ArrowElectronics/I.IMX8X_AI_ML/Hardware Docs/Block-Diagram/Block_Diagram.jpg

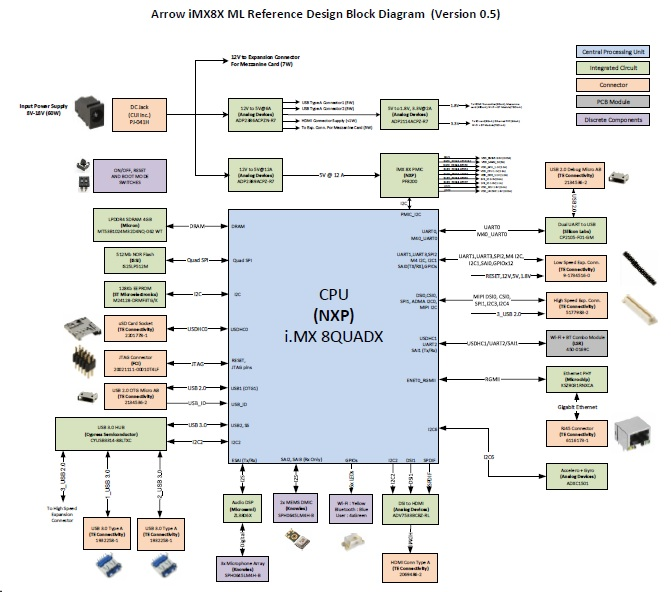
Hardware Docs/Block-Diagram/Block_Diagram.jpg
