ArrowElectronics/I.IMX8X_AI_ML/Kernel_5_4_47/readme.md

To setup the Yocto build environment, run yocto_build_setup_aiml.sh
After completion of the build setup, build SD card image (imx-image-full-imx8mqthor96.wic.bz2) will be generated.

For manual setup, please follow the Yocto_build_manual_step_aiml.txt steps.

Meta-einfochips available here, 
git clone https://github.com/ArrowElectronics/meta-einfochips.git -b ai_ml
