ArrowElectronics/I.IMX8X_AI_ML/Hardware Docs/Schematic/EI_ARROW_IMX8XML_RD_SCHEMATIC.pdf

SCH. REV.

# MAJOR REVISION HISTORY :

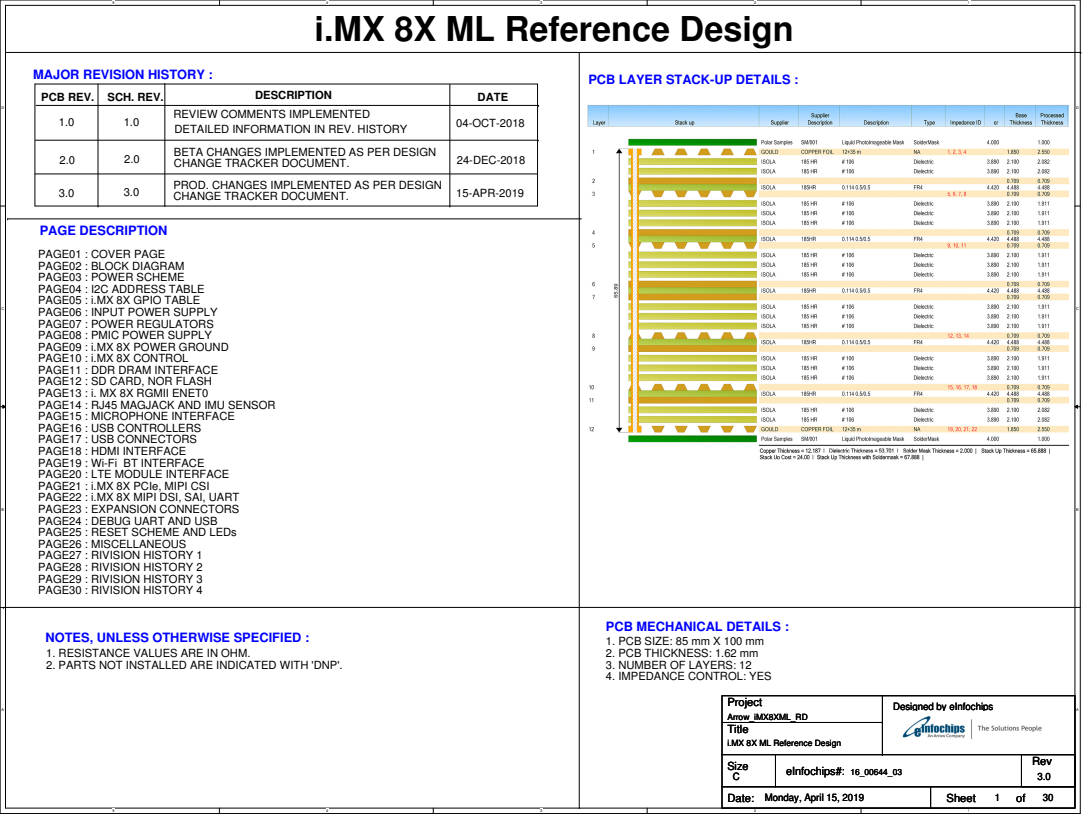
[picture p87: page 1]
PAGE DESCRIPTION; PCB REV.; DESCRIPTION; DATE; 24-DEC-2018 BETA CHANGES IMPLEMENTED AS PER DESIGN CHANGE TRACKER DOCUMENT.; CHANGE TRACKER DOCUMENT. 3.0; 15-APR-2019; Size; Rev; Date:; Sheet; eInfochips#:; Monday, April 15, 2019

i.MX 8X ML Reference Design

PCB LAYER STACK-UP DETAILS :

REVIEW COMMENTS IMPLEMENTED
04-OCT-2018 DETAILED INFORMATION IN REV. HISTORY

PROD. CHANGES IMPLEMENTED AS PER DESIGN

PAGE01 : COVER PAGE
PAGE02 : BLOCK DIAGRAM
PAGE03 : POWER SCHEME
PAGE04 : I2C ADDRESS TABLE
PAGE05 : i.MX 8X GPIO TABLE
PAGE06 : INPUT POWER SUPPLY
PAGE07 : POWER REGULATORS
PAGE08 : PMIC POWER SUPPLY
PAGE09 : i.MX 8X POWER GROUND
PAGE10 : i.MX 8X CONTROL
PAGE11 : DDR DRAM INTERFACE
PAGE12 : SD CARD, NOR FLASH
PAGE13 : i. MX 8X RGMII ENET0
PAGE14 : RJ45 MAGJACK AND IMU SENSOR
PAGE15 : MICROPHONE INTERFACE
PAGE16 : USB CONTROLLERS
PAGE17 : USB CONNECTORS
PAGE18 : HDMI INTERFACE
PAGE19 : Wi-Fi BT INTERFACE
PAGE20 : LTE MODULE INTERFACE
PAGE21 : i.MX 8X PCIe, MIPI CSI
PAGE22 : i.MX 8X MIPI DSI, SAI, UART
PAGE23 : EXPANSION CONNECTORS
PAGE24 : DEBUG UART AND USB
PAGE25 : RESET SCHEME AND LEDs
PAGE26 : MISCELLANEOUS
PAGE27 : RIVISION HISTORY 1
PAGE28 : RIVISION HISTORY 2
PAGE29 : RIVISION HISTORY 3
PAGE30 : RIVISION HISTORY 4

PCB MECHANICAL DETAILS :
1. PCB SIZE: 85 mm X 100 mm
2. PCB THICKNESS: 1.62 mm
3. NUMBER OF LAYERS: 12
4. IMPEDANCE CONTROL: YES

NOTES, UNLESS OTHERWISE SPECIFIED :
1. RESISTANCE VALUES ARE IN OHM.
2. PARTS NOT INSTALLED ARE INDICATED WITH 'DNP'.

Project
Arrow_iMX8XML_RD
Title

Designed by eInfochips

# BLOCK DIAGRAM

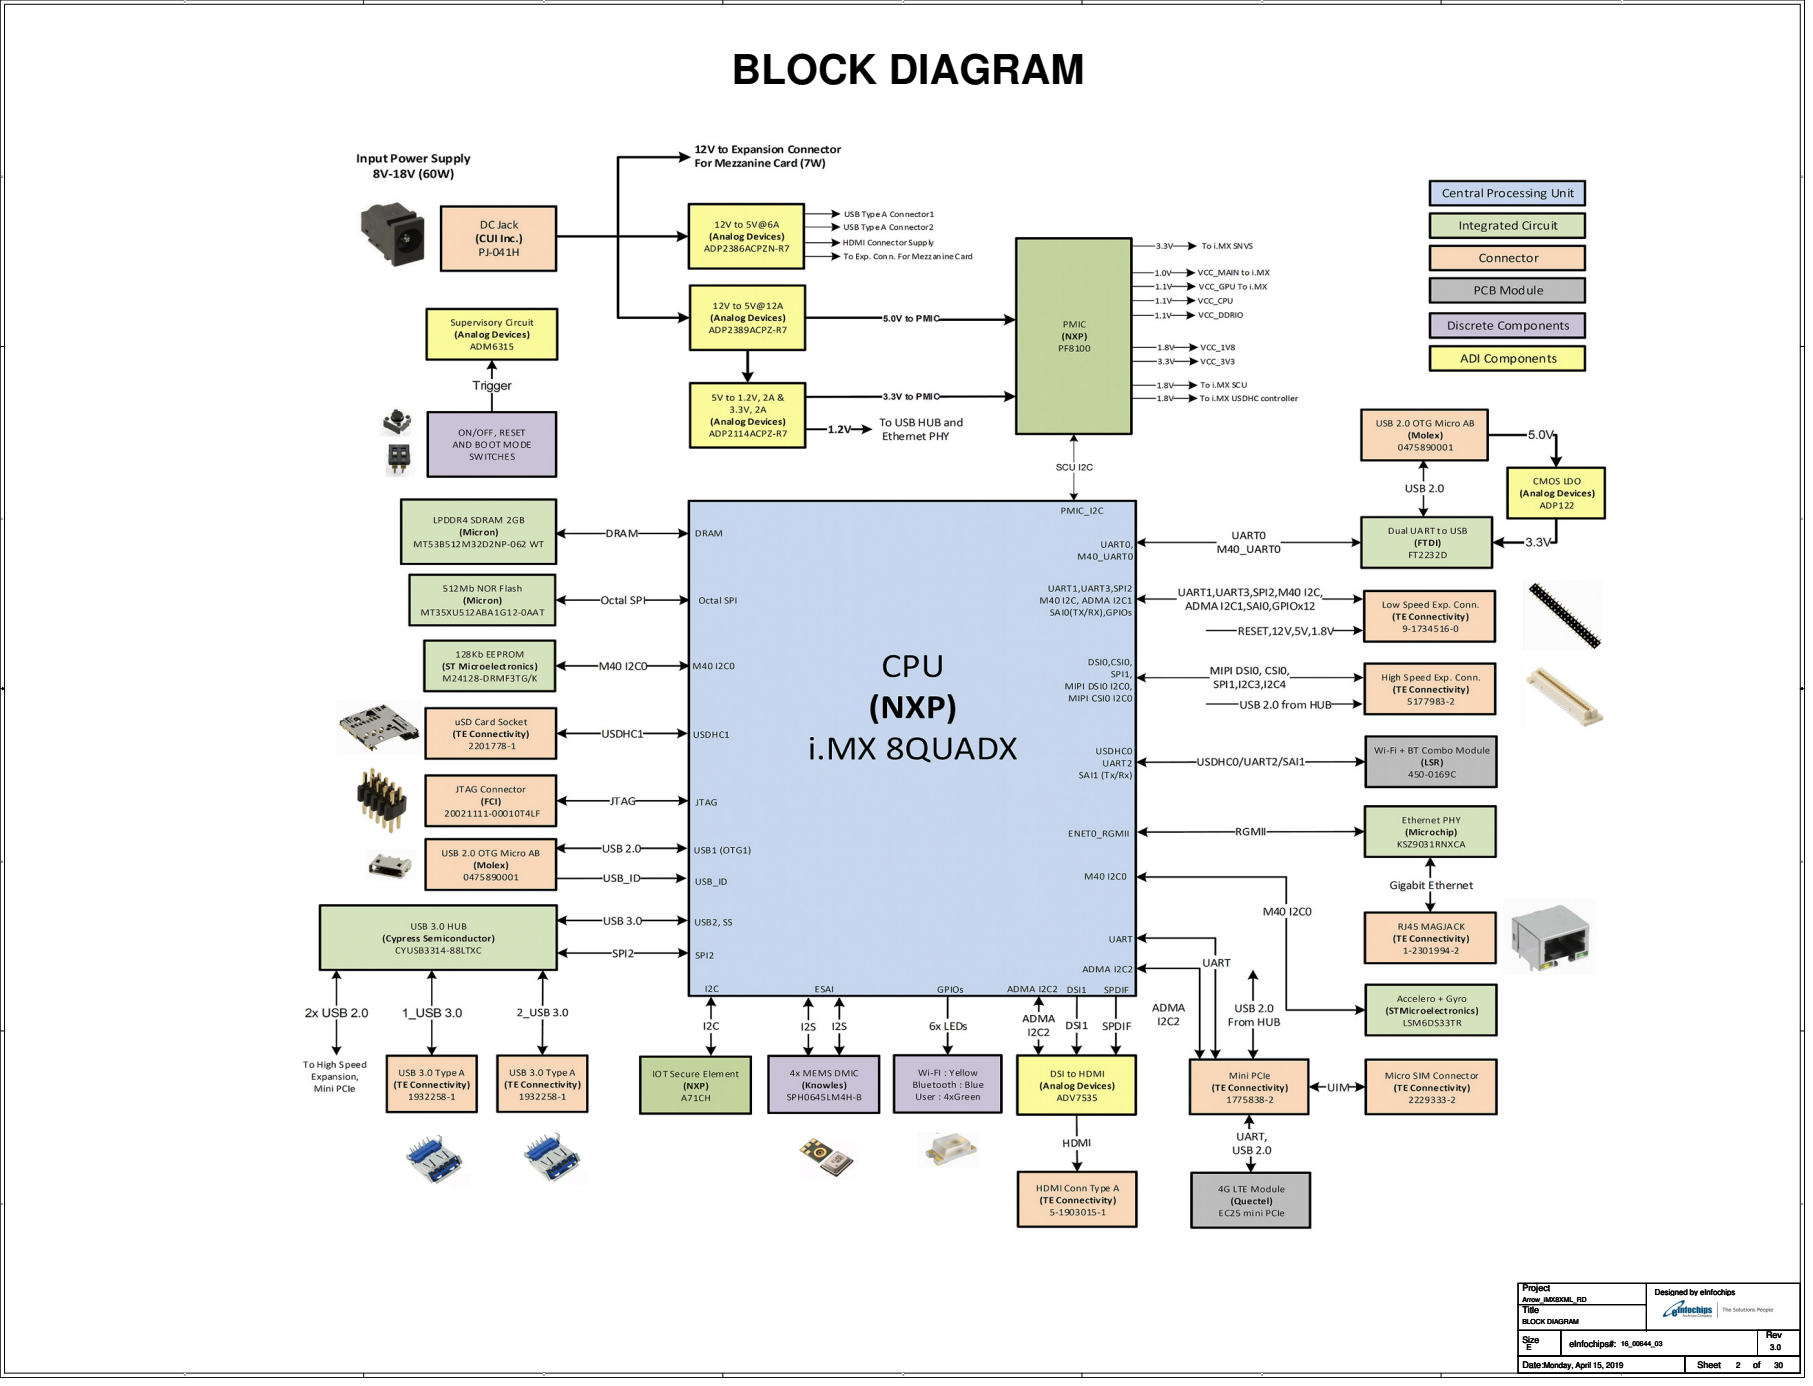
[picture p88: page 2]
Title; Project; Monday, April 15, 2019; Arrow_iMX8XML_RD; BLOCK DIAGRAM

Designed by eInfochips

# POWER SCHEME

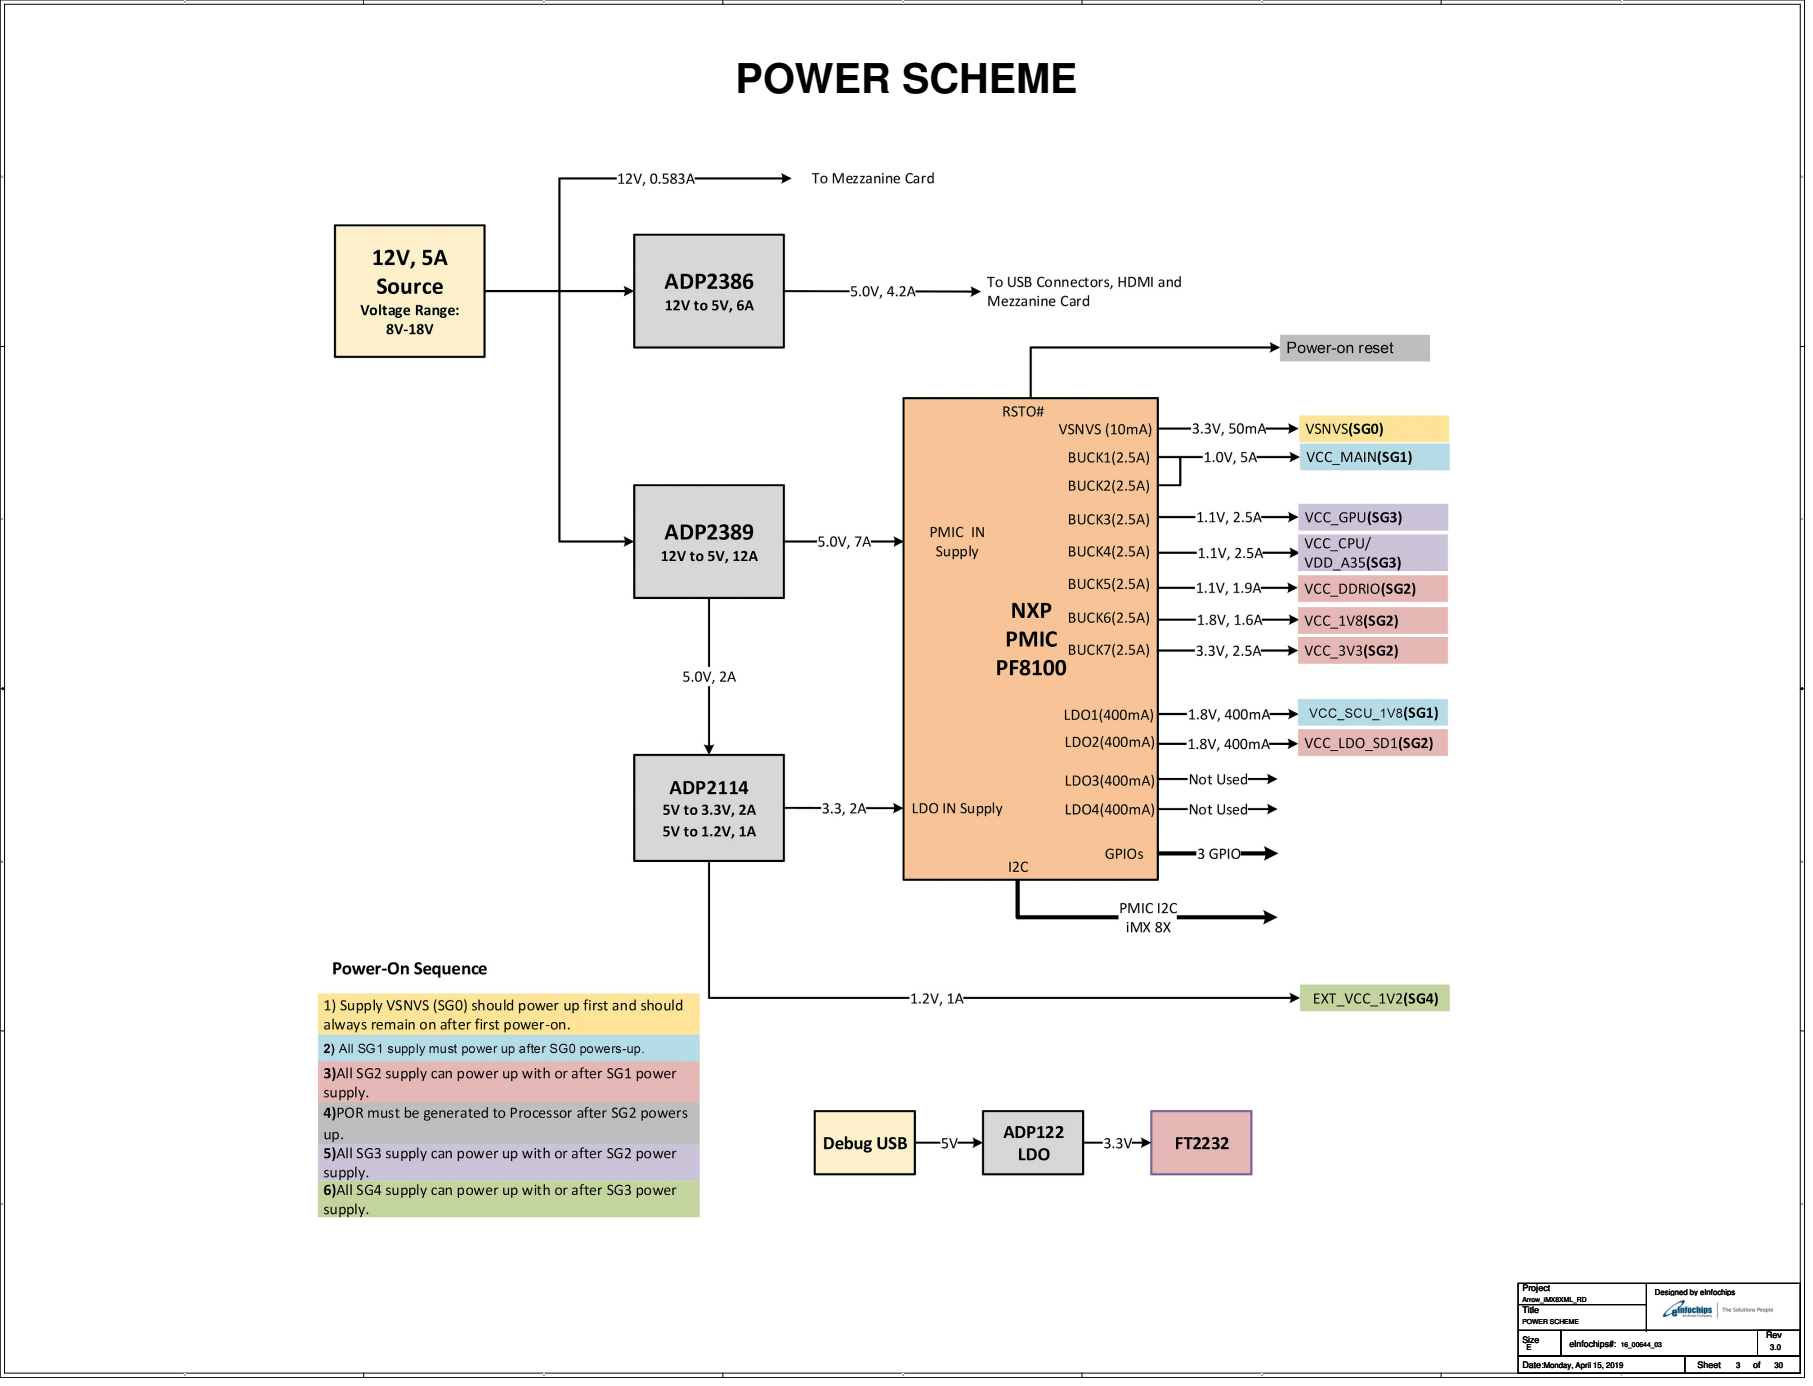
[picture p89: page 3]
Title; Project; Monday, April 15, 2019; Arrow_iMX8XML_RD; POWER SCHEME

Designed by eInfochips

# I2C ADDRESS TABLE

DEVICE | I2C

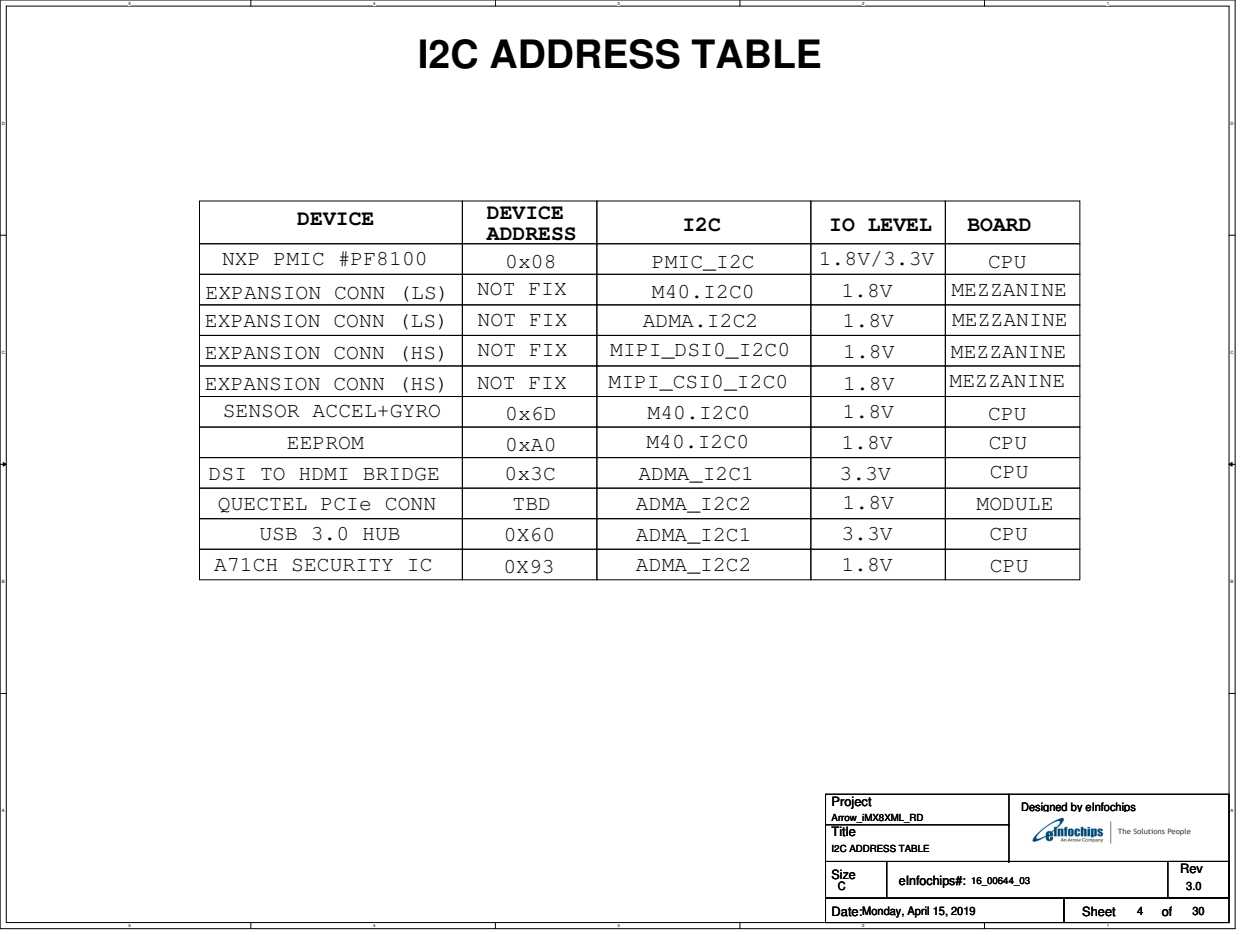
[picture p90: page 4]
NOT FIX; NXP PMIC #PF8100; CPU; MODULE; EEPROM; ADMA.I2C2; PMIC_I2C; DEVICE ADDRESS; TBD; BOARD; MIPI_CSI0_I2C0; MEZZANINE; ADMA_I2C1; ADMA_I2C2; MIPI_DSI0_I2C0; IO LEVEL; Title; Project; Monday, April 15, 2019; Arrow_iMX8XML_RD; I2C ADDRESS TABLE

EXPANSION CONN (LS)
EXPANSION CONN (HS)
SENSOR ACCEL+GYRO

DSI TO HDMI BRIDGE
QUECTEL PCIe CONN
USB 3.0 HUB
A71CH SECURITY IC

Designed by eInfochips

# i.MX 8X GPIO TABLE

# GPIO BANK3

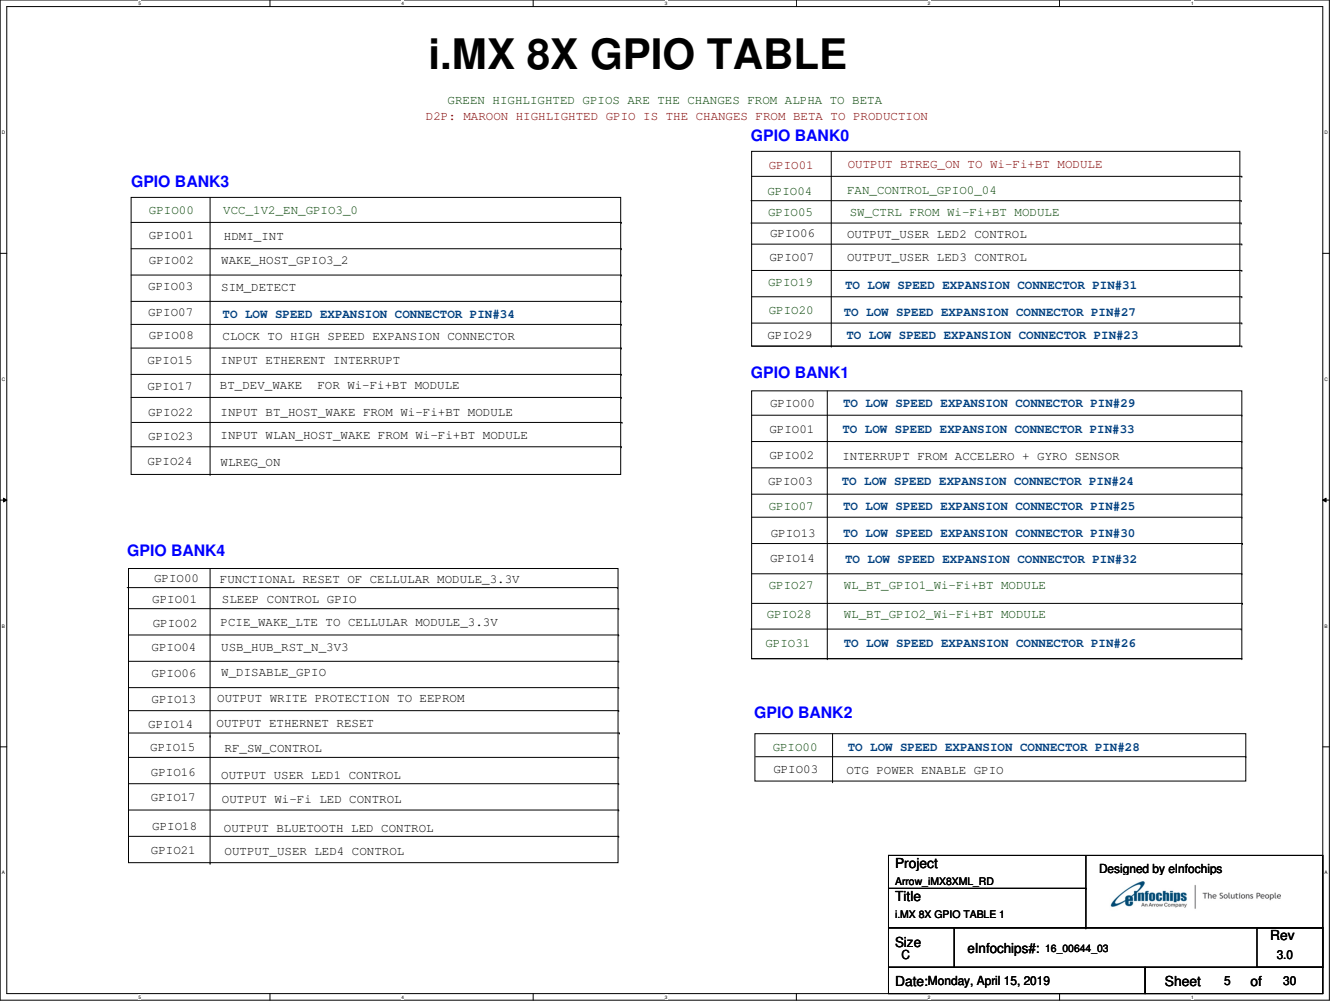
[picture p91: page 5]
GPIO22; GPIO15; GPIO23; BT_DEV_WAKE; FOR Wi-Fi+BT MODULE; GPIO02; GPIO17; SIM_DETECT; GPIO08; CLOCK TO HIGH SPEED EXPANSION CONNECTOR; GPIO07; GPIO01; GPIO00; GPIO03; HDMI_INT; WLREG_ON; VCC_1V2_EN_GPIO3_0; WAKE_HOST_GPIO3_2; GPIO24; GPIO04; FAN_CONTROL_GPIO0_04; GPIO19; GPIO29; GPIO20; GPIO BANK2; OUTPUT_USER LED2 CONTROL; OUTPUT_USER LED3 CONTROL; GPIO06; GPIO BANK0; GPIO05; GPIO28; GPIO BANK1; INTERRUPT FROM ACCELERO + GYRO SENSOR; GPIO14; GPIO13; GPIO27; GPIO31; GPIO18; W_DISABLE_GPIO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

GREEN HIGHLIGHTED GPIOS ARE THE CHANGES FROM ALPHA TO BETA
D2P: MAROON HIGHLIGHTED GPIO IS THE CHANGES FROM BETA TO PRODUCTION

SW_CTRL FROM Wi-Fi+BT MODULE

TO LOW SPEED EXPANSION CONNECTOR PIN#31

TO LOW SPEED EXPANSION CONNECTOR PIN#34

TO LOW SPEED EXPANSION CONNECTOR PIN#27

TO LOW SPEED EXPANSION CONNECTOR PIN#23

INPUT ETHERENT INTERRUPT

TO LOW SPEED EXPANSION CONNECTOR PIN#29

INPUT BT_HOST_WAKE FROM Wi-Fi+BT MODULE

TO LOW SPEED EXPANSION CONNECTOR PIN#33

INPUT WLAN_HOST_WAKE FROM Wi-Fi+BT MODULE

TO LOW SPEED EXPANSION CONNECTOR PIN#24

TO LOW SPEED EXPANSION CONNECTOR PIN#25

TO LOW SPEED EXPANSION CONNECTOR PIN#30

TO LOW SPEED EXPANSION CONNECTOR PIN#32

FUNCTIONAL RESET OF CELLULAR MODULE_3.3V
SLEEP CONTROL GPIO

WL_BT_GPIO1_Wi-Fi+BT MODULE

WL_BT_GPIO2_Wi-Fi+BT MODULE

TO LOW SPEED EXPANSION CONNECTOR PIN#26

OUTPUT WRITE PROTECTION TO EEPROM

OUTPUT ETHERNET RESET

TO LOW SPEED EXPANSION CONNECTOR PIN#28

OUTPUT USER LED1 CONTROL

OTG POWER ENABLE GPIO

OUTPUT Wi-Fi LED CONTROL

OUTPUT BLUETOOTH LED CONTROL

Designed by eInfochips

# INPUT POWER SUPPLY

# INPUT POWER & PROTECTION CIRCUIT

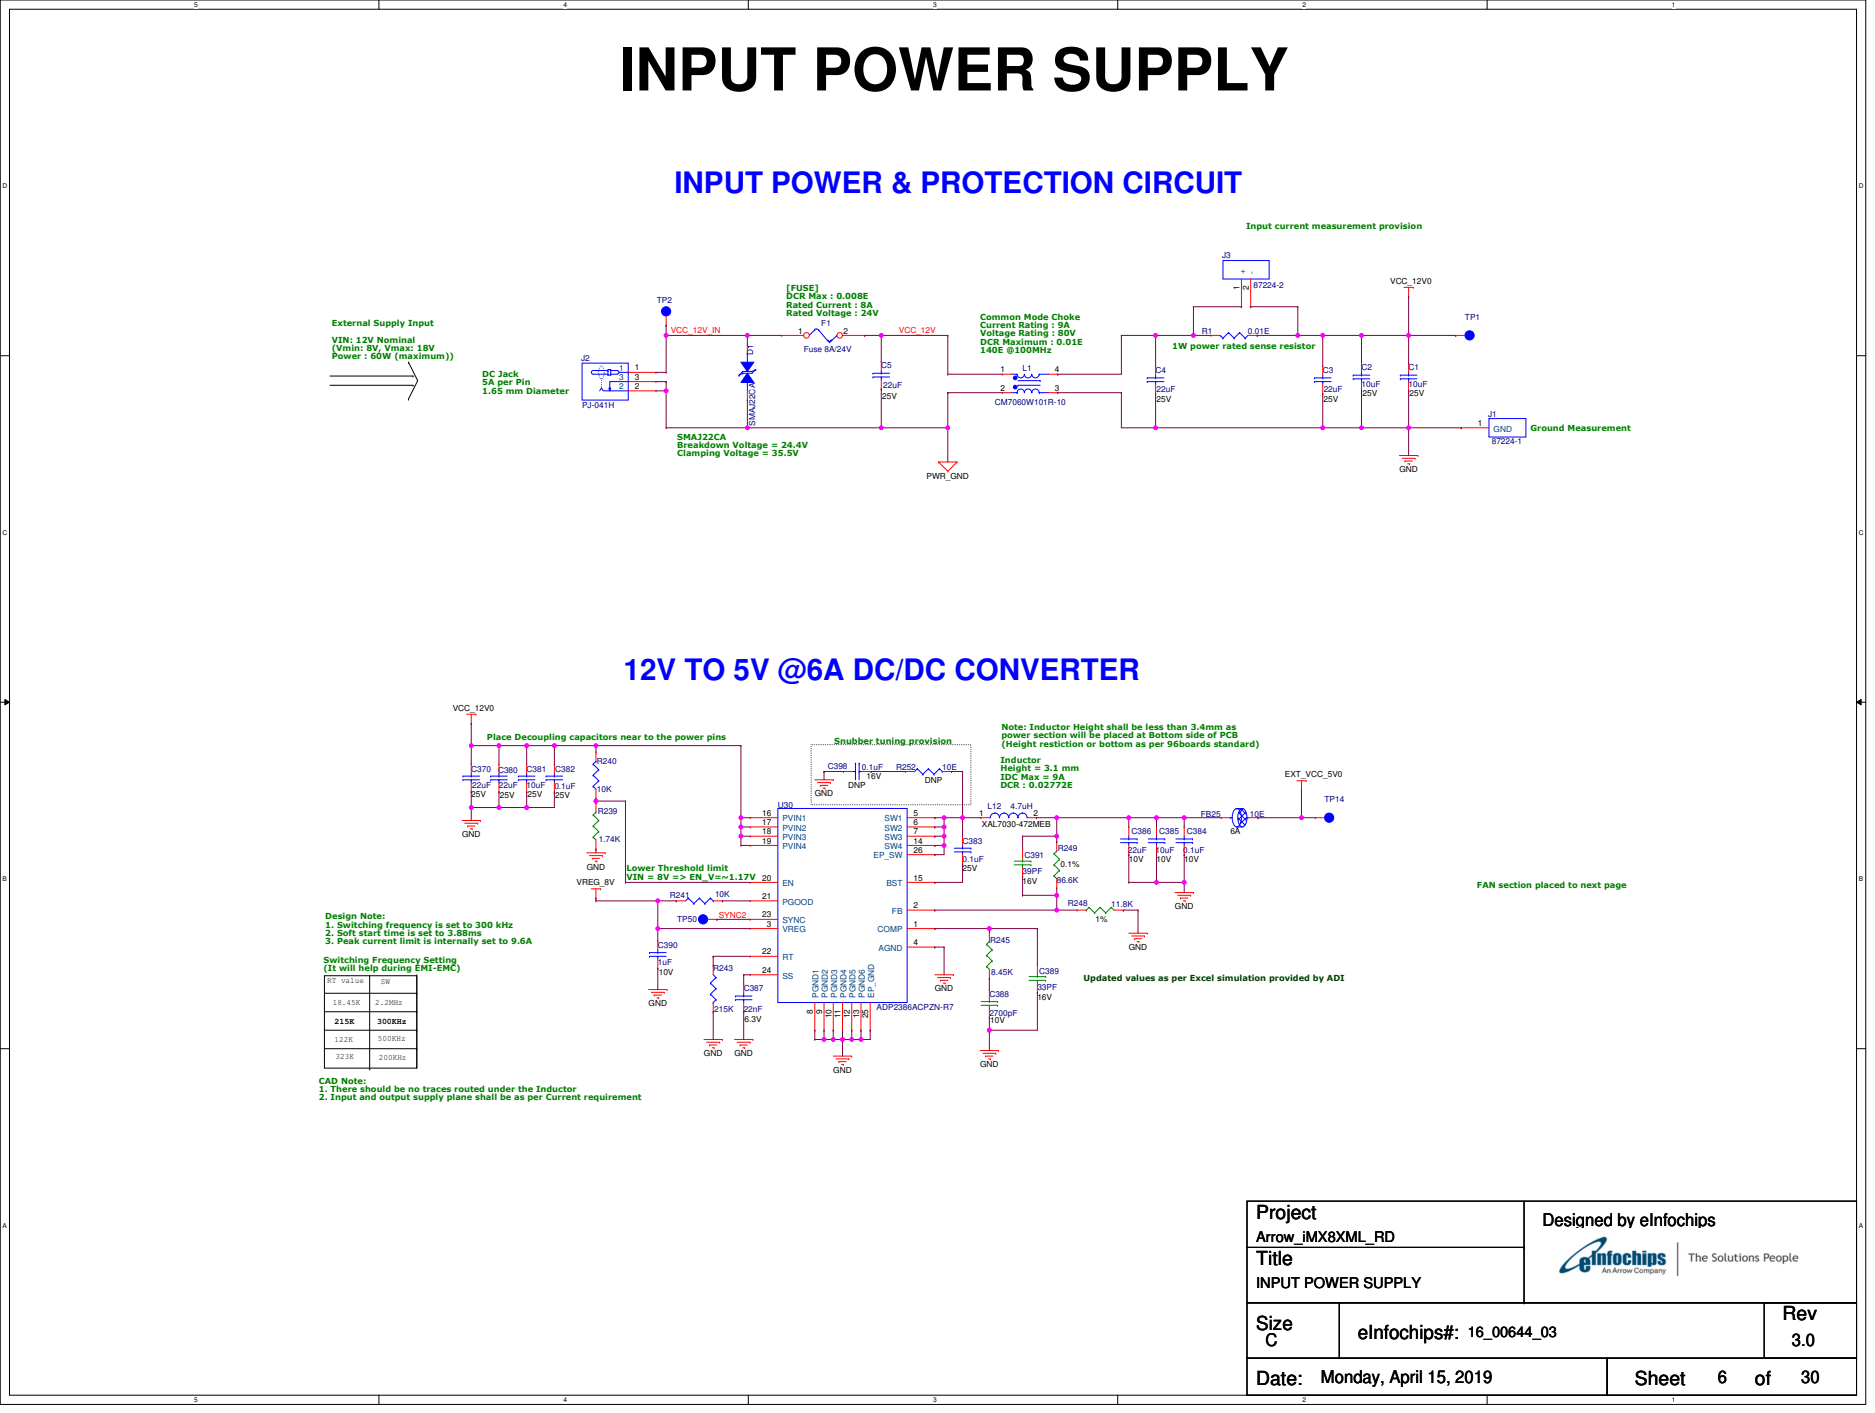
[picture p92: page 6]

Input current measurement provision

1W power rated sense resistor

12V TO 5V @6A DC/DC CONVERTER

Note: Inductor Height shall be less than 3.4mm as
power section will be placed at Bottom side of PCB
(Height restiction or bottom as per 96boards standard)

Place Decoupling capacitors near to the power pins

FAN section placed to next page

Design Note:
1. Switching frequency is set to 300 kHz
2. Soft start time is set to 3.88ms
3. Peak current limit is internally set to 9.6A

Switching Frequency Setting
(It will help during EMI-EMC)

Updated values as per Excel simulation provided by ADI

CAD Note:
1. There should be no traces routed under the Inductor
2. Input and output supply plane shall be as per Current requirement

# POWER REGULATORS

# 12V TO 5V @12A DC/DC CONVERTER

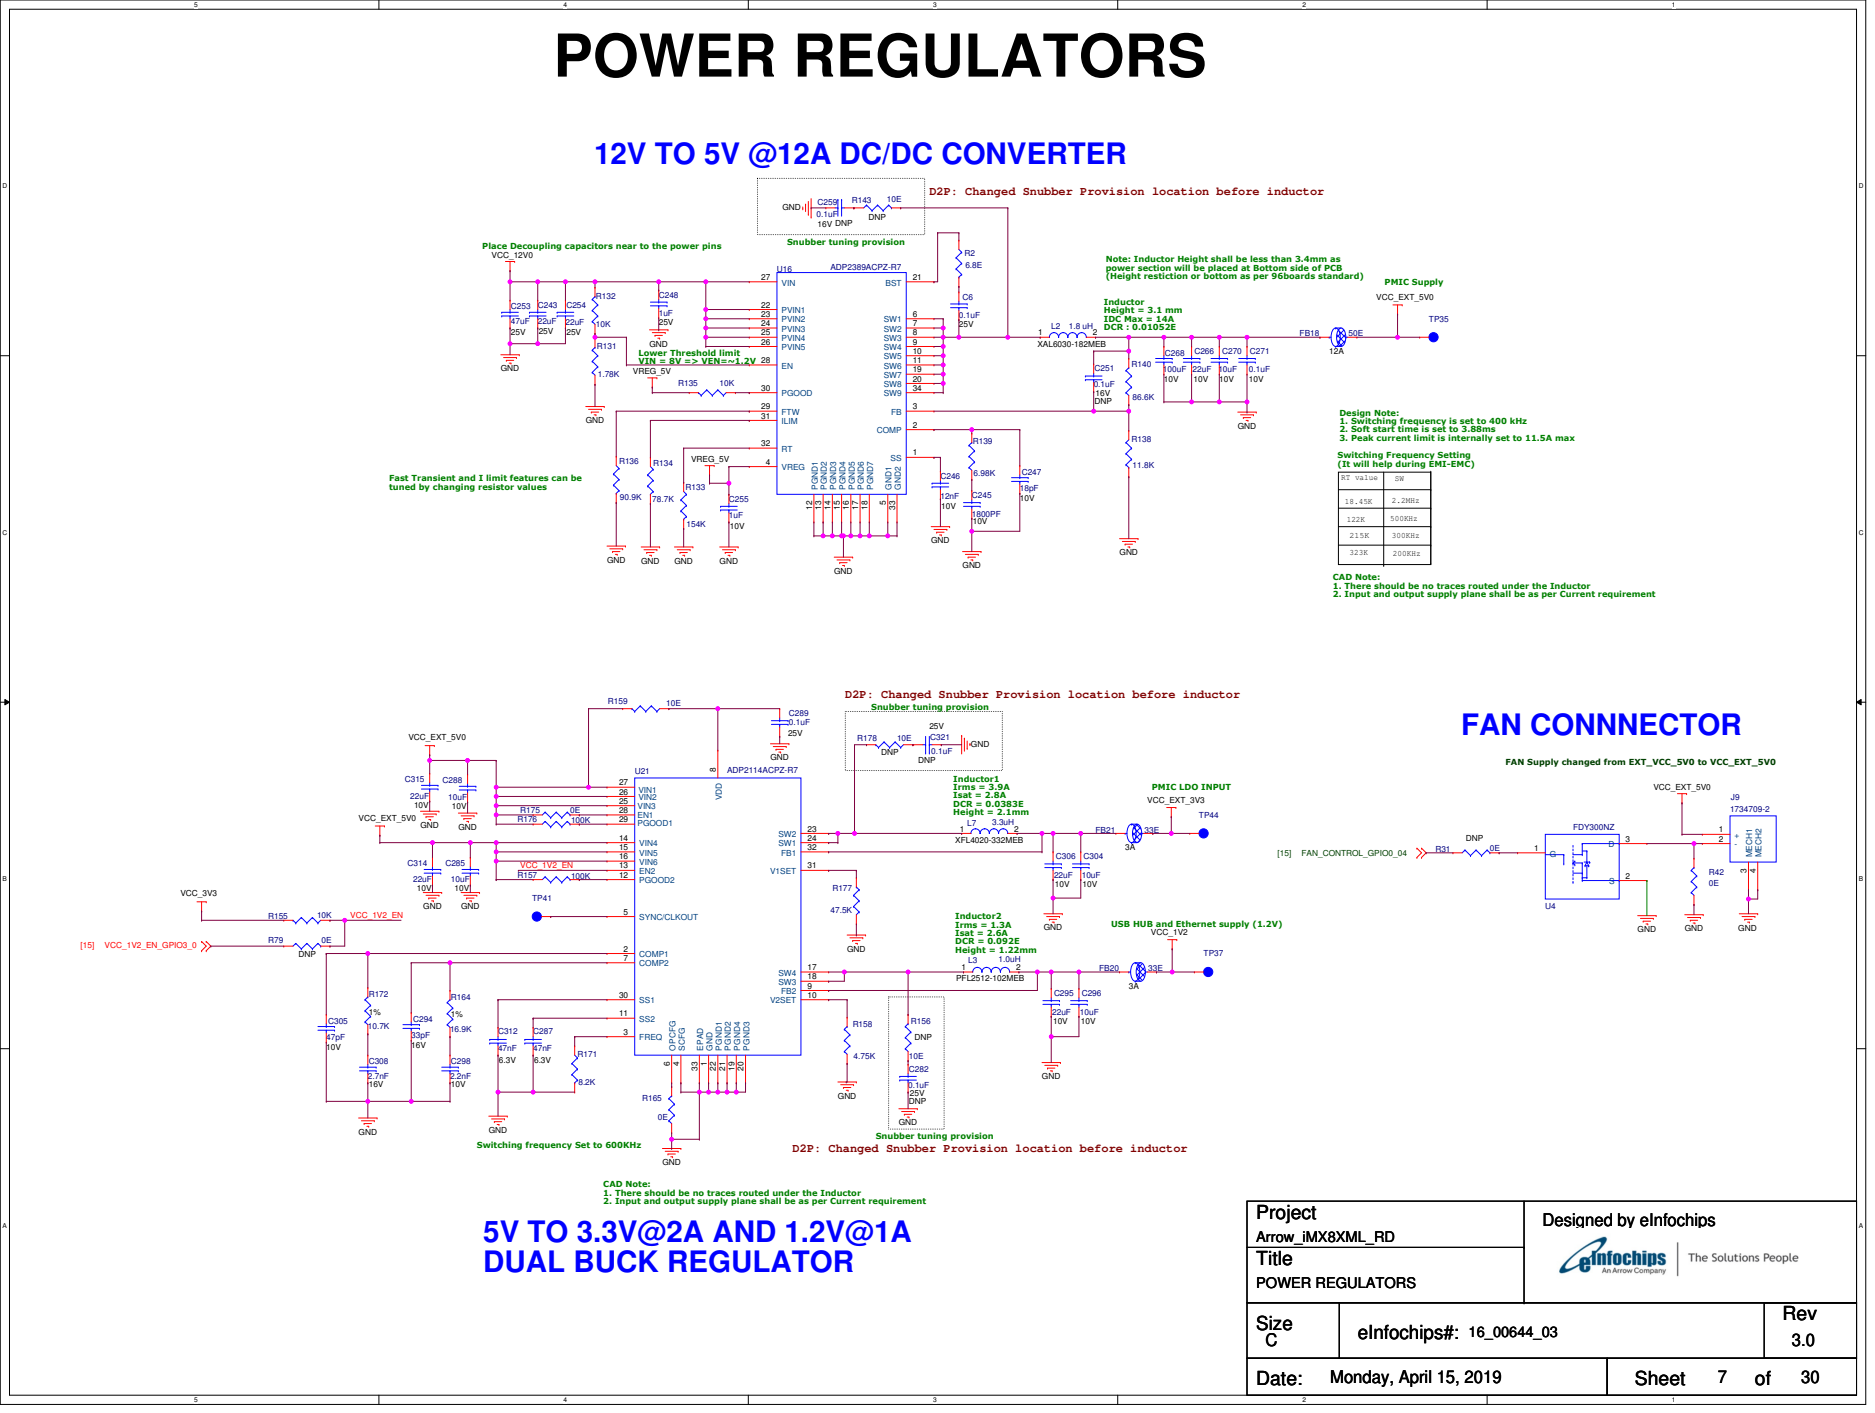
[picture p93: page 7]

D2P: Changed Snubber Provision location before inductor

Place Decoupling capacitors near to the power pins
VCC_12V0

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

Design Note:
1. Switching frequency is set to 400 kHz
2. Soft start time is set to 3.88ms
3. Peak current limit is internally set to 11.5A max

Switching Frequency Setting
(It will help during EMI-EMC)

Fast Transient and I limit features can be
tuned by changing resistor values

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

FAN Supply changed from EXT_VCC_5V0 to VCC_EXT_5V0

USB HUB and Ethernet supply (1.2V)

Switching frequency Set to 600KHz

# PMIC POWER SUPPLY AND LDOS

# Whole PMIC section is newely added

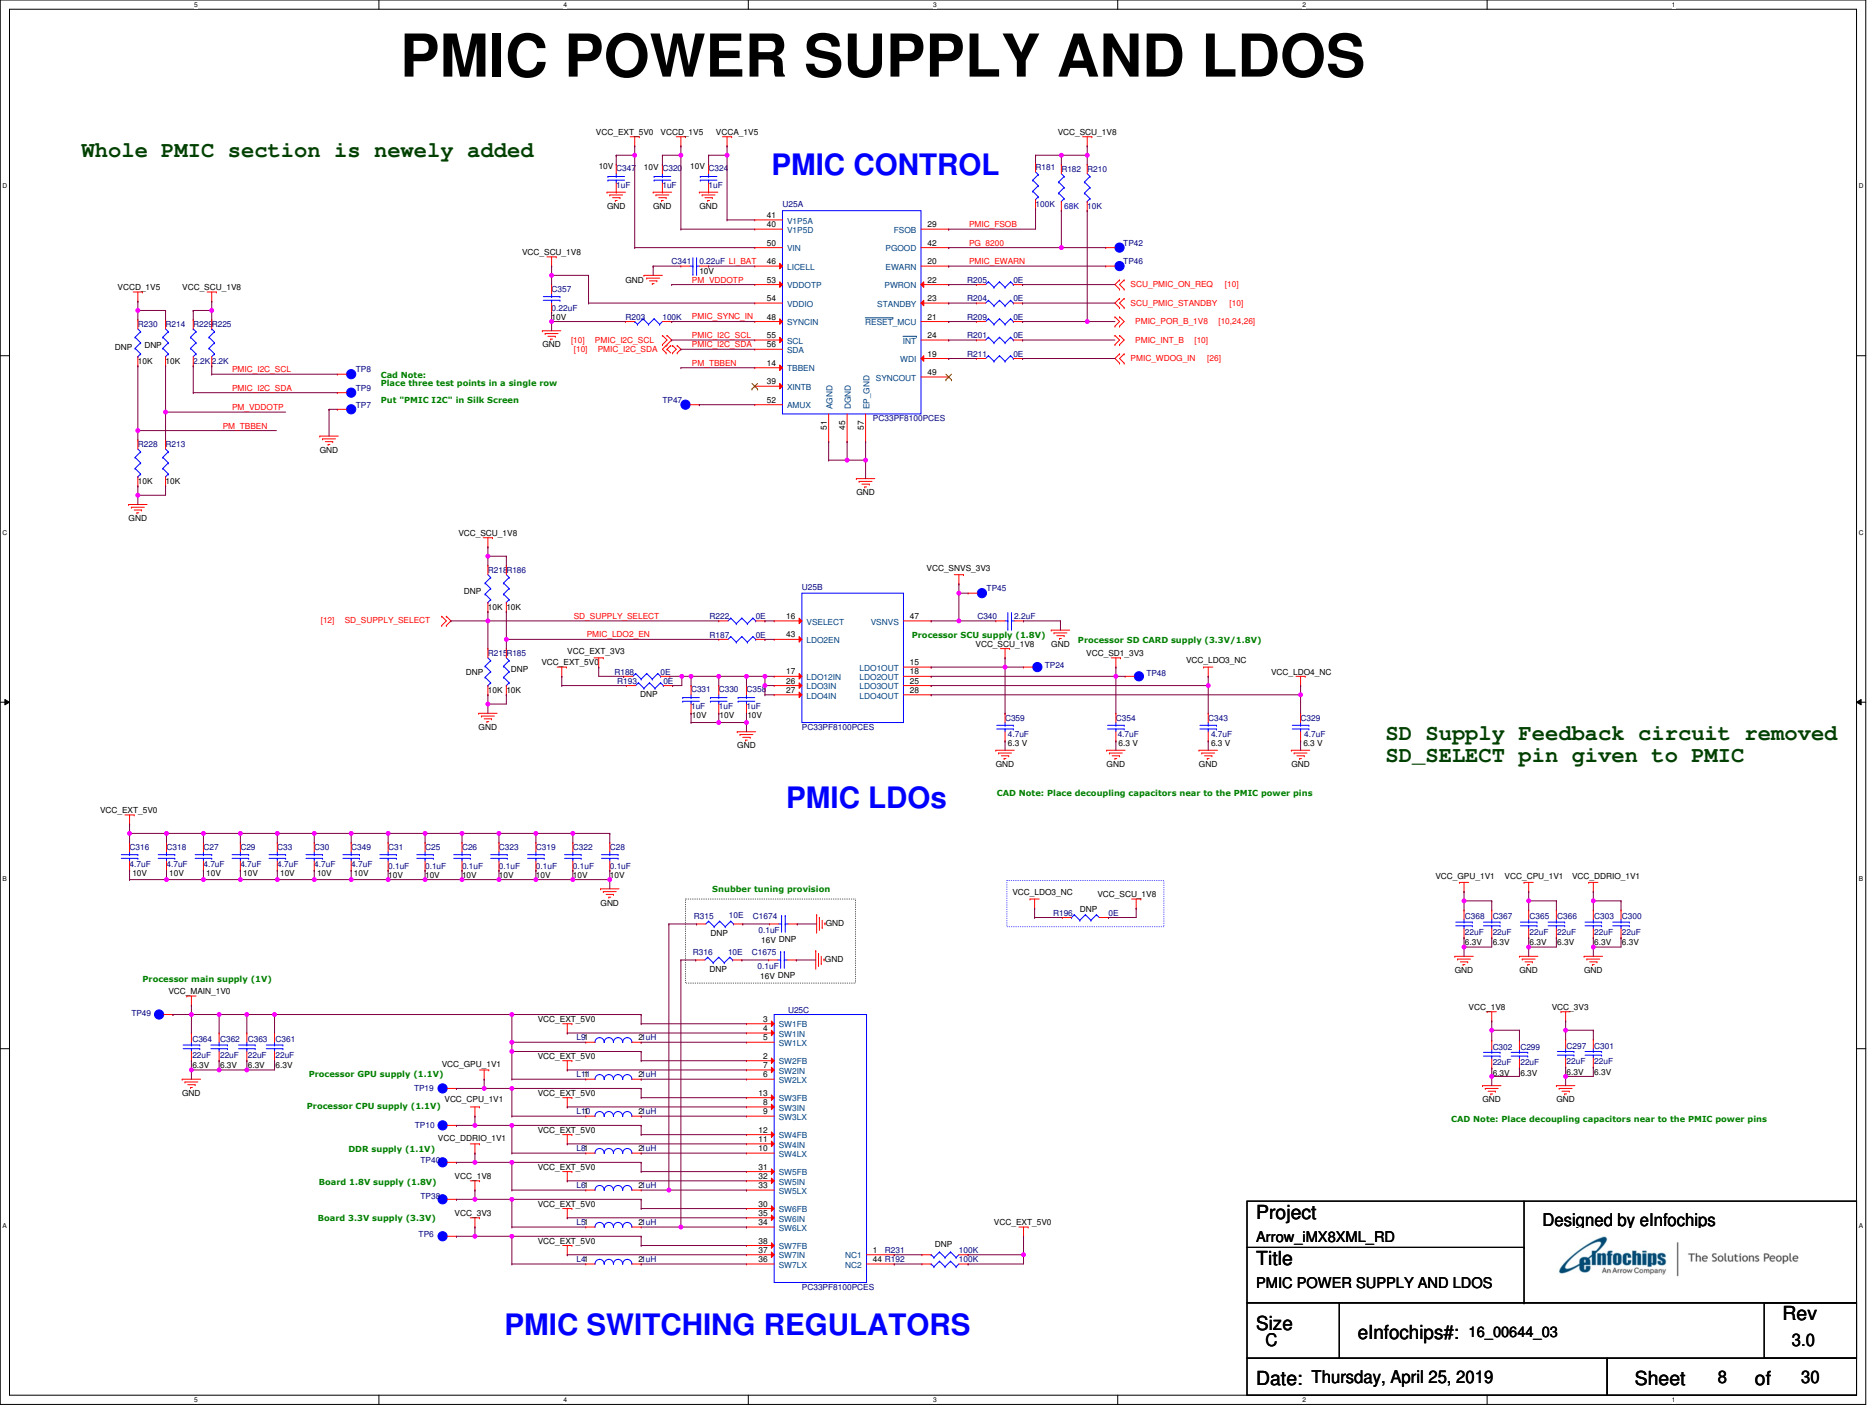
[picture p94: page 8]

Cad Note:
Place three test points in a single row
Put "PMIC I2C" in Silk Screen

SD Supply Feedback circuit removed
SD_SELECT pin given to PMIC

CAD Note: Place decoupling capacitors near to the PMIC power pins

# i.MX 8X POWER GROUND

# i.MX 8X GROUND

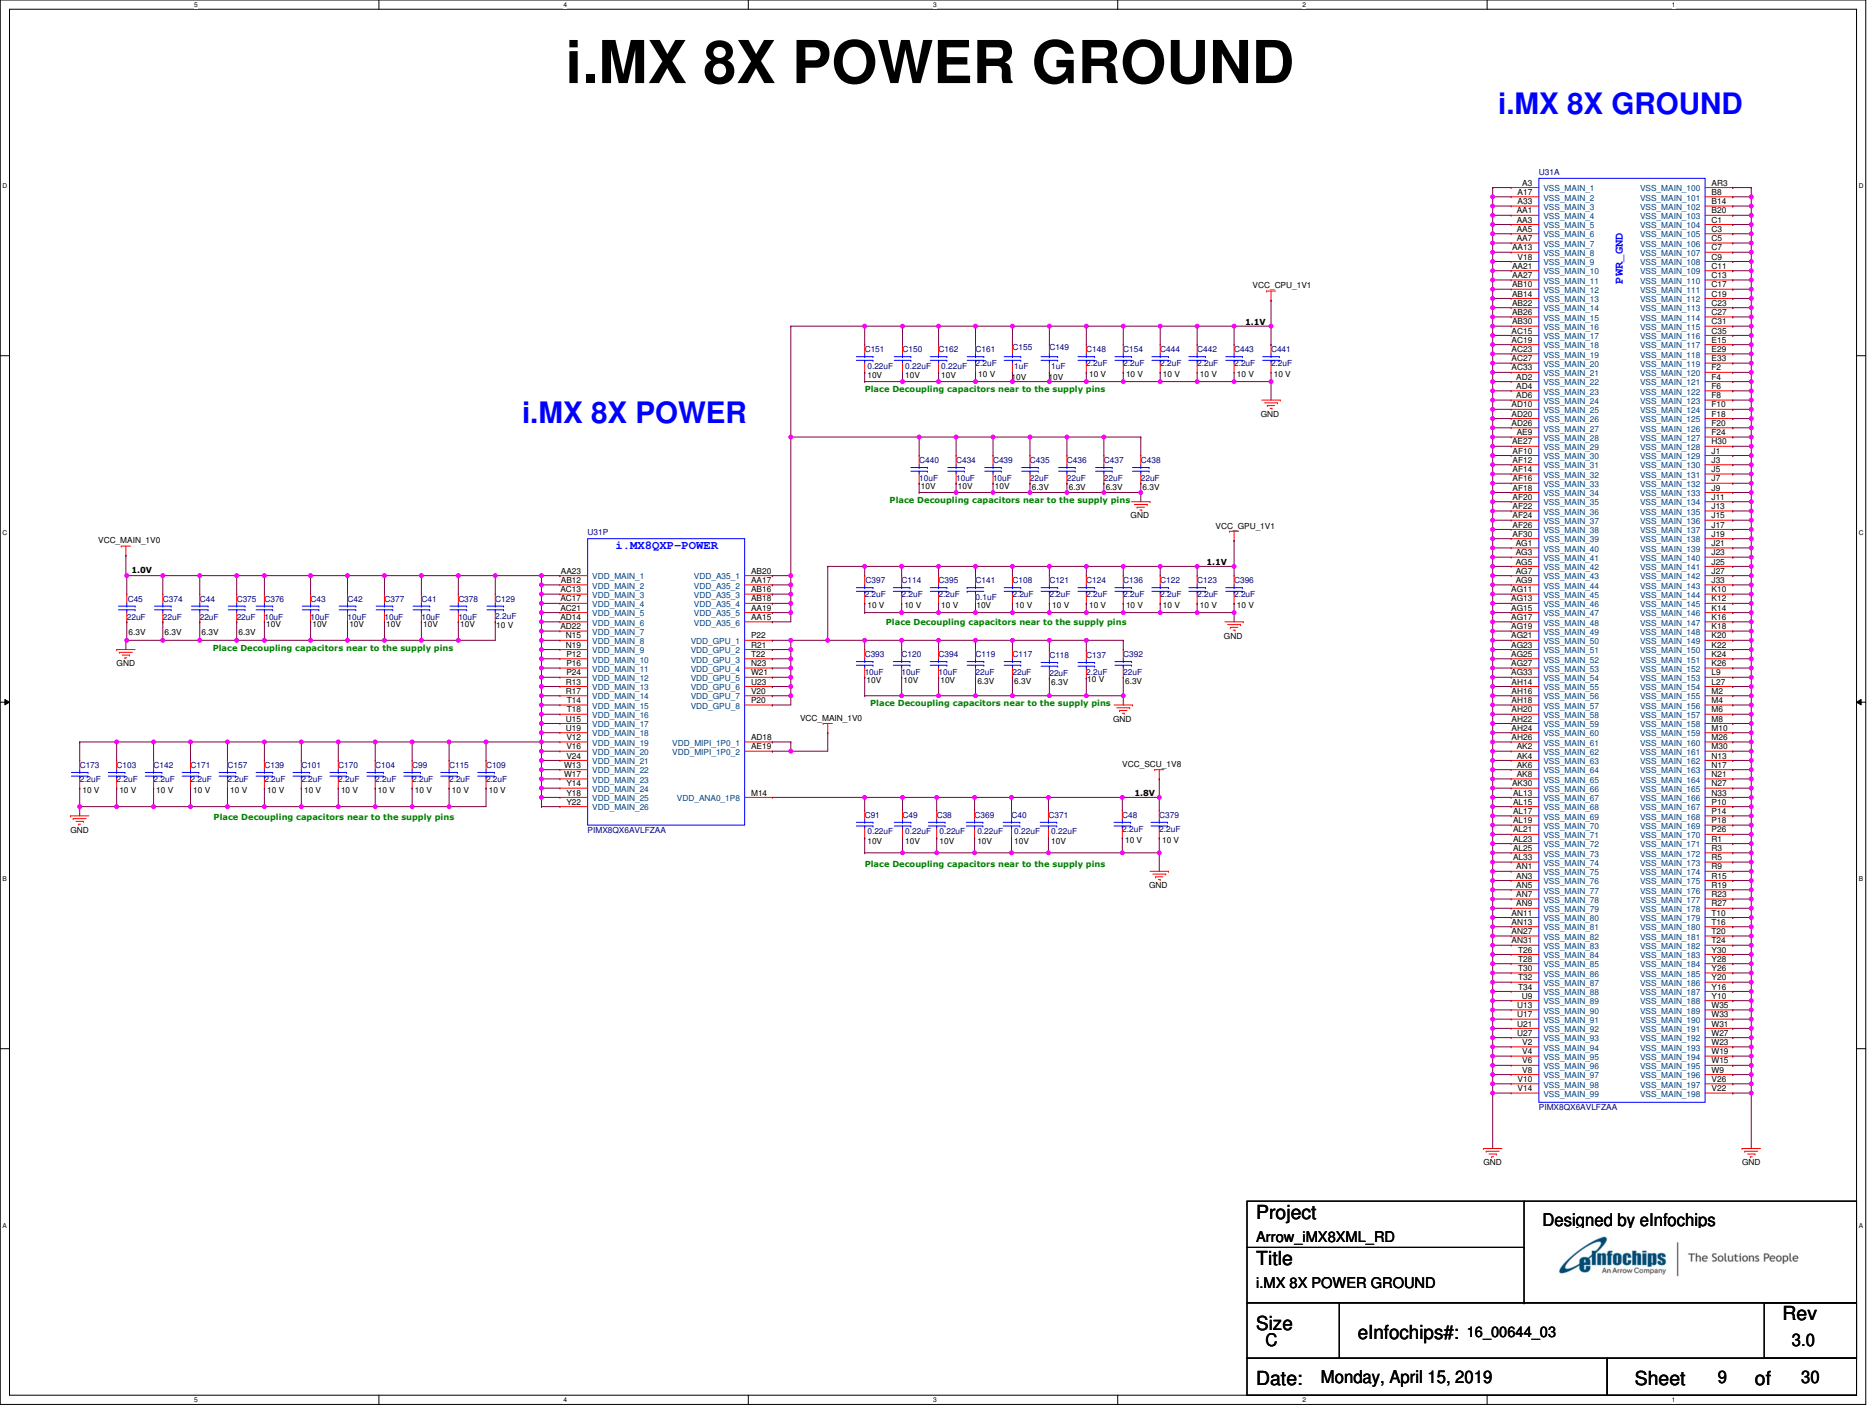
[picture p95: page 9]

Place Decoupling capacitors near to the supply pins

# i.MX 8X CONTROL

### i.MX8QXP-SYSTEM

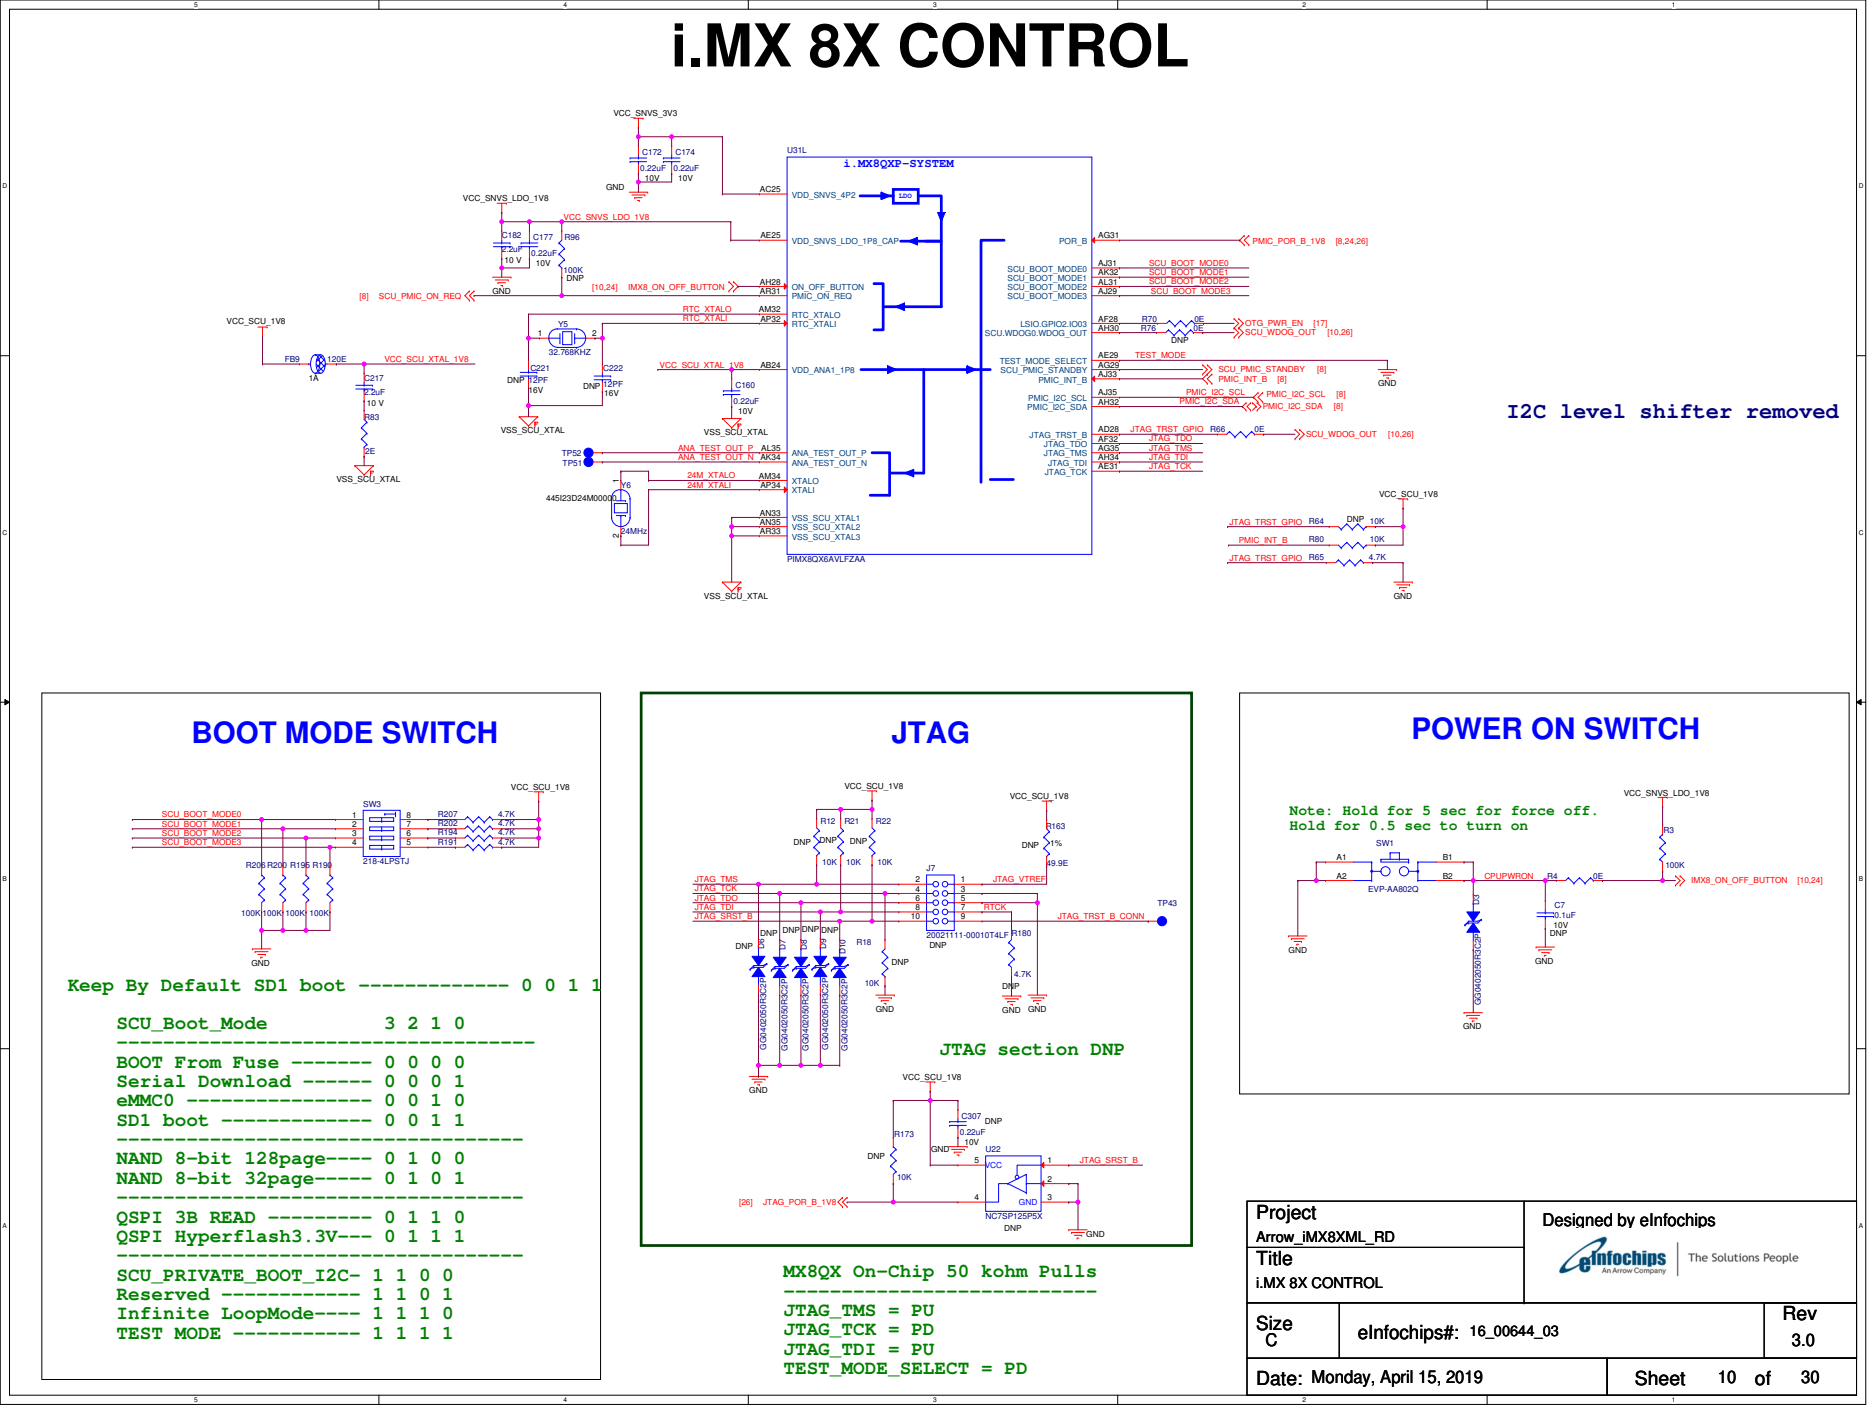
[picture p96: page 10]

Note: Hold for 5 sec for force off.
Hold for 0.5 sec to turn on

Keep By Default SD1 boot ------------- 0 0 1 1

NAND 8-bit 32page----- 0 1 0 1 ----------------------------------- QSPI 3B READ --------- 0 1 1 0

# DDR DRAM INTERFACE

## Place Decoupling capacitors near to pins

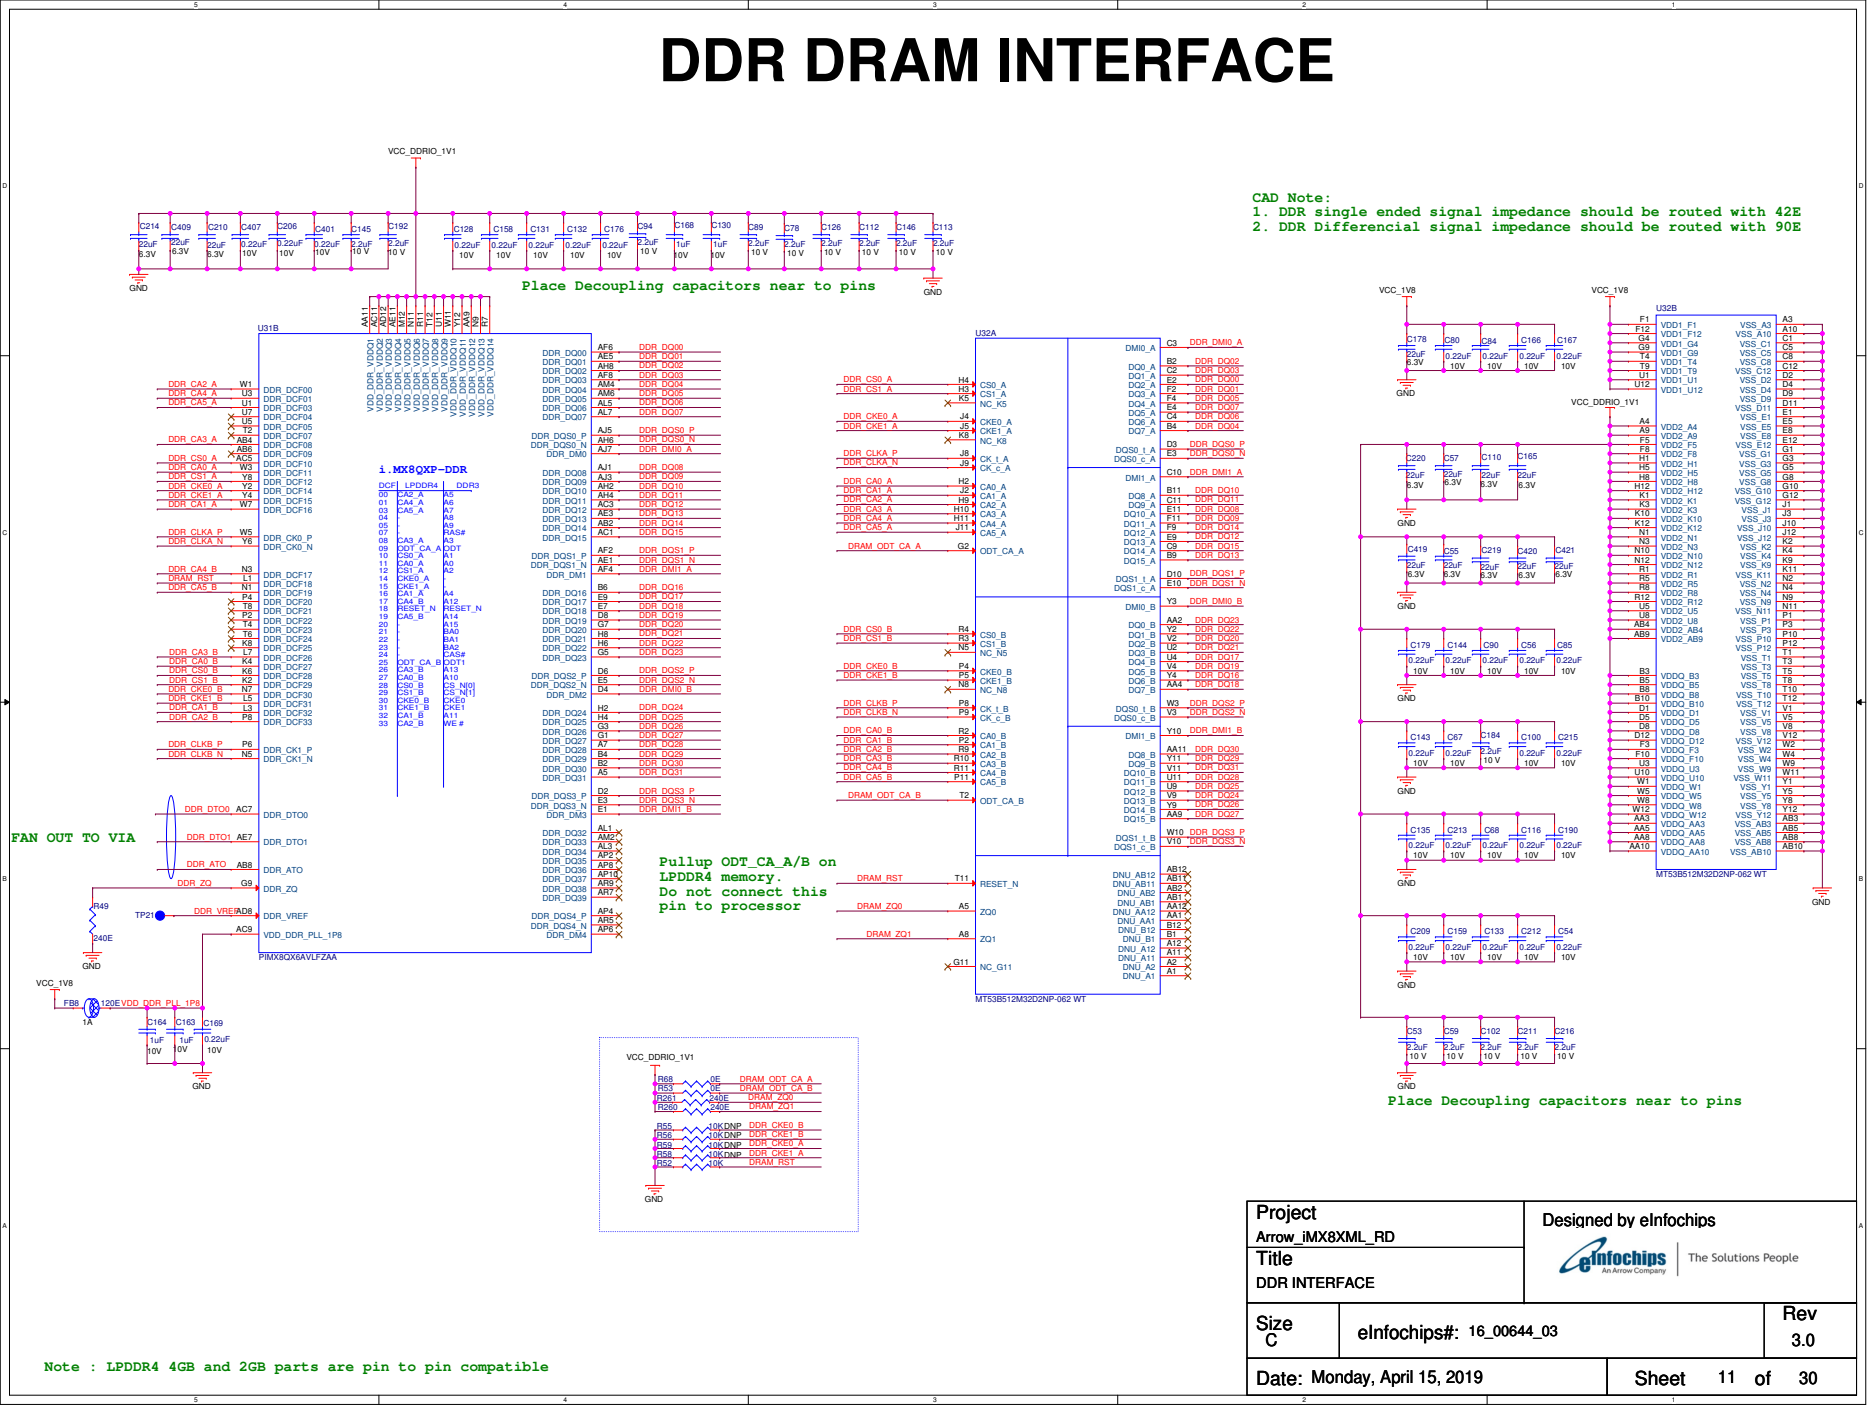
[picture p97: page 11]

CAD Note:
1. DDR single ended signal impedance should be routed with 42E
2. DDR Differencial signal impedance should be routed with 90E

FAN OUT TO VIA

Pullup ODT_CA_A/B on
LPDDR4 memory.
Do not connect this
pin to processor

GND
Place Decoupling capacitors near to pins

Note : LPDDR4 4GB and 2GB parts are pin to pin compatible

# SD CARD, NOR FLASH AND EEPROM

### 1.8Volt QSPI0A and QSPI0B

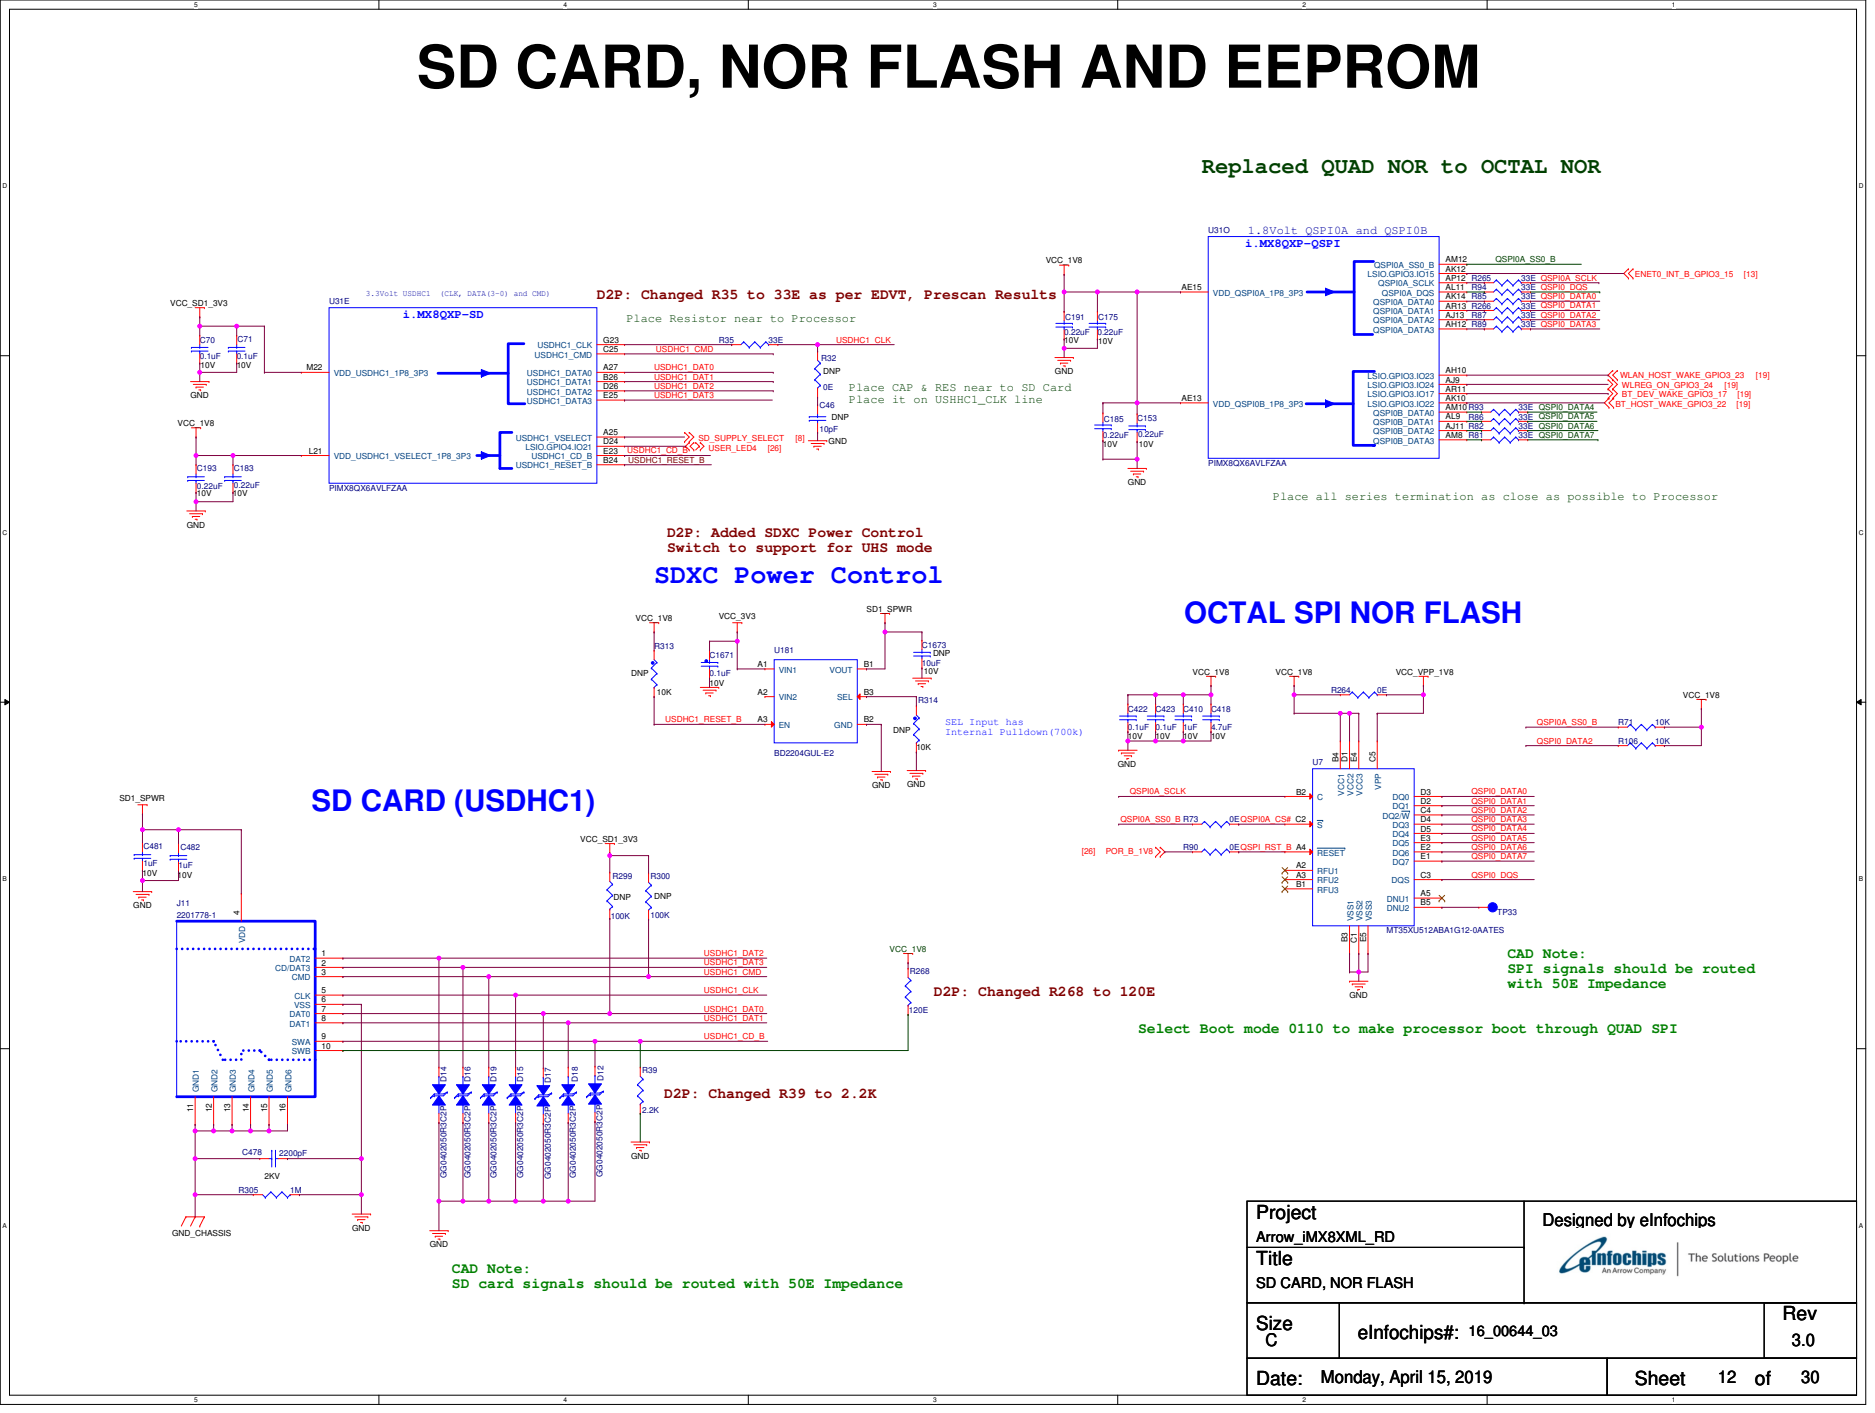
[picture p98: page 12]

Replaced QUAD NOR to OCTAL NOR

D2P: Changed R35 to 33E as per EDVT, Prescan Results

Place Resistor near to Processor

DNP
Place CAP & RES near to SD Card
Place it on USHHC1_CLK line

Place all series termination as close as possible to Processor

D2P: Added SDXC Power Control
Switch to support for UHS mode
SDXC Power Control

OCTAL SPI NOR FLASH

CAD Note:
SPI signals should be routed
with 50E Impedance

Select Boot mode 0110 to make processor boot through QUAD SPI

GND
SD card signals should be routed with 50E Impedance

# i. MX 8X RGMII ENET0

### D2P: Make R40, R9 = 50E

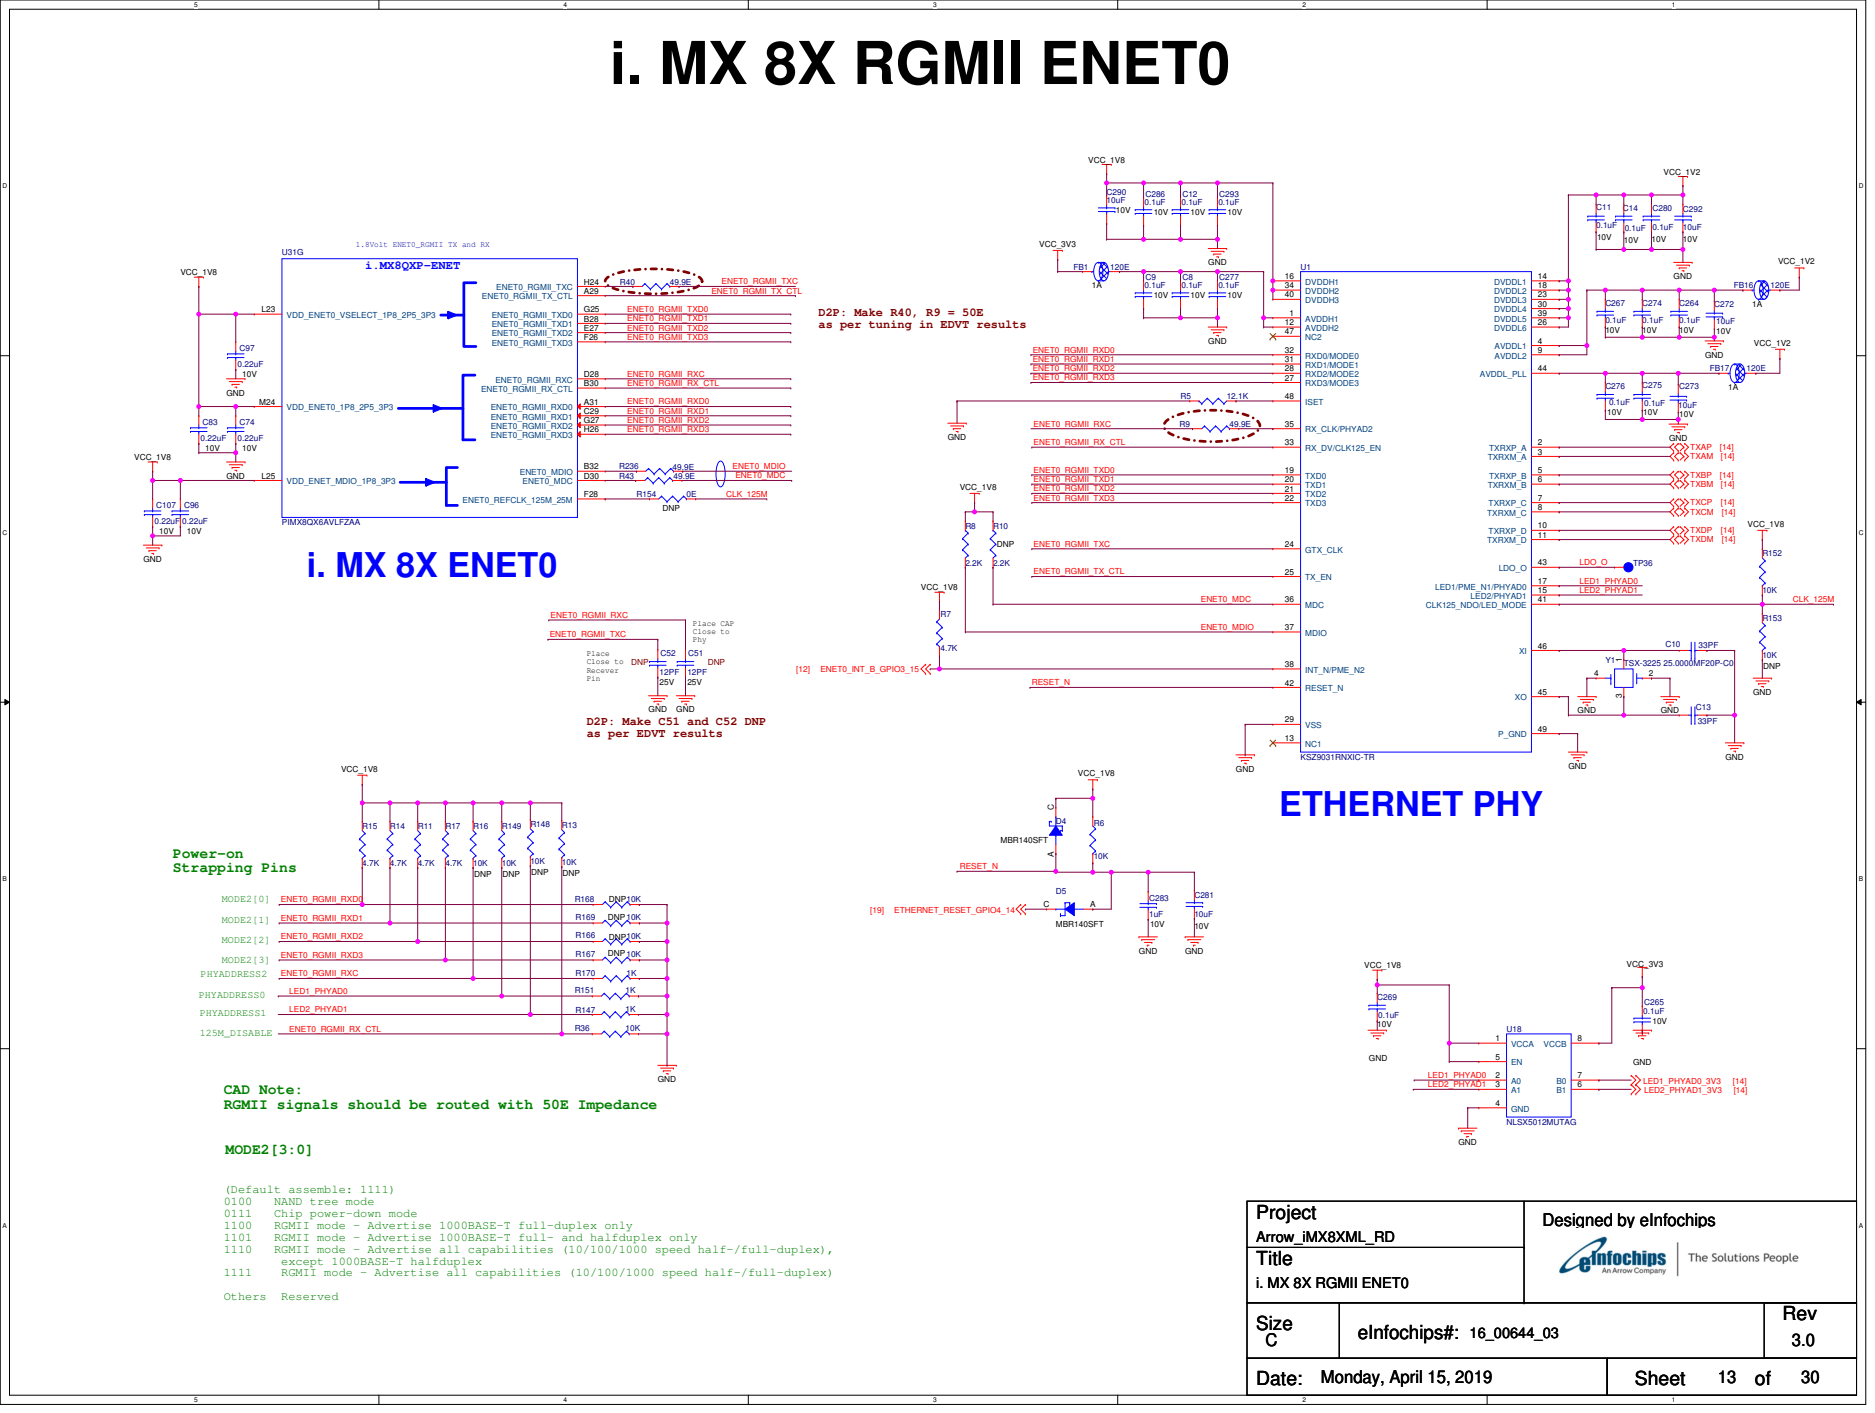
[picture p99: page 13]

as per tuning in EDVT results

D2P: Make C51 and C52 DNP
as per EDVT results

CAD Note:
RGMII signals should be routed with 50E Impedance

(Default assemble: 1111)
0100 NAND tree mode
0111 Chip power-down mode
1100 RGMII mode - Advertise 1000BASE-T full-duplex only
1101 RGMII mode - Advertise 1000BASE-T full- and halfduplex only
1110 RGMII mode - Advertise all capabilities (10/100/1000 speed half-/full-duplex),

1111 RGMII mode - Advertise all capabilities (10/100/1000 speed half-/full-duplex)

# RJ45 MAGJACK, IMU SENSOR AND SECURITY IC

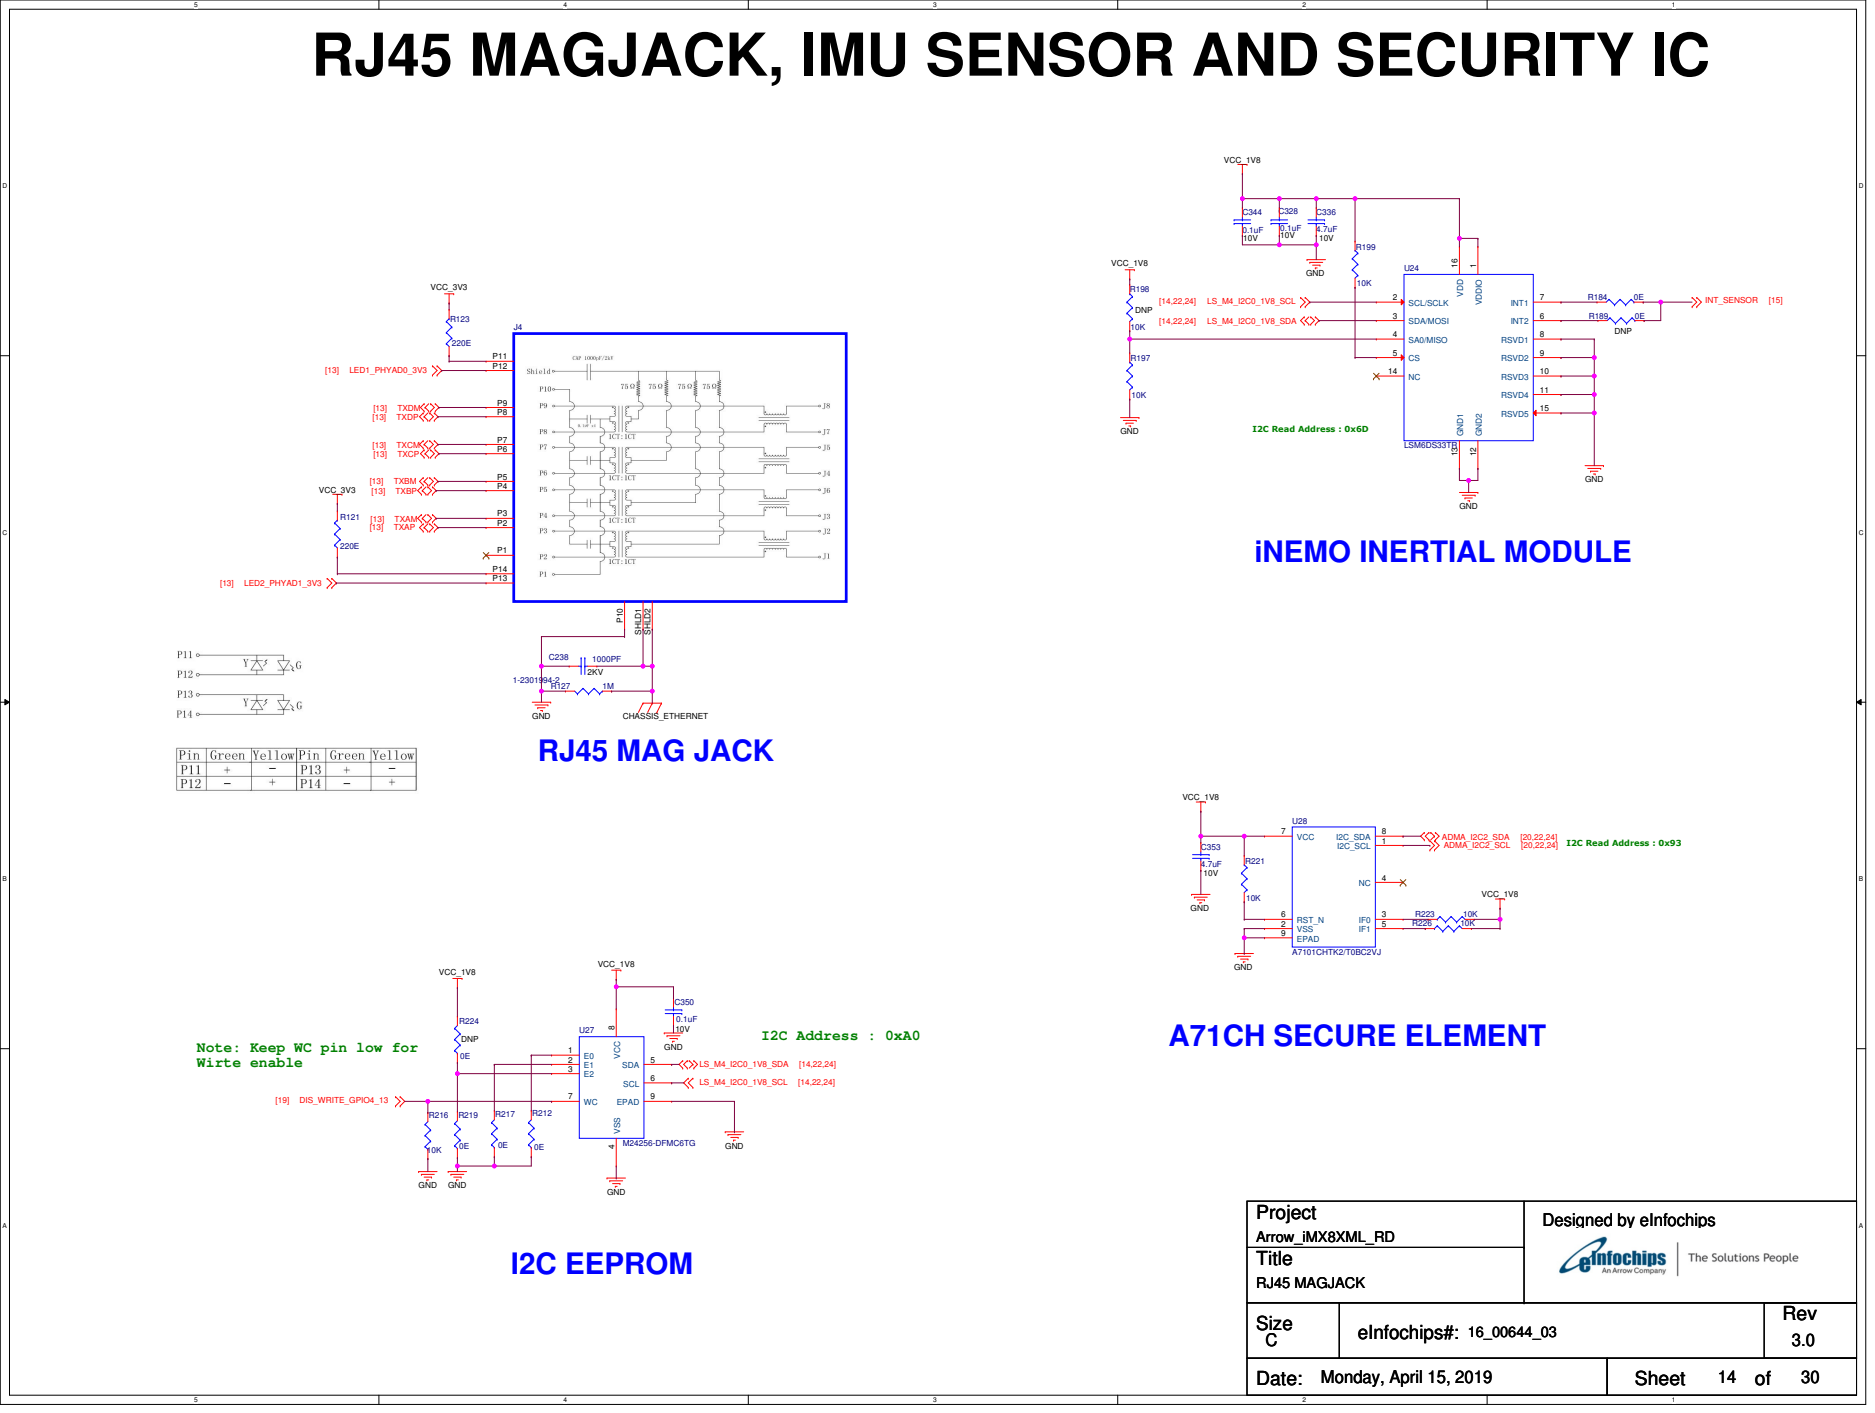
[picture p100: page 14]

Note: Keep WC pin low for
Wirte enable

# MICROPHONE INTERFACE

# MEMS I2S MICROPHONES

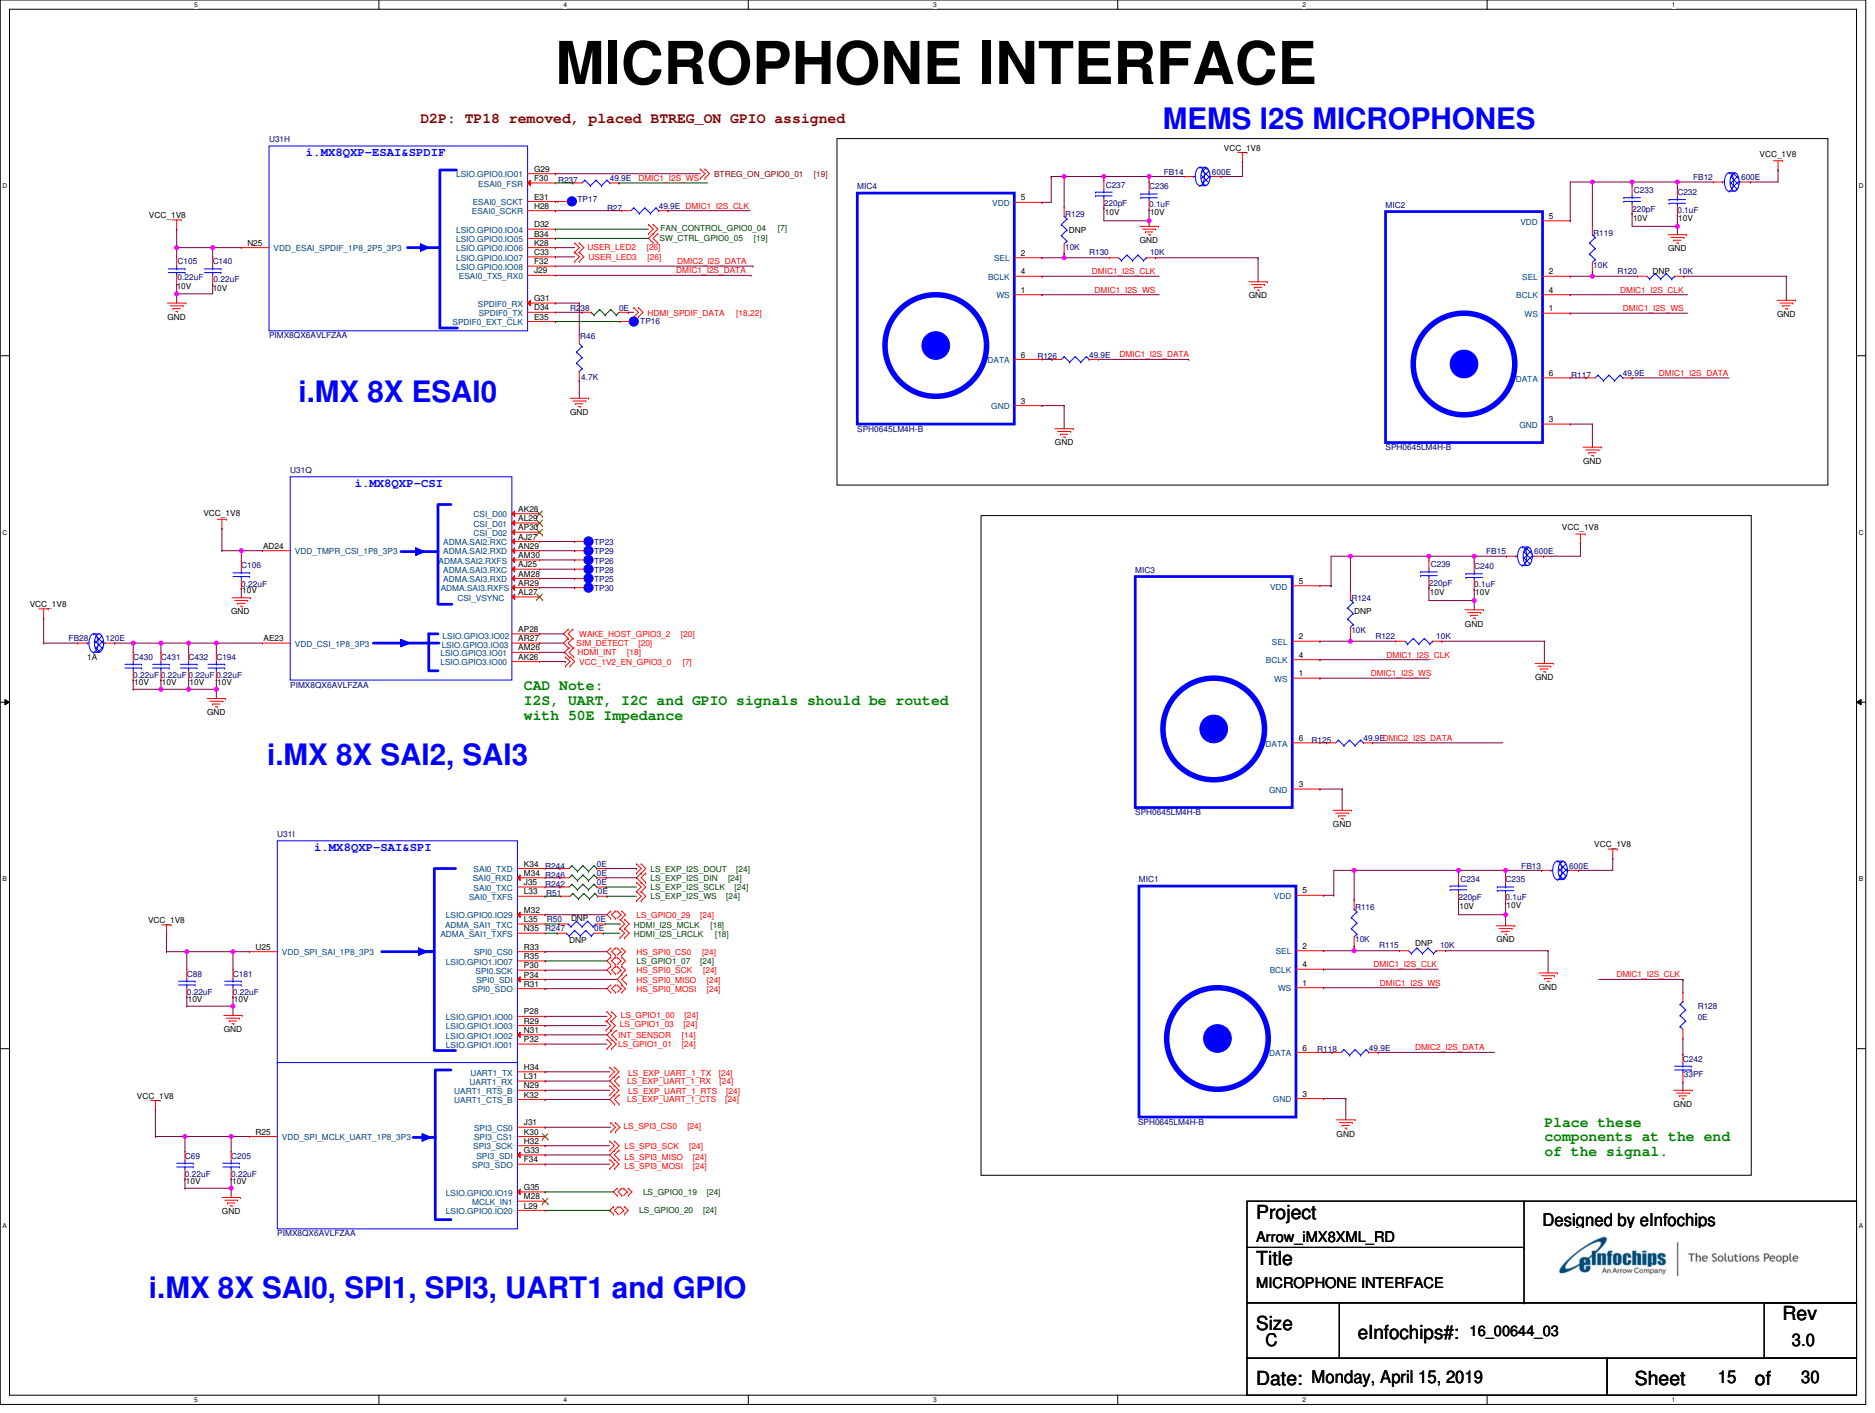
[picture p101: page 15]

D2P: TP18 removed, placed BTREG_ON GPIO assigned

CAD Note:
I2S, UART, I2C and GPIO signals should be routed
with 50E Impedance

Place these
components at the end
of the signal.

# USB CONTROLLERS

### i.MX8QXP-USB

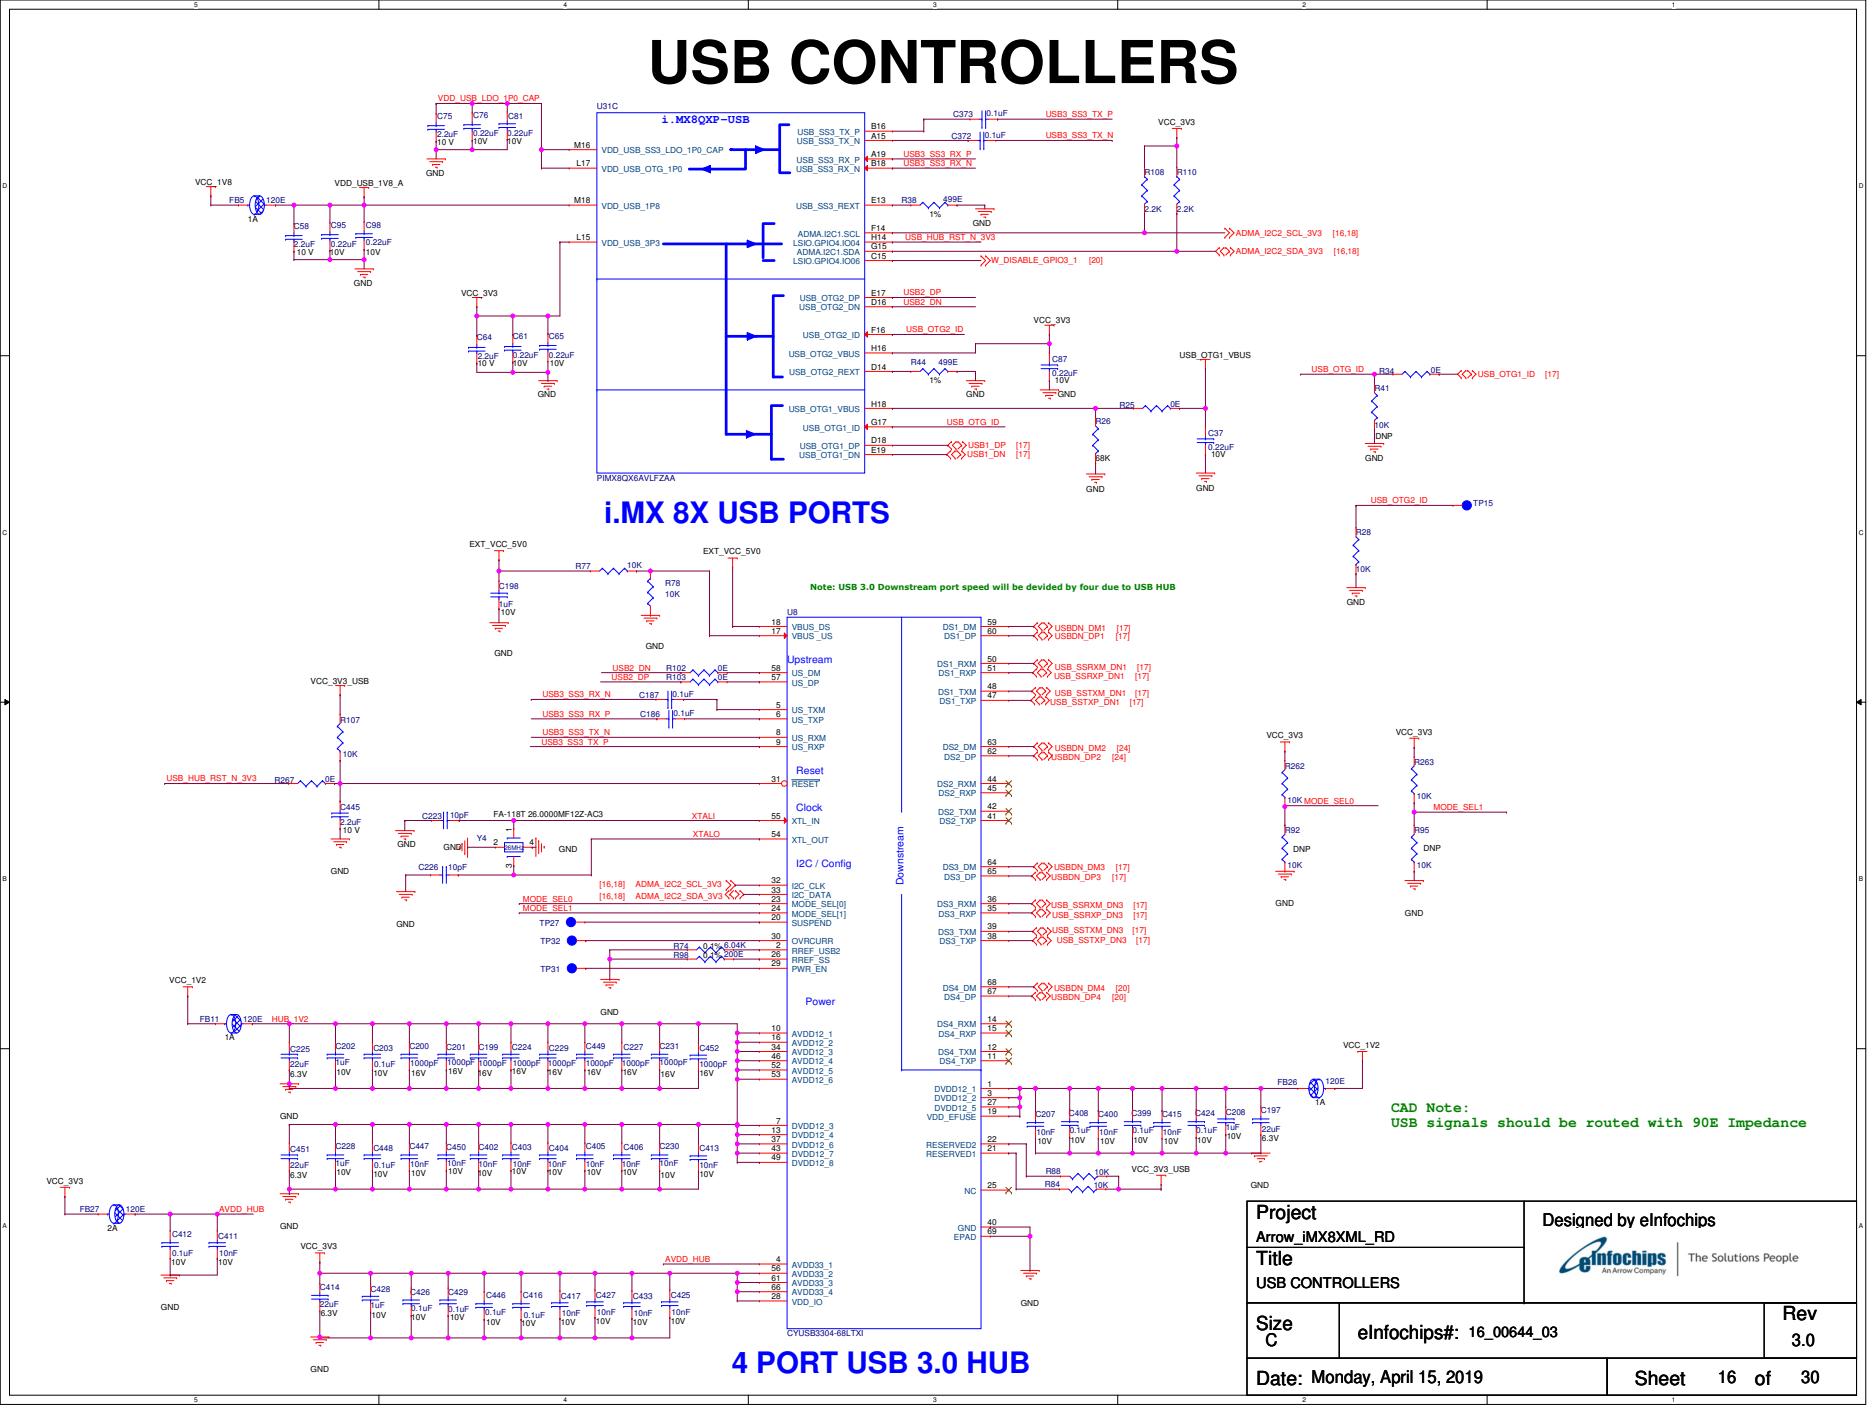
[picture p102: page 16]

Note: USB 3.0 Downstream port speed will be devided by four due to USB HUB

CAD Note:
USB signals should be routed with 90E Impedance

# USB CONNECTORS

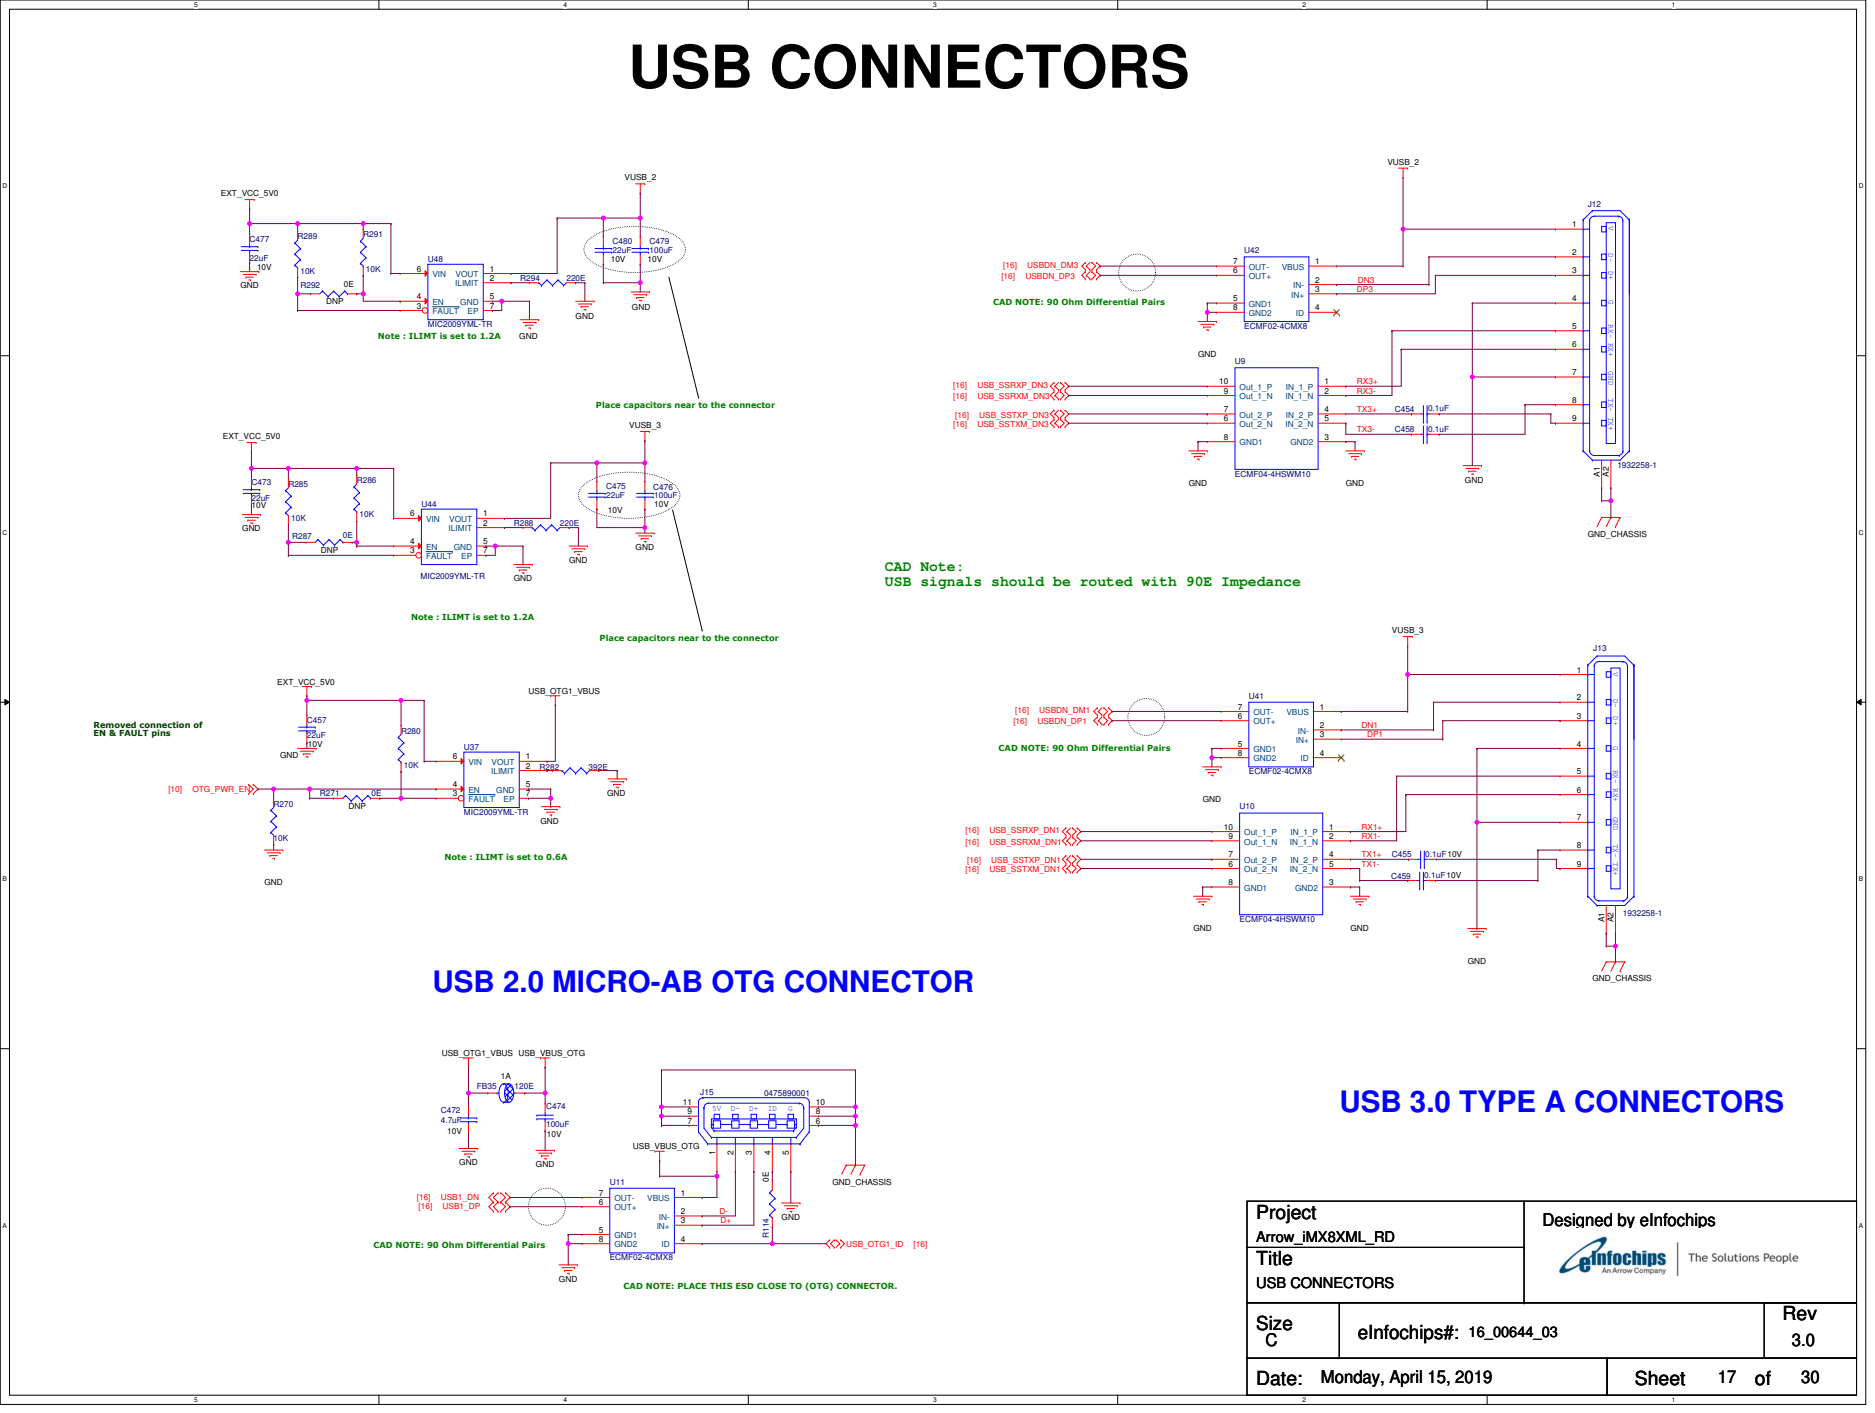
[picture p103: page 17]

V TX+ TX- GND RX+ RX- GD+D-

CAD NOTE: 90 Ohm Differential Pairs

Note : ILIMT is set to 1.2A

Place capacitors near to the connector

CAD Note:
USB signals should be routed with 90E Impedance

Note : ILIMT is set to 0.6A

USB 2.0 MICRO-AB OTG CONNECTOR

CAD NOTE: PLACE THIS ESD CLOSE TO (OTG) CONNECTOR.

# DSI TO HDMI CONVERSION

# DSI TO HDMI TRANSMITTER

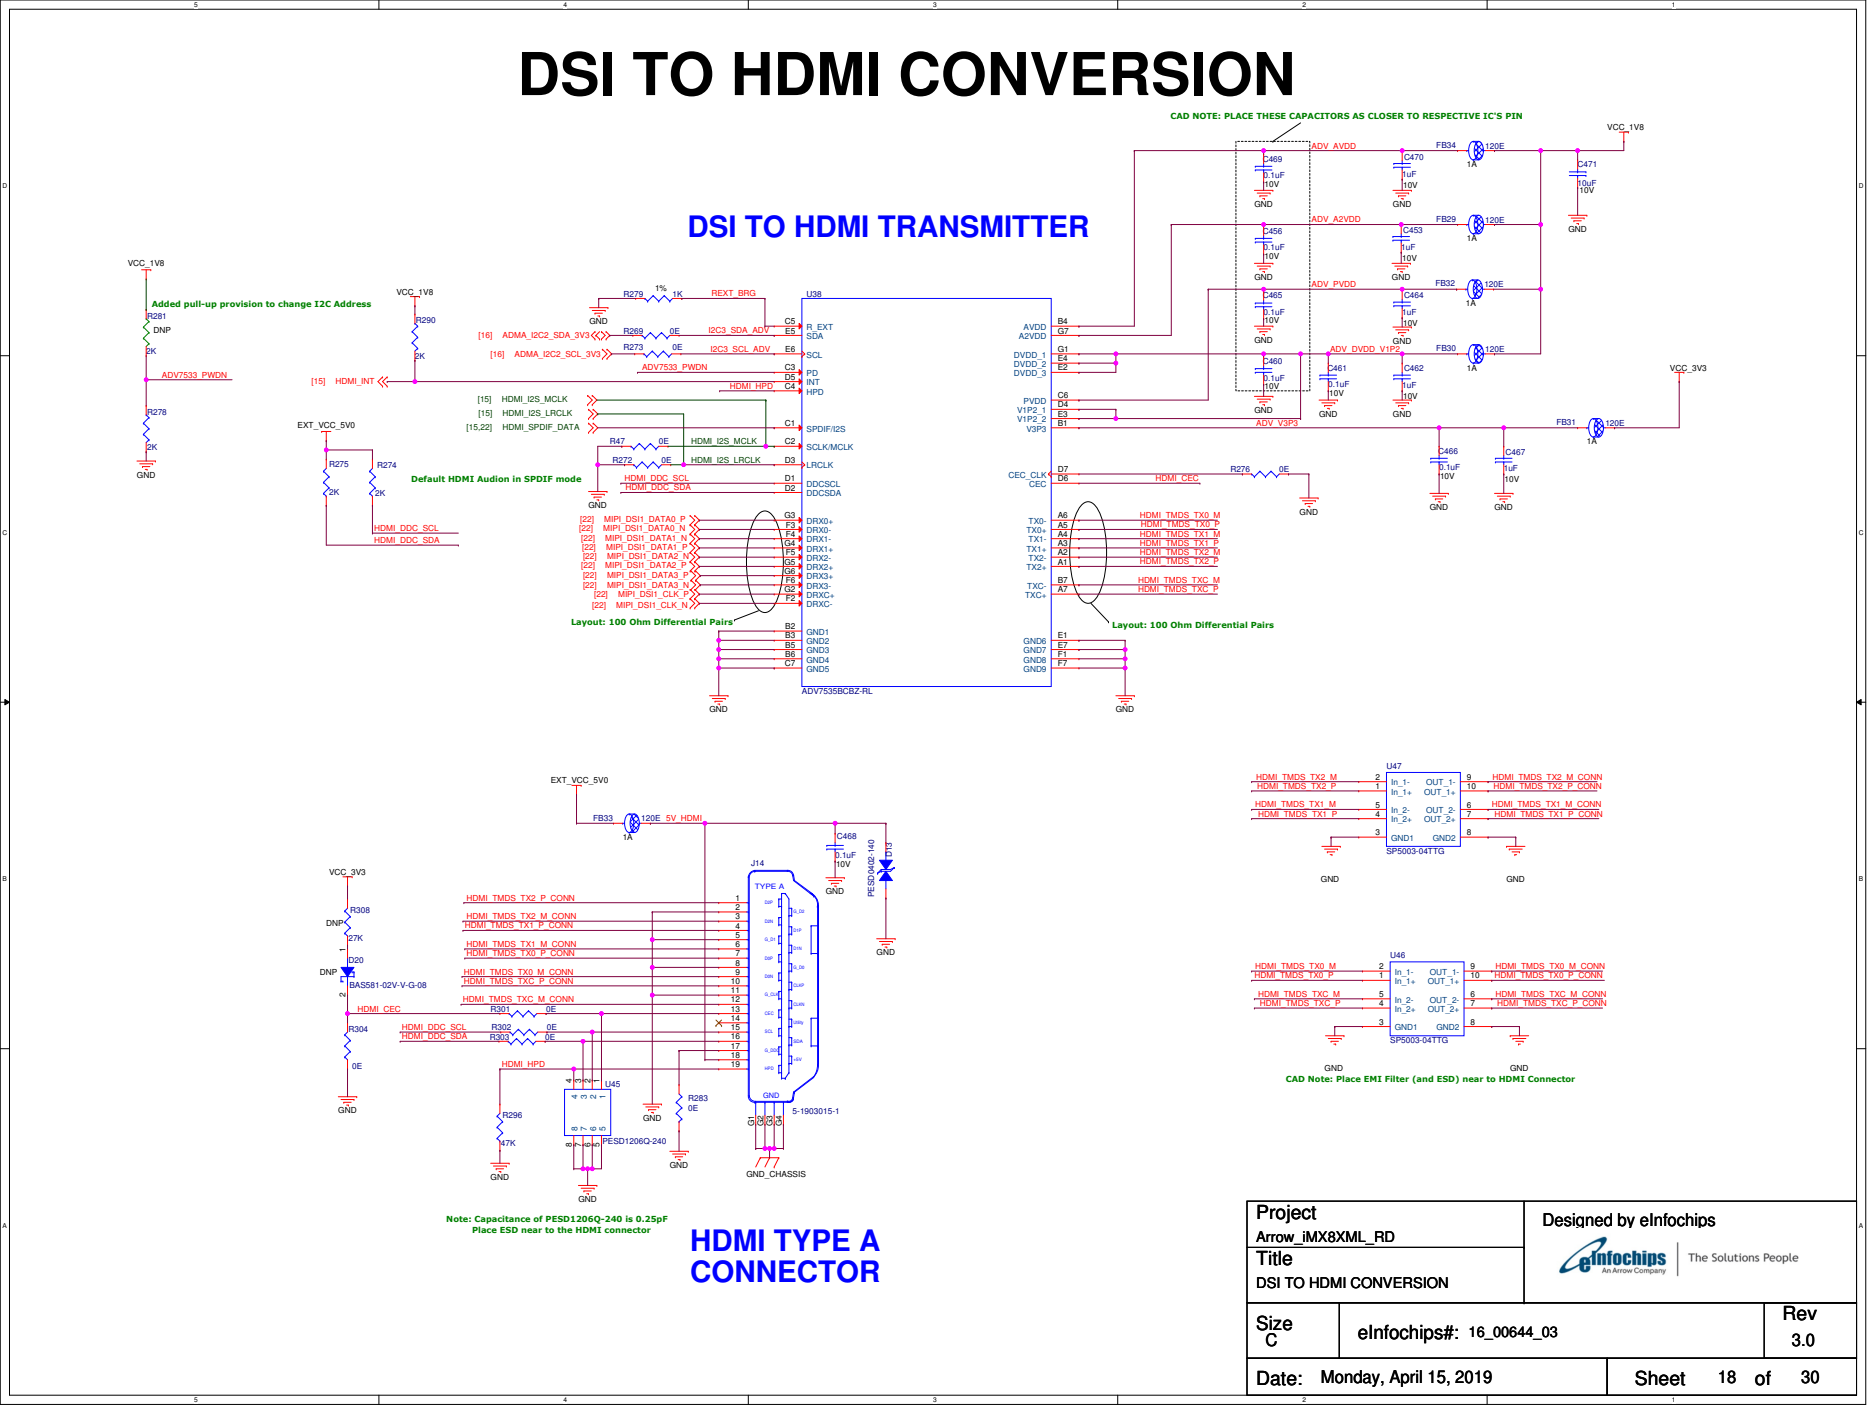
[picture p104: page 18]

CAD NOTE: PLACE THESE CAPACITORS AS CLOSER TO RESPECTIVE IC'S PIN

Added pull-up provision to change I2C Address
DNP

Default HDMI Audion in SPDIF mode

Layout: 100 Ohm Differential Pairs

CAD Note: Place EMI Filter (and ESD) near to HDMI Connector

Note: Capacitance of PESD1206Q-240 is 0.25pF

Place ESD near to the HDMI connector

# Wi-Fi BLUETOOTH INTERFACE

### Place Resistor near to Processor

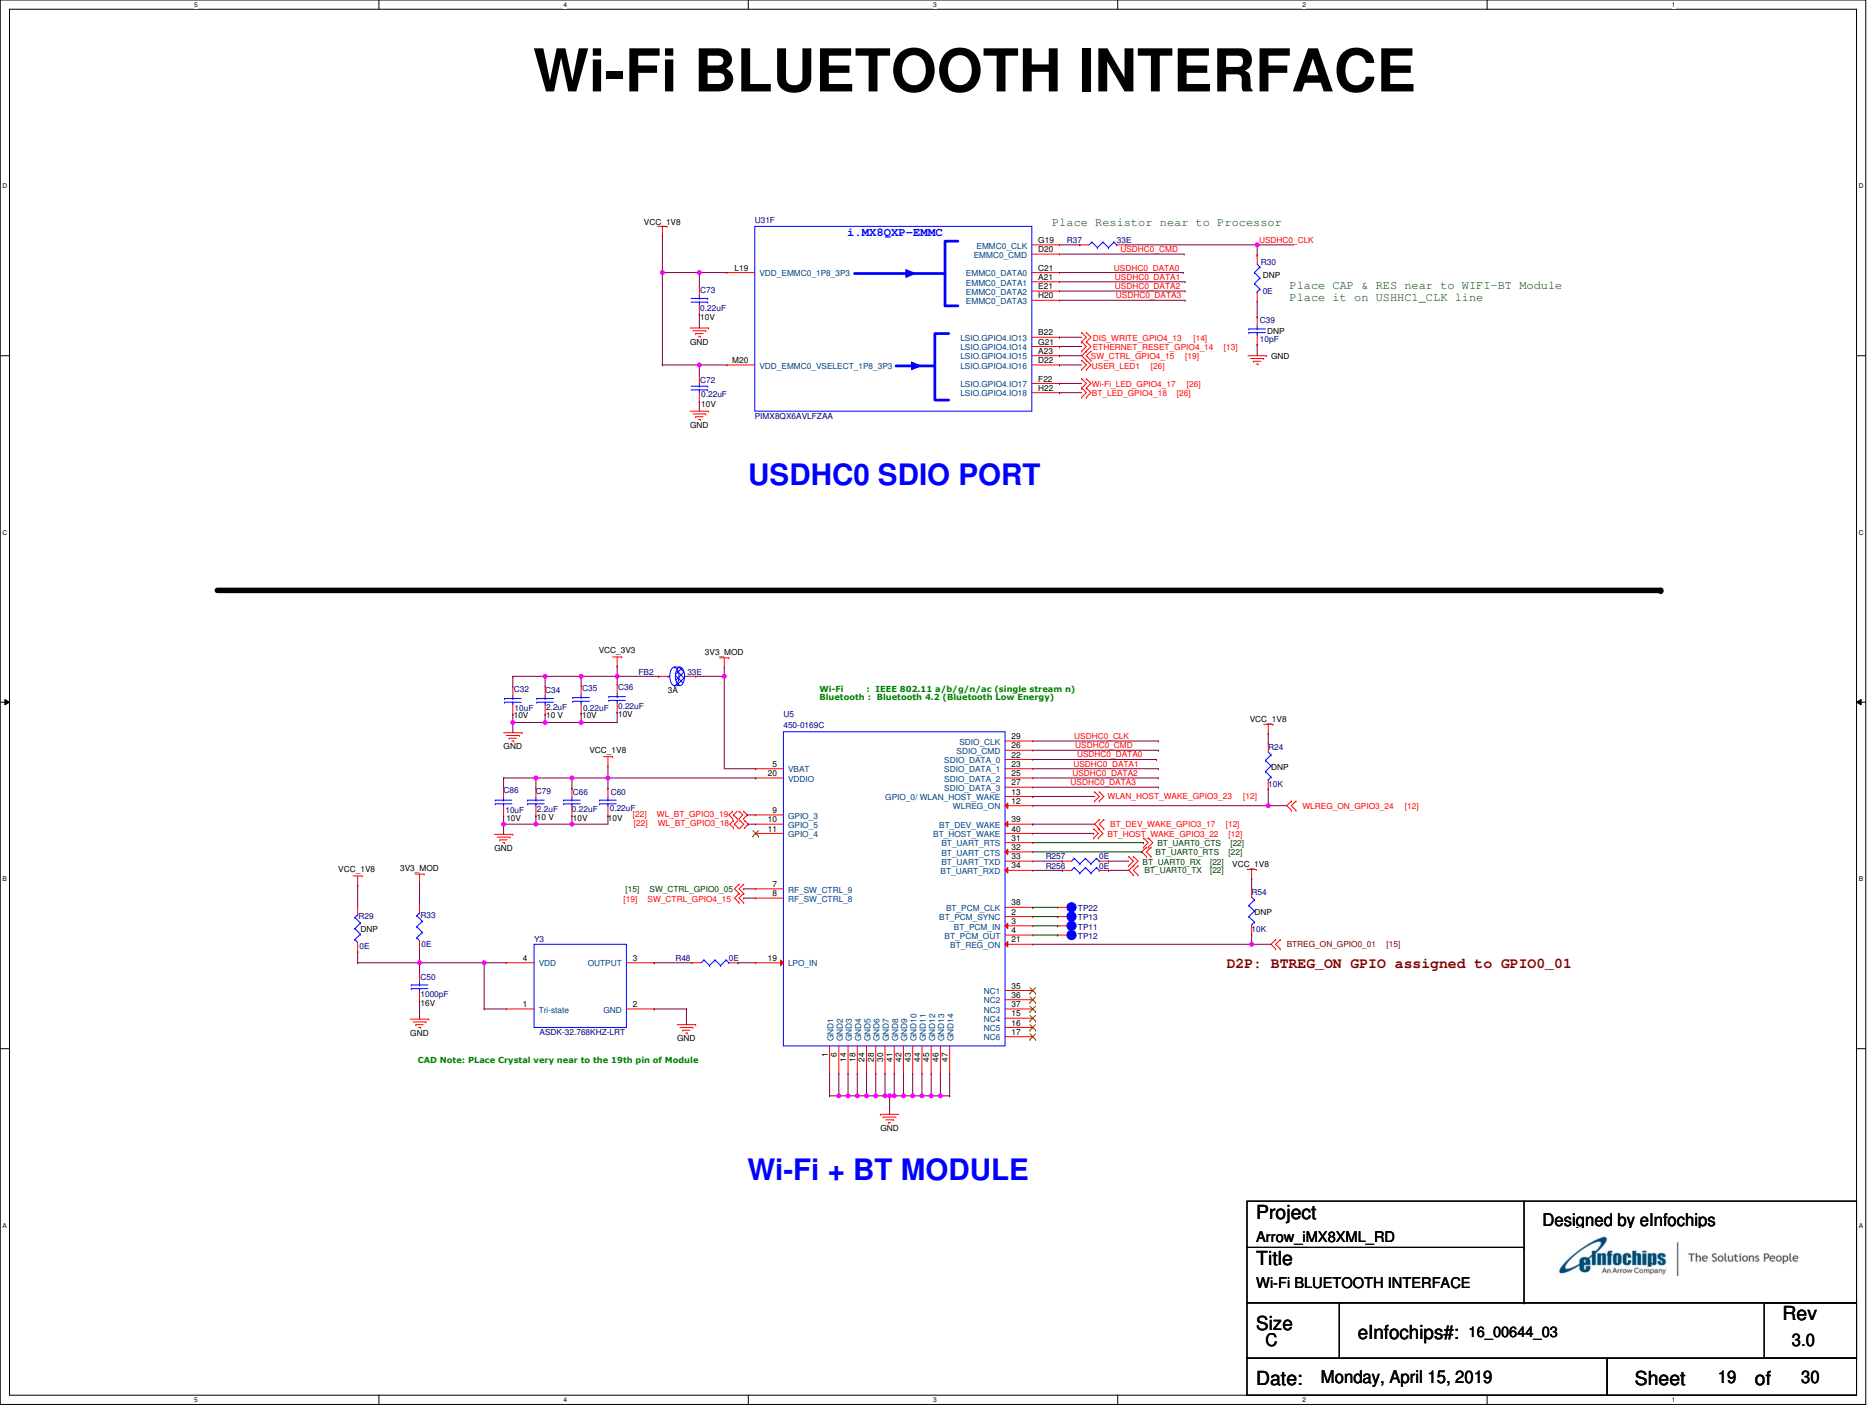
[picture p105: page 19]

DNP
Place CAP & RES near to WIFI-BT Module
Place it on USHHC1_CLK line

Bluetooth : Bluetooth 4.2 (Bluetooth Low Energy)

CAD Note: PLace Crystal very near to the 19th pin of Module

Wi-Fi + BT MODULE

# LTE MODULE INTERFACE

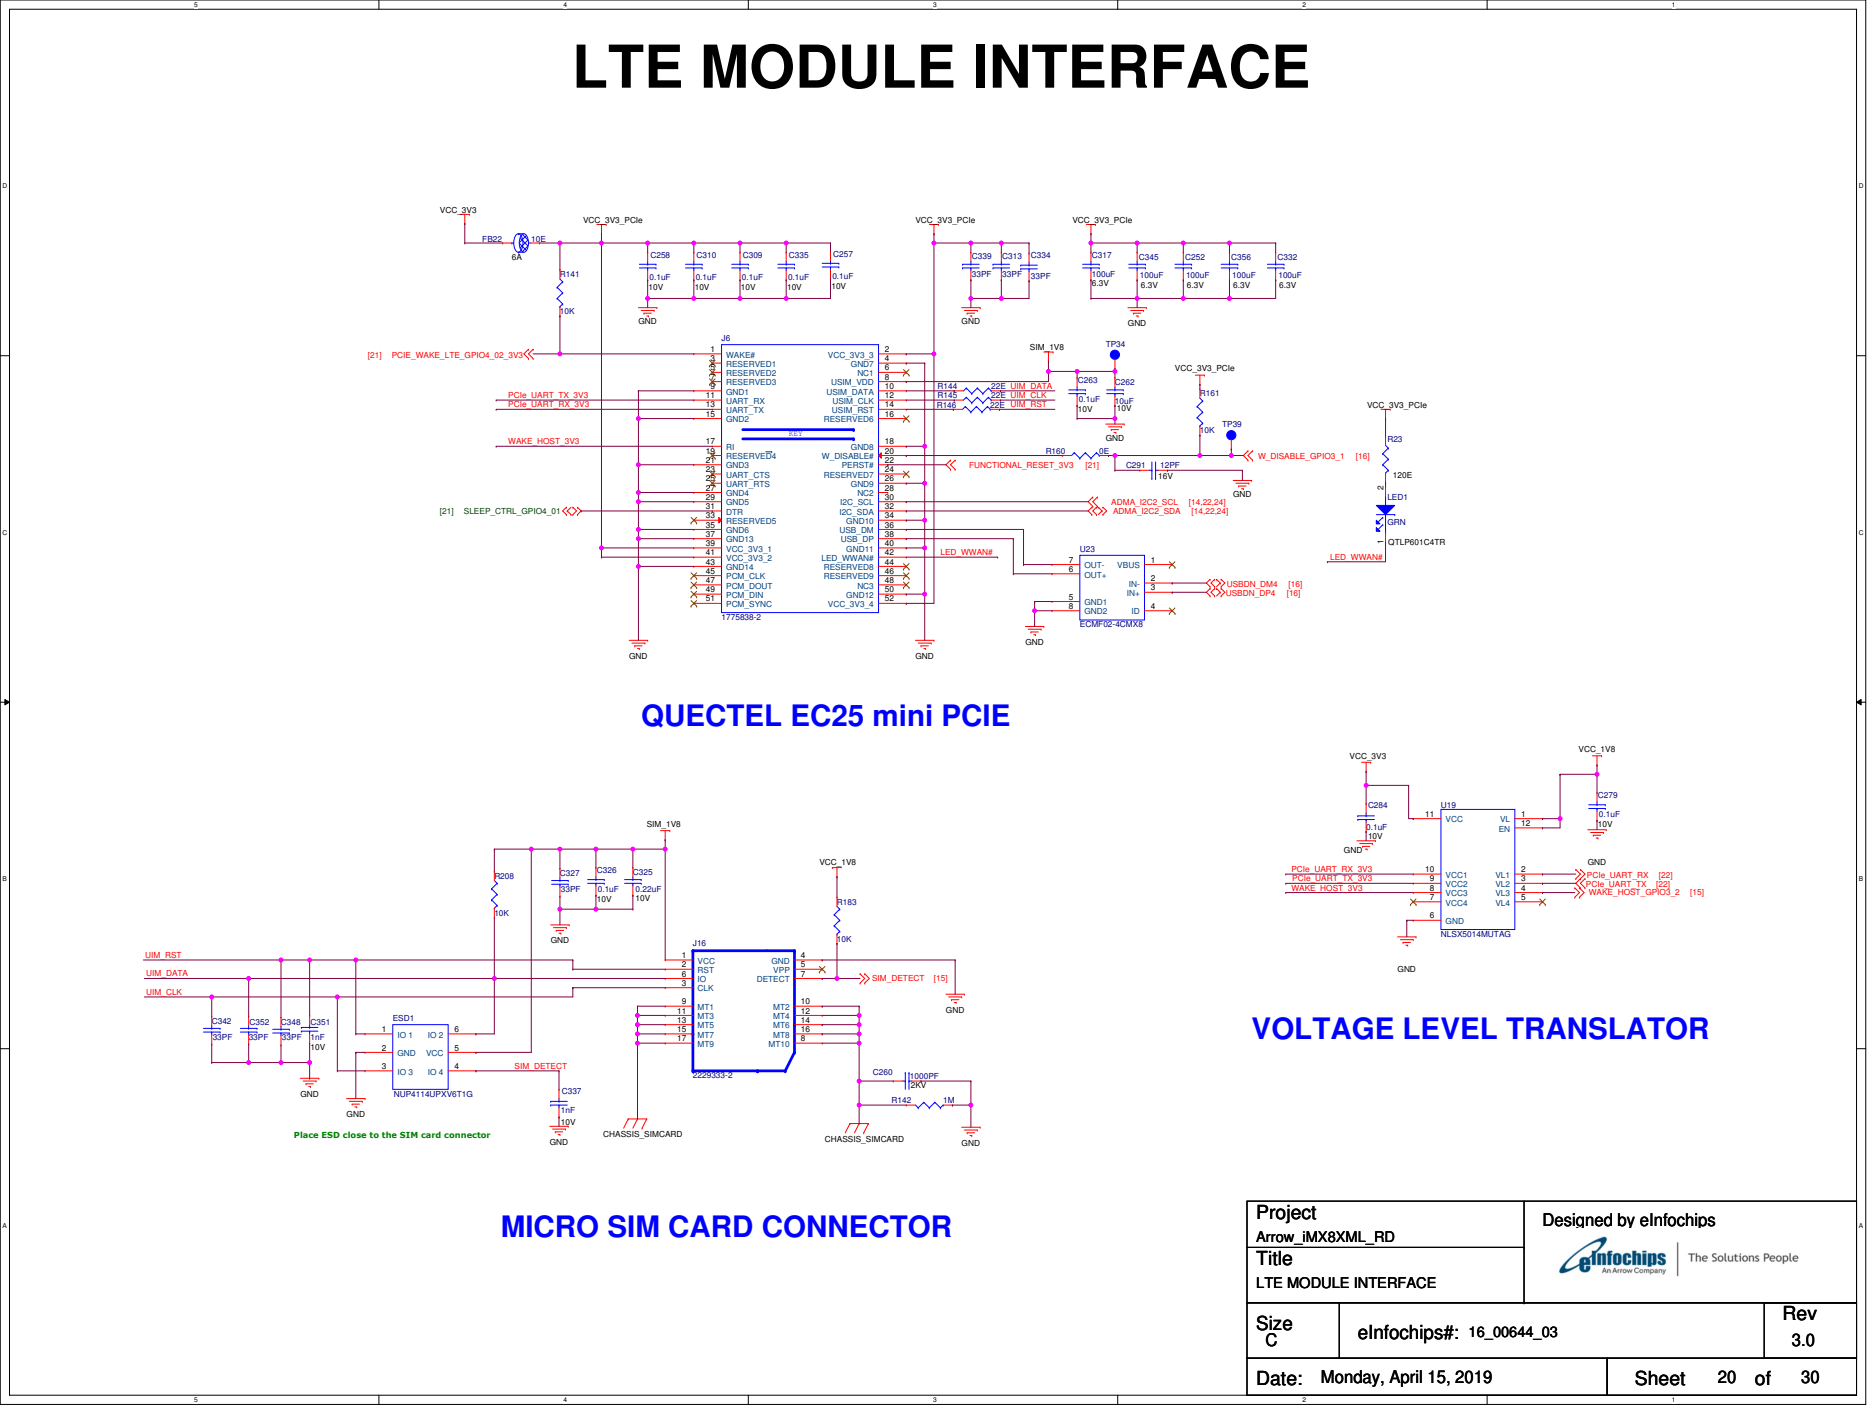
[picture p106: page 20]

Place ESD close to the SIM card connector

MICRO SIM CARD CONNECTOR

# i.MX 8X PCIe, MIPI CSI

### i.MX8QXP-PCIE

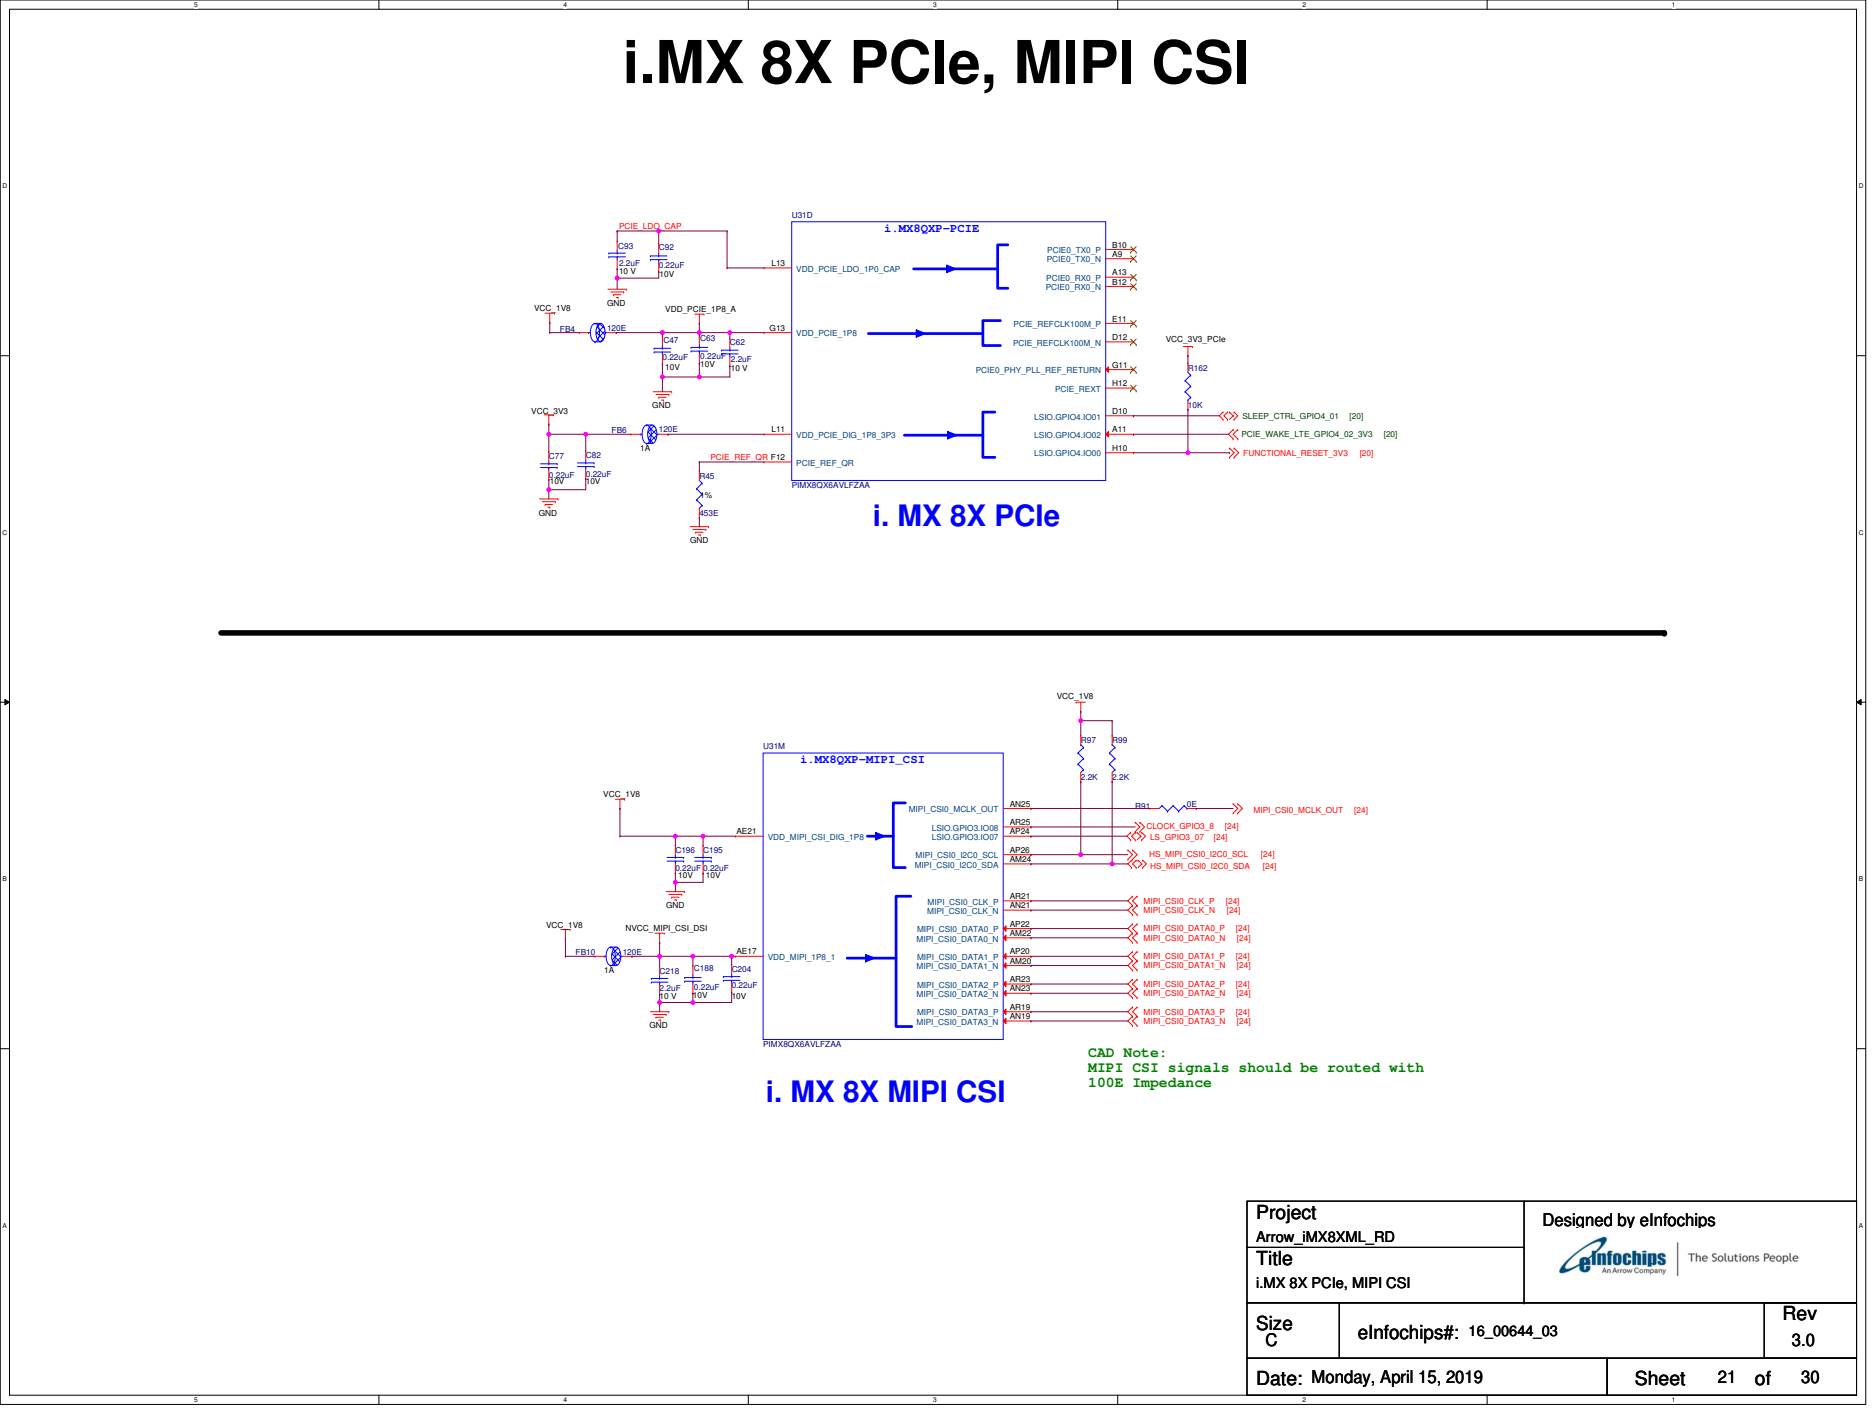
[picture p107: page 21]

CAD Note:
MIPI CSI signals should be routed with

100E Impedance i. MX 8X MIPI CSI

# i. MX 8X MIPI DSI, SAI, UART

### i.MX8QXP-DSI

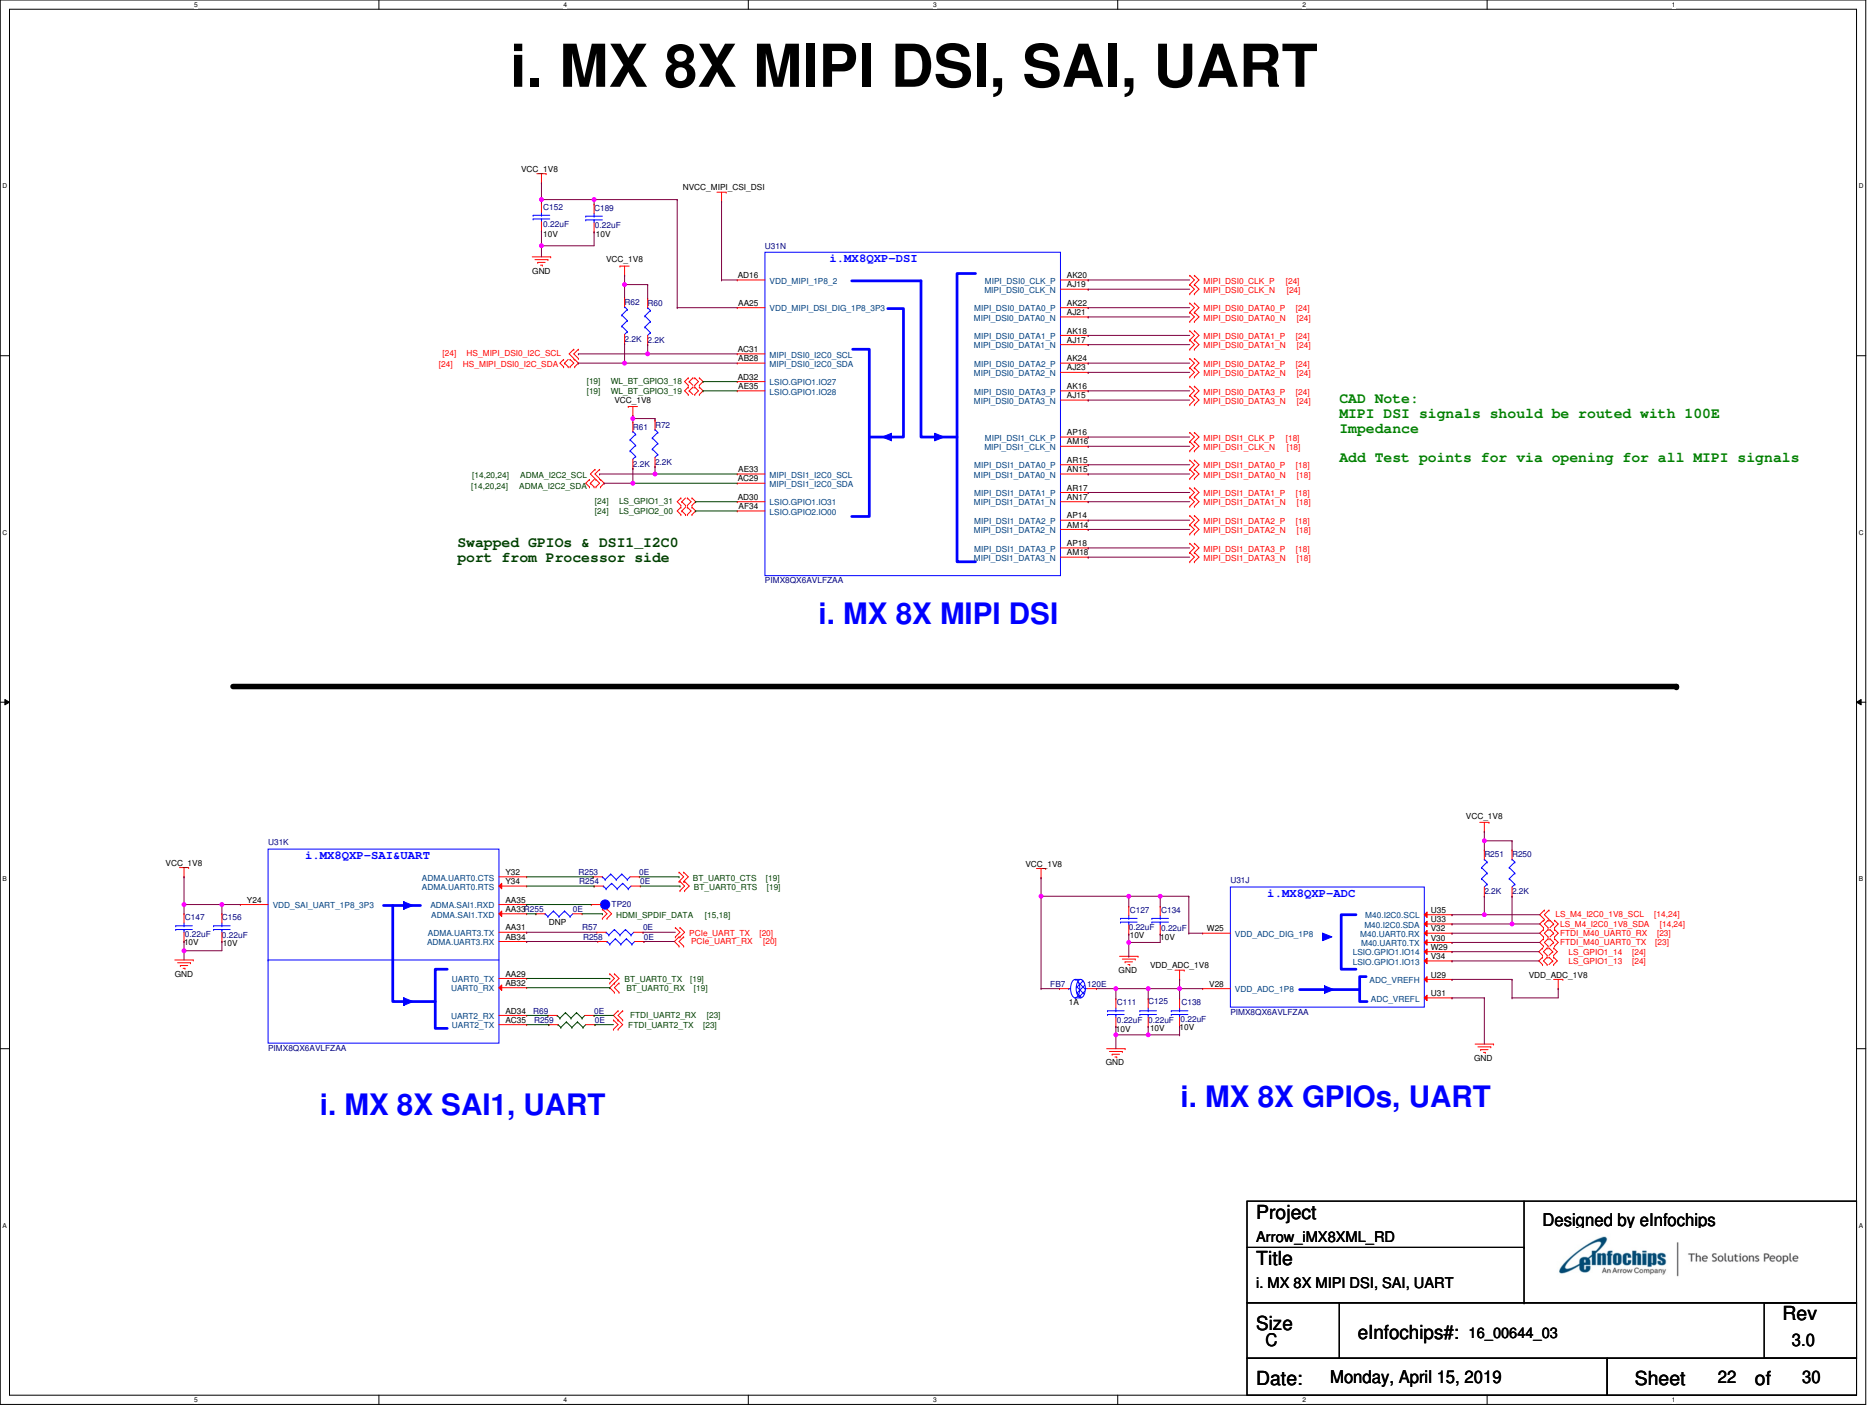
[picture p108: page 22]

CAD Note:
MIPI DSI signals should be routed with 100E
Impedance

Add Test points for via opening for all MIPI signals

Swapped GPIOs & DSI1_I2C0
port from Processor side

# DEBUG UART AND USB

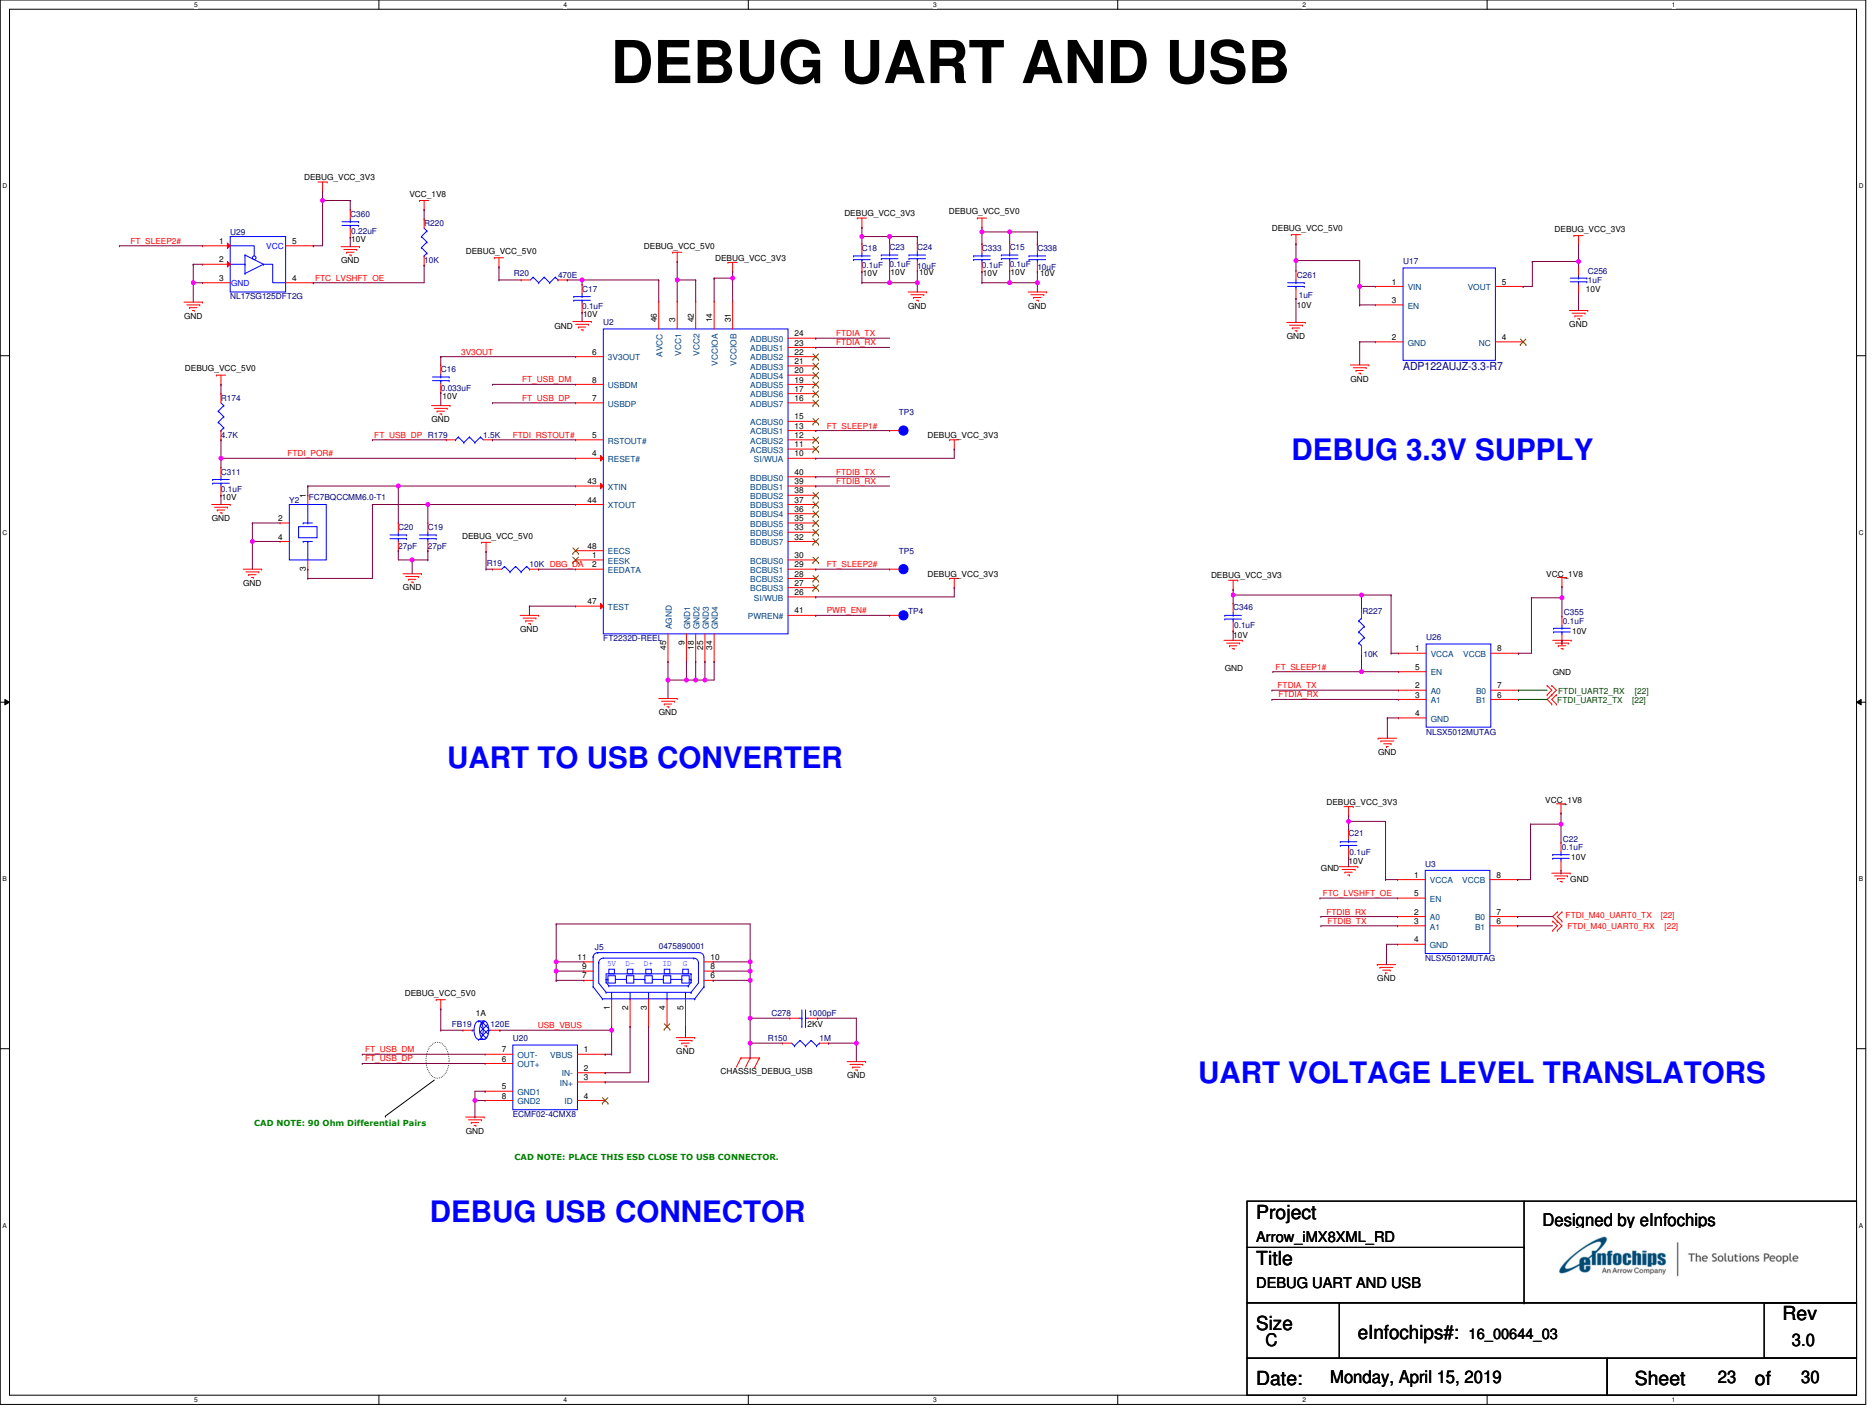
[picture p109: page 23]

UART TO USB CONVERTER

UART VOLTAGE LEVEL TRANSLATORS

CAD NOTE: 90 Ohm Differential Pairs

CAD NOTE: PLACE THIS ESD CLOSE TO USB CONNECTOR.
DEBUG USB CONNECTOR

# EXPANSION CONNECTORS

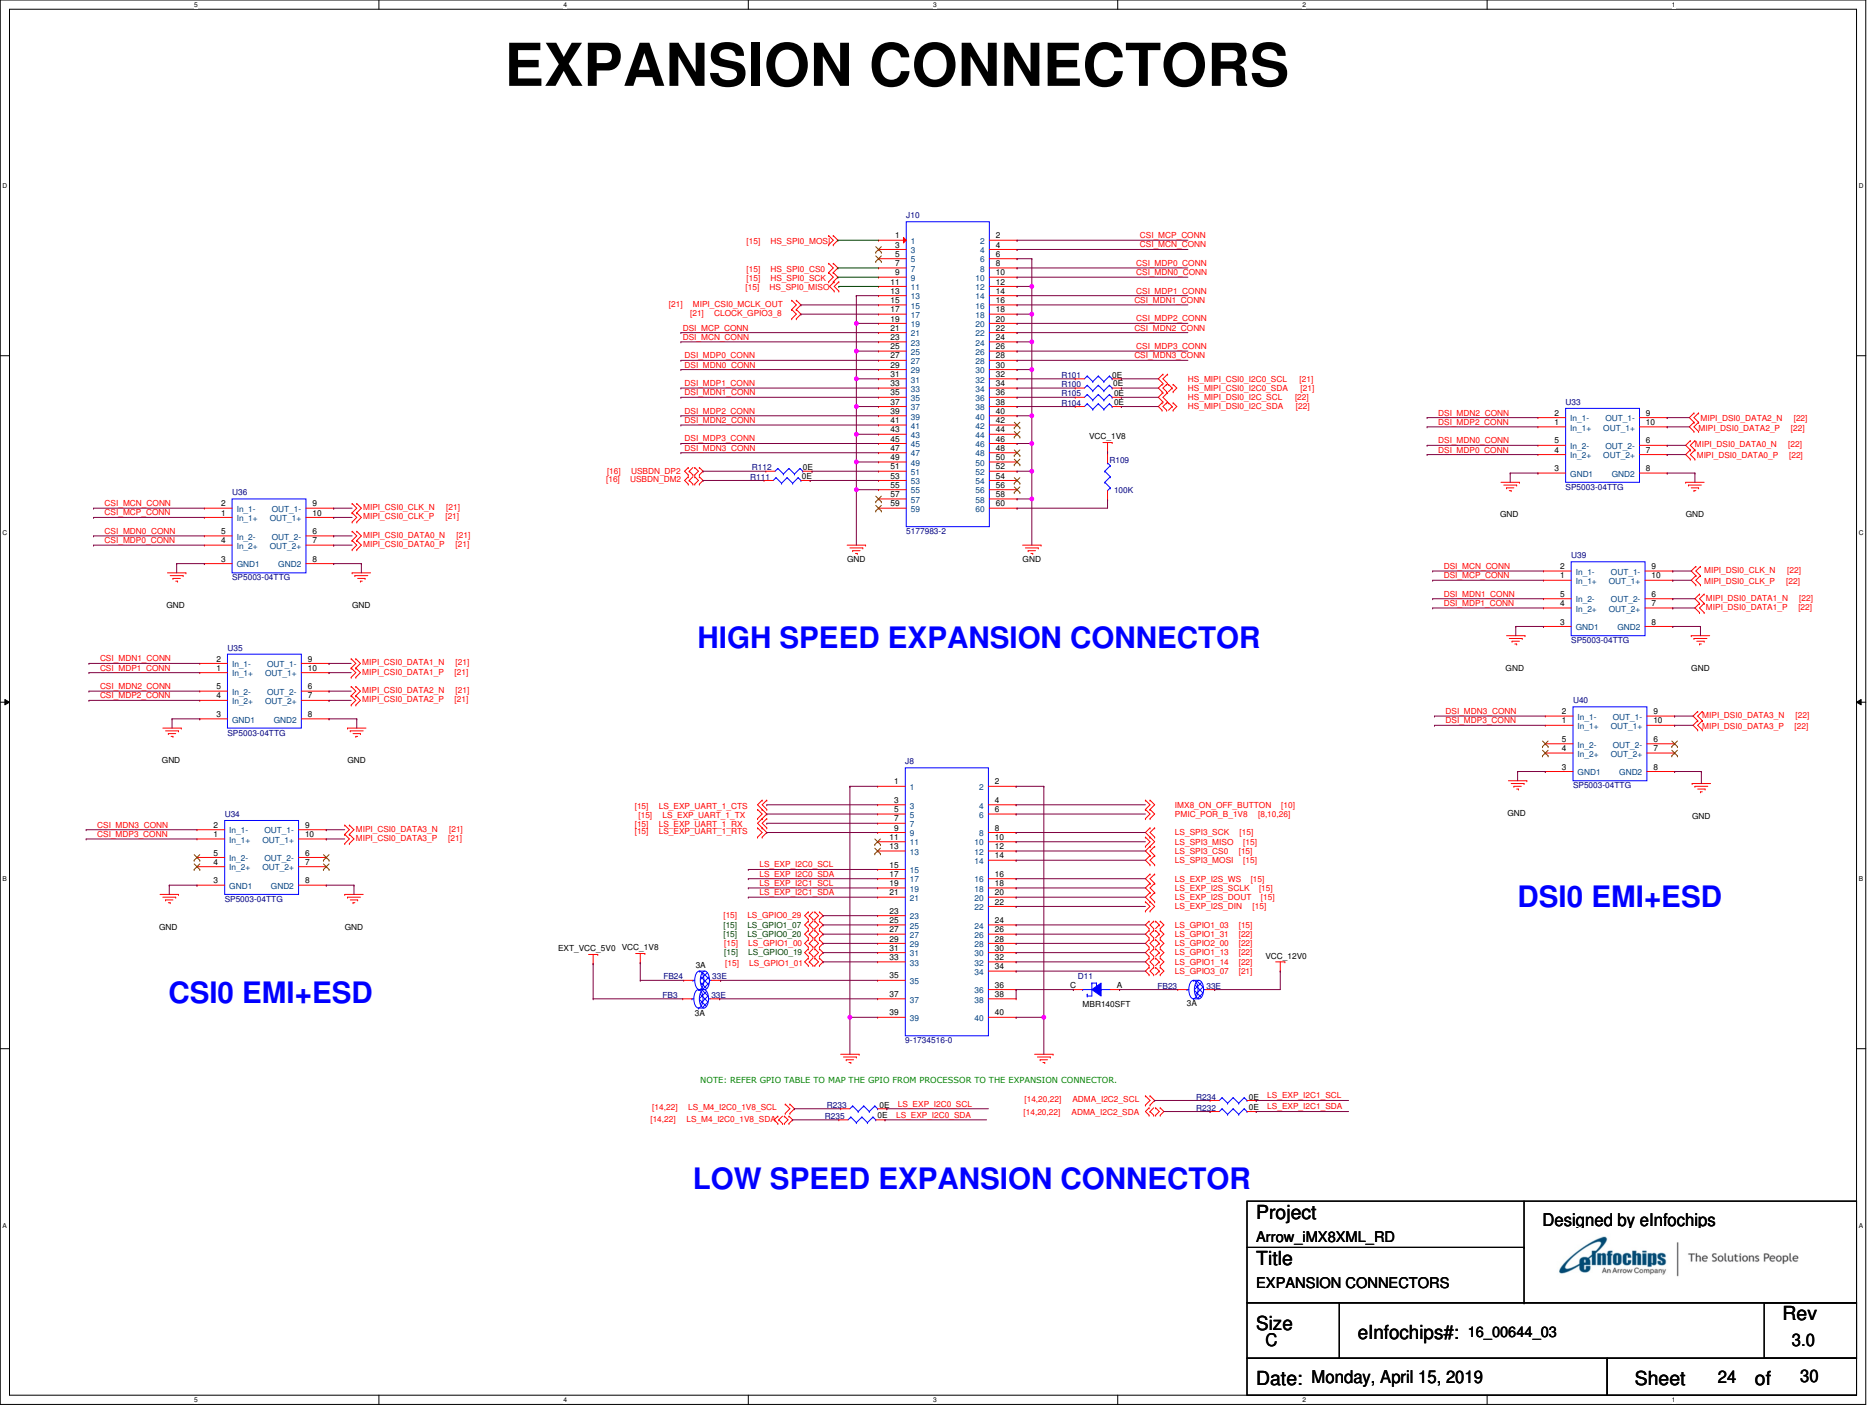
[picture p110: page 24]

HIGH SPEED EXPANSION CONNECTOR

NOTE: REFER GPIO TABLE TO MAP THE GPIO FROM PROCESSOR TO THE EXPANSION CONNECTOR.

LOW SPEED EXPANSION CONNECTOR

# MISCELLANEOUS

# MOUNTING HOLES

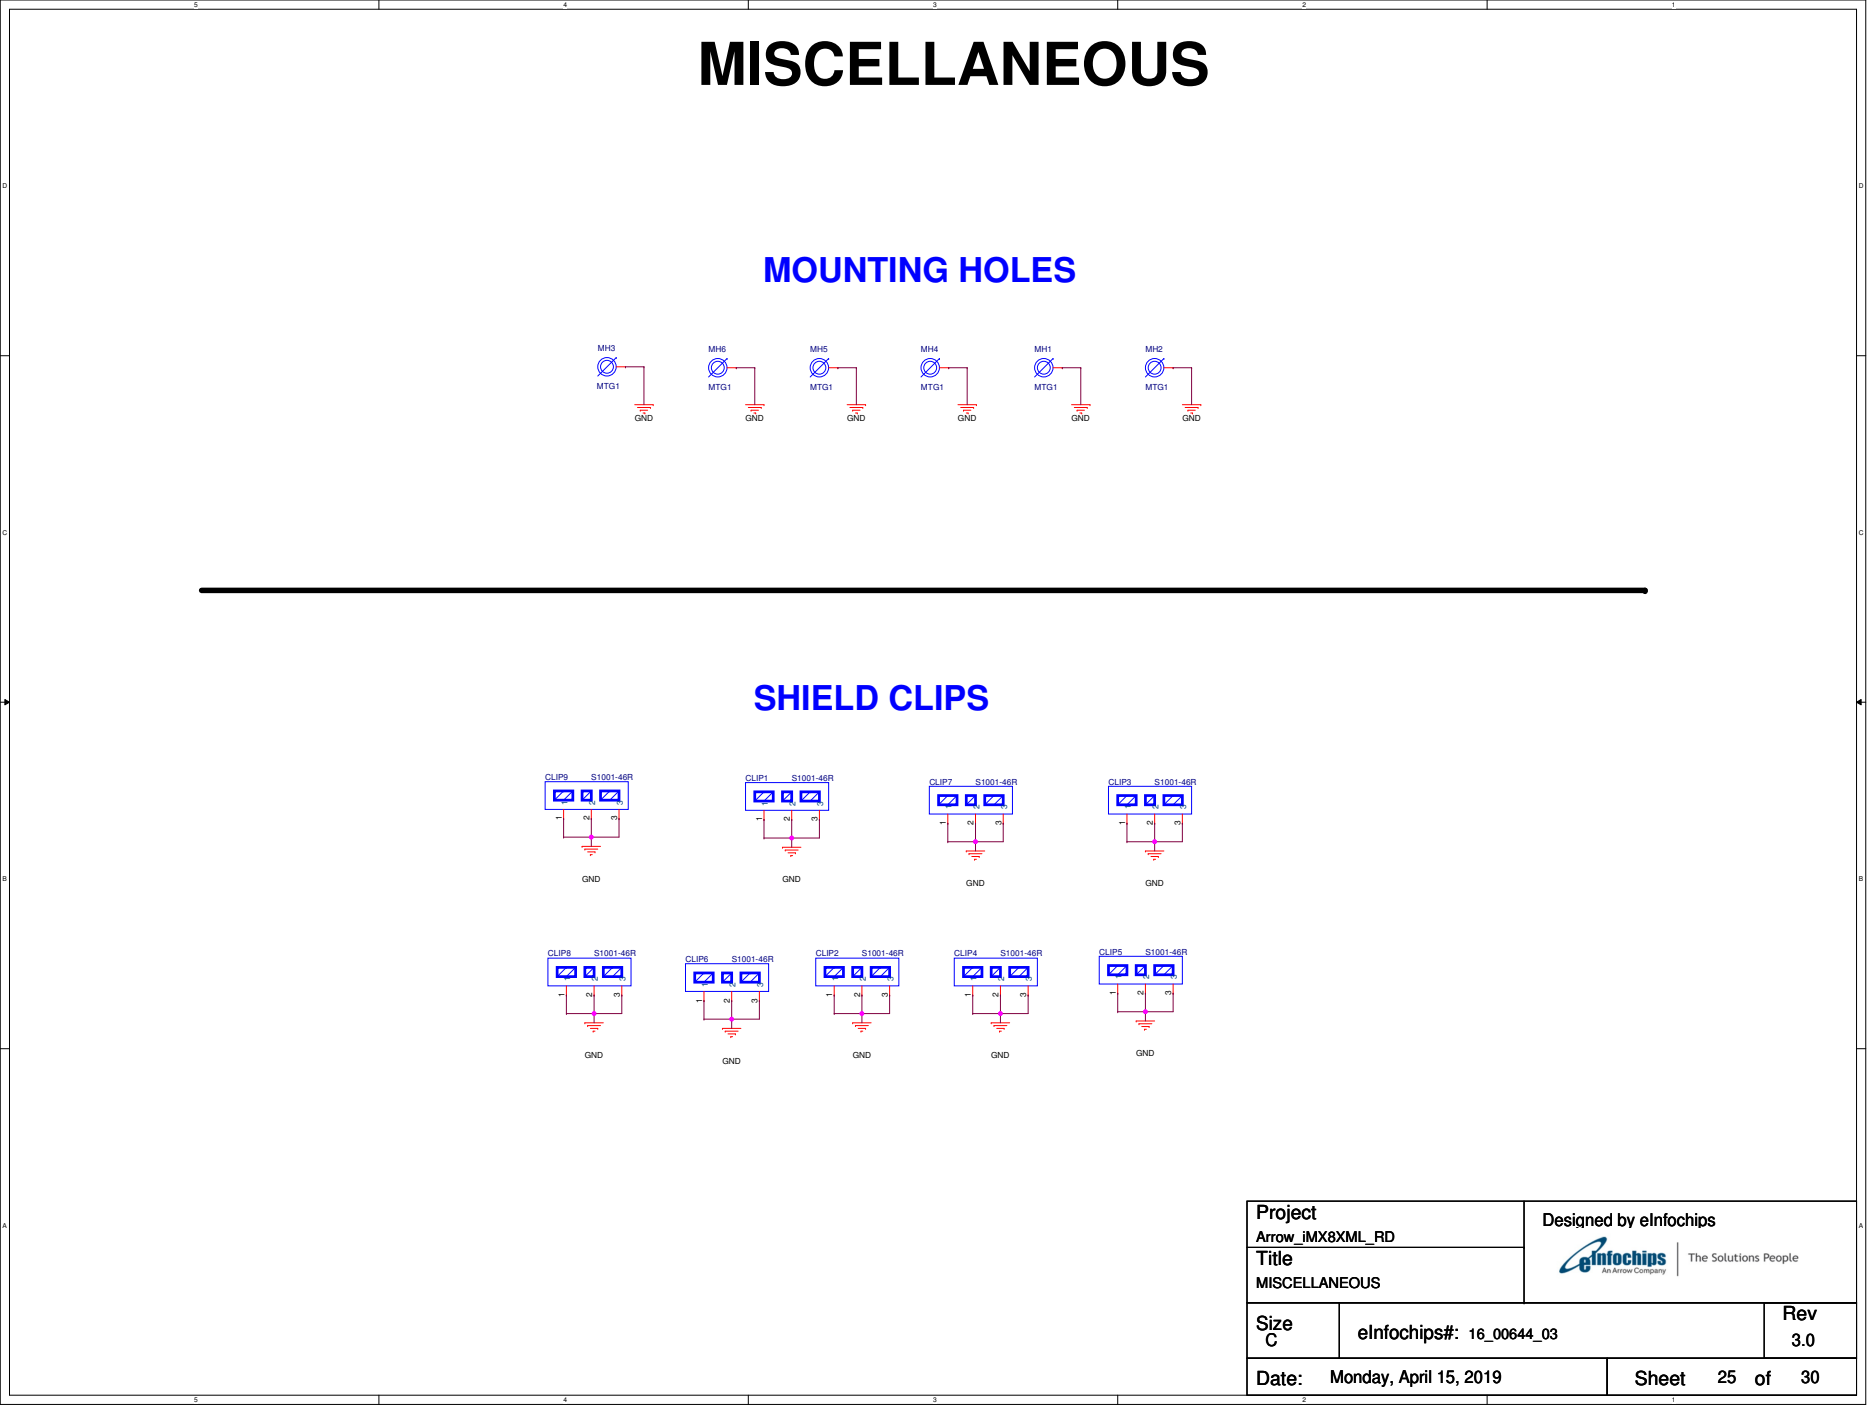
[picture p111: page 25]
SHIELD CLIPS; GND; GND GND; Title; Project; Monday, April 15, 2019; Arrow_iMX8XML_RD; MISCELLANEOUS; CLIP1; CLIP8; CLIP7; CLIP2; CLIP3; CLIP4; CLIP5; MTG1; CLIP6; CLIP9

Designed by eInfochips

# RESET SCHEME AND LEDs

# 4X GREEN LEDs

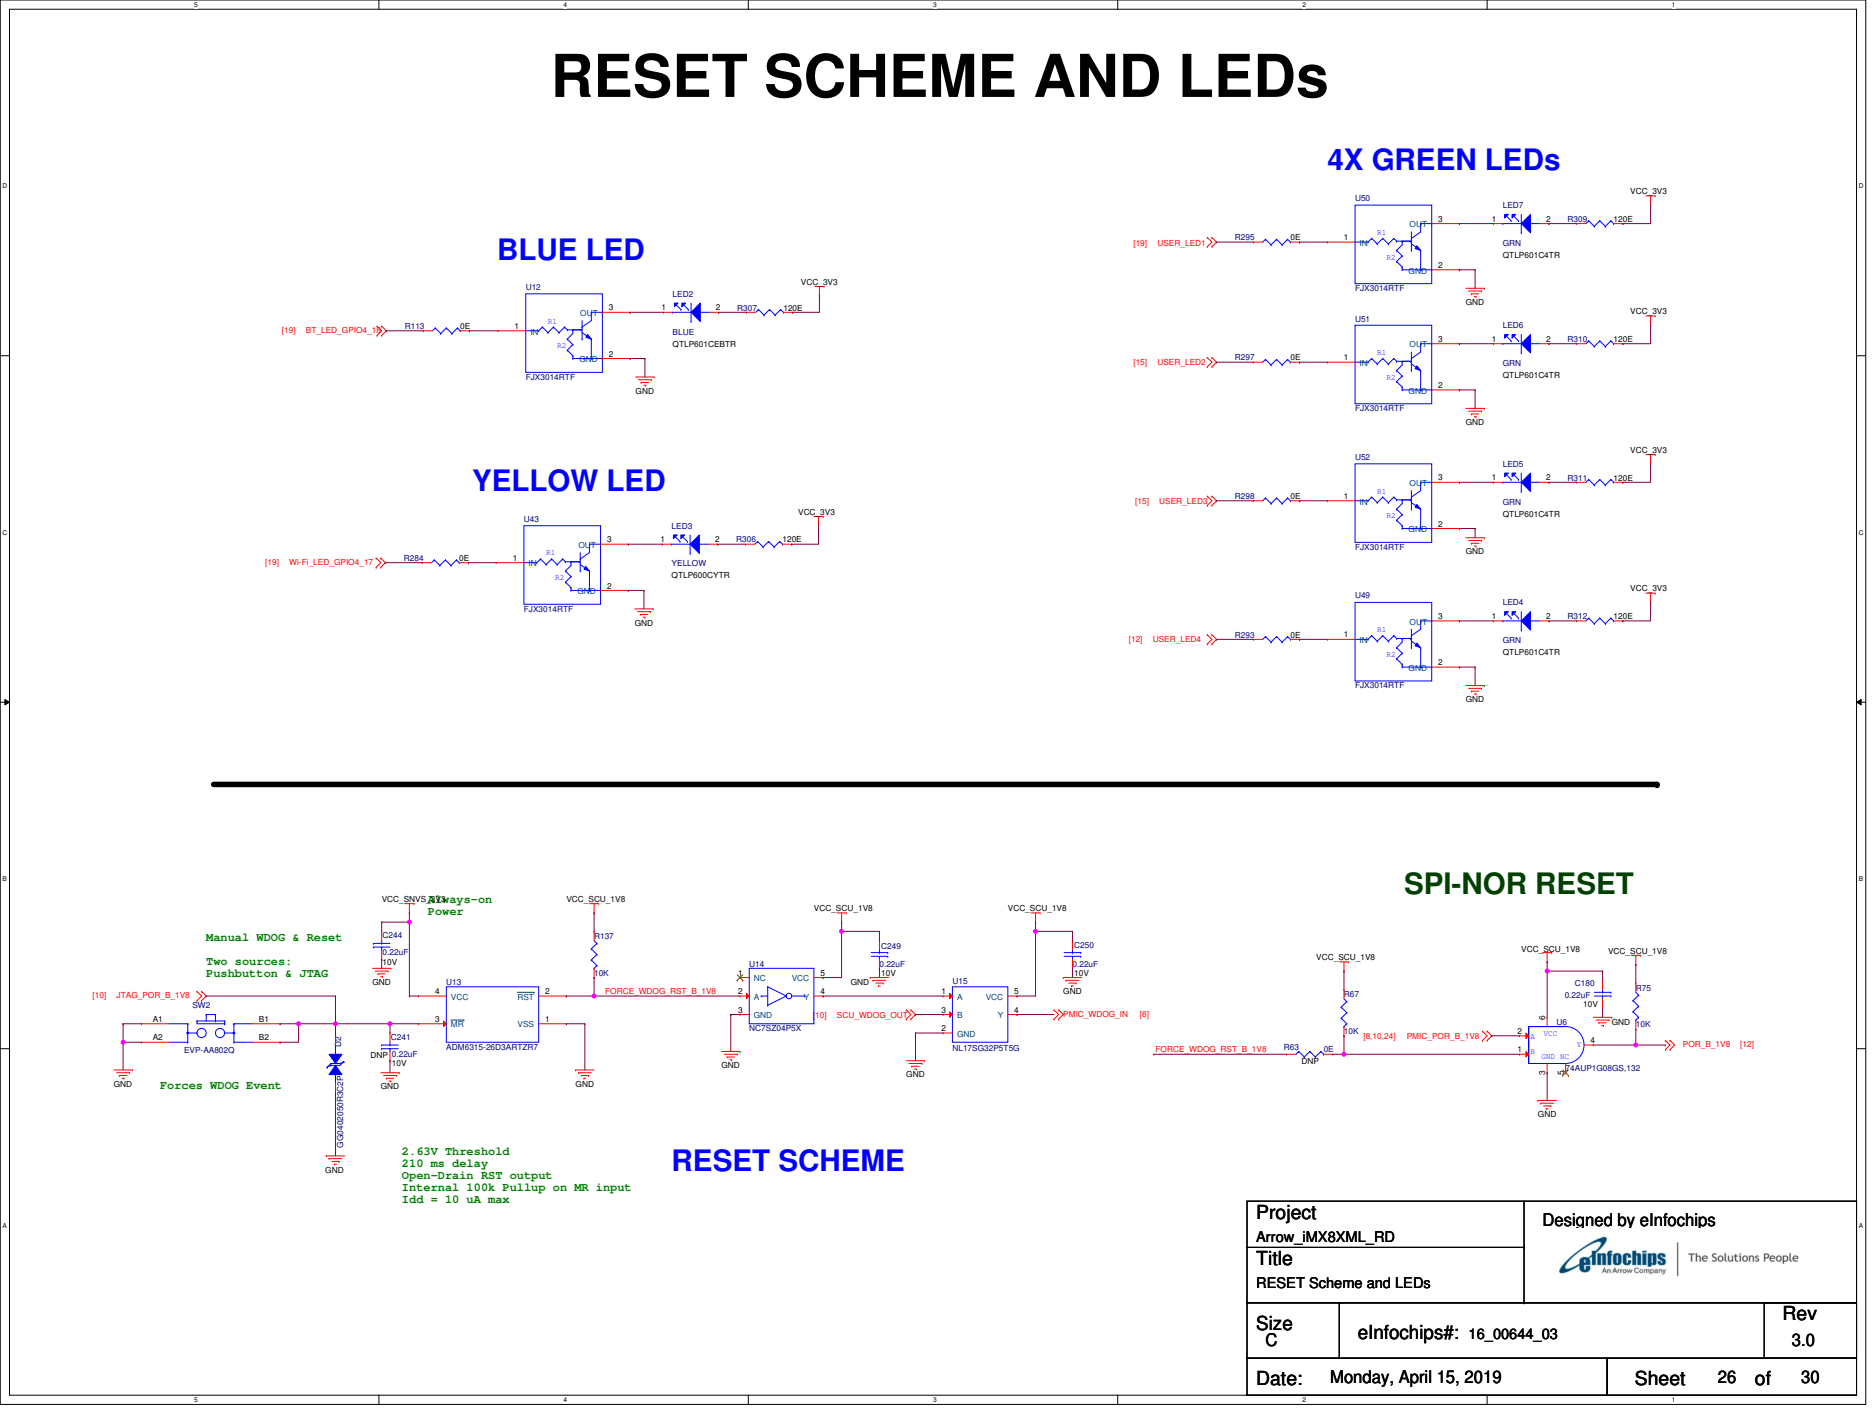
[picture p112: page 26]

2.63V Threshold
210 ms delay
Open-Drain RST output
Internal 100k Pullup on MR input
Idd = 10 uA max

D | D
C | C
B | B
A | A
PCB REV | SCH REV | CHANGE DESCRIPTION | DATE | AUTHOR
| 0.1 | Initial draft version created for internal review | 19/07/2018 | eInfochips

# RIVISION HISTORY 1

0.2 | DRC error generated and corrected | 01/08/2018 | eInfochips
| Net name duplication removed TVS diode added at Swtich-3 for protection Series termination provision added on clock signals Pull up provision removed for SD card signals 2.2K pull up replaced for all I2C going to expansion connector Voltage input changed to 1.8V for Ethernet section of processor Pull up provision removed for SD card signals Block diagram replaced with version 0.7 PMIC replaced with tow LTM4643 devices ADM1266 power sequencer and monitor added Power supply rail name changed at entire design as per new power scheme USB 3.0 HUB replaced with Cypress part CYUSB3304-68LTXI SPI is replaced with I2C for USB HUB and I2C table updated accordingly GPIO4_0 used for communication between processor and ADM1266 Arrow Approved Power Scheme added DSI to HDMI chip is replaced with LVDS to HDMI chip so that blind burried vias will not be required in layout Processor symbol updated with LVDS instead of DSI port Review comment number 80 to 128 of Design review tracker implemented Reverse protection diode for 12V mezzanine supply added 27MHz crystal added for LVDS to HDMI converter Level translator added for communication between processor and ADM1266
0.3 | 03/08/2018 R7696 pull down added at HPD pin of HDMI | eInfochips
| USB_OTG2_ID pin grounded as per unused pin recommendation from processor Hardware guideline

# As per Linaro comment, ADM_I2C pull up supply changed to AVDD_CAP instead of VCC_SCU_1V8 Pull up supply for U240 and U241 changed to AVDD_CAP

PMIC_POR_B_3V3 added at U241 and ON_OFF_SWITCH_3V3 provided to directly at the gate of U238

# C7875 is made DNP and will be mounted if any issue in programming of ADM1266

# As per ADI comment, C1792 value changed to 2.2pF instead of 2.2nF

# R7698 and R7699 added at processor side ADM_I2C

# As per ADI comment, C7931 updated to 10uF and C7988 0.1uF added As per ADI comment, R7630 and R7634 swapped As per ADI comment, 100pF capacitors added between output and FB pin of LTM4643 As per ADI comment, Supply rail use case note added

# Pull up provision and series resistor at enable pin location shifted near switcher

# Test point TP111 for ground added and voltage level added in power net names R7588 mounted for POR, R7700 provision added

1.0

# Title

# Project

# Designed by eInfochips

Monday, April 15, 2019 | 27 | 30

# Arrow_iMX8XML_RD

# REVISION HISTORY 1

# Title

# Project

# Designed by eInfochips

Monday, April 15, 2019 | 27 | 30

# Arrow_iMX8XML_RD

# REVISION HISTORY 1

# Title

# Project

# Designed by eInfochips

Monday, April 15, 2019 | 27 | 30

# Arrow_iMX8XML_RD

# REVISION HISTORY 1

D | D
C | C
B | B
A | A
PCB REV | SCH REV | CHANGE DESCRIPTION | DATE | AUTHOR

# RIVISION HISTORY 2

0.4 | Debug LED indication from page 25 removed (D10,D11,D28,D29) | 13/08/2018 | eInfochips
| Cover page modified for revision and I2C table updated with part name instead of part number At GPIO table, GPIO with 3.3V level highlighted in Bold text Mode pin pull down provision added at U227 and U228 C9796 added for more filtering and proper current sensing U16 and U243 added for I2C level translator ESD added on JTAG connector and U227, U228, U203, U229 symbol updated Net name updated for CSI signals at page 24 10K Pull up added at ADMA_I2C2_SCL_3V3, Duplicate pull up at ADMA_I2C2_SCL removed L11 power changed to 3.3V for GPIO, one level translator from page 8 removed Security IC U244 added, I2C table updated accordingly As per 96boards recommendation, FAN connector J5018 added Six mounting holes added instead of four GPIO location updated at processor pin no D10,H10 and A11 ADI comments(8 August) implemented, Level translators updated with new parts Cypress Comments (9 August) implemented - Decoupling cap added and crystal changed FB1712 removed as not required As per ADI comment, Inductor L34 value and related component values are changed
0.5 | Cypress Review comment(14Aug) implemented, GPIO table updated | 20/09/2018 | eInfochips
| Chassis ground seperated for each Metal connector, FAN connector part changed and MOSFET added ADP2386 regulator updated as per desing fille calculator provided by ADI I2C level translator and GPIO level tranlator removed and 3.3V level signals from porcessor used ITE comments for LVDS to HDMI section implemented, J5.11 and J5.13 UART removed ADP2386 ground separated for AGND and DGND as per ADI comment, 12pF at Y6 added' SW_CTRL_GPIO4_15 added at page number 20 for firmware control, ETH LED indication logic changed GPIO3_08 used for extra clock on high speed connector, U13.p1 pin maded NC
| VDD_A35 and VDD_GPU decoupling cap added as per MEK design, USB Mirco-AB connector part changed R249 made DNP, Crystal Y7 added and CTS of module is grounded as per LSR comment Connector J13 part number and symbol updated, R7795 added, J1001 part number changed USB port connection swapped for easy layout, shield clips added, OTG power added through Q18 and Q19 One more DMIC added at ESAI port as SAI2 and SAI3 ports is not confirmed for clock generation

DSI to HDMI chip replaced at LVDS to HDMI section, More capacitors at DMIC supply added at page 16

0.6 | USB Switch protection provision from HUB added, J17,U47,U54 symbol updated, SS cap location changed | 04/10/2018 | eInfochips
Grounding scheme at ADP5023 and LTM4643 changed, R325,R326 added, U40 nets changed, R187 mounted
| R100,R198,R199,R202,R203 value changed, DSI0 ESD connection changed, EMI filter on HDMI added

R317 and R318 position changed, R327 and TP42 added, 33pF added on SIM lines,U11 symbol changed

U40 part changed, All DMIC connection changed to ESAI port, Shield clip10,12 and 14 removed

1.0 | Gerber released to the fabricator | 04/10/2018 | eInfochips

1.0

# Title

# Project

# Designed by eInfochips

Monday, April 15, 2019 | 28 | 30

# Arrow_iMX8XML_RD

# REVISION HISTORY 2

# Title

# Project

# Designed by eInfochips

Monday, April 15, 2019 | 28 | 30

# Arrow_iMX8XML_RD

# REVISION HISTORY 2

# Title

# Project

# Designed by eInfochips

Monday, April 15, 2019 | 28 | 30

# Arrow_iMX8XML_RD

# REVISION HISTORY 2

D | D
C | C
B | B
A | A
PCB REV | SCH REV | CHANGE DESCRIPTION | DATE | AUTHOR

# RIVISION HISTORY 3

2.0 | USB HUB resistor R24 made DNP and R148 mounted | 20/12/2018 | eInfochips
| SD Card Detection logic corrected, Pulled down CD pin and Pulled up SWB FAN Drain and Source pin swaped MIC signal DMIC1_I2S_WS swapped to FSR of processor, TP49 added for FST Added PMIC in schematic. Level translators, ON/OFF Transistor (U55) & associated resistors removed Replaced QUAD NOR to OCTAL NOR and corrected Processor side pins nets to get Data4 to Data7 lines Removed SD_SELECT MOSFET due to addition of PMIC Assigned new location to 5 GPIOs Added 12 to 5V and 5V to 1.2V,3.3V Power converter section

2.0

# Updated GPIO details in Processor Symbol and match with the net name

# Make JTAG to be DNP

Updated necessary correction for UART, Assigned full UART to BT.

# USB ILIMIT: R125, R128 removed, added Pull-ups to /FAULT pins I2S interface provision added for HDMI Audio

# EN & FAULT connection is removed for OTG ILIMIT IC

# GPIO tables are updated Removed R3588, R3587 & R129 pull-ups of USB ILIMIT USB_FAULT

# Placed capacitors at SDIO clock of WIFI-BT & SD Card

Added 50 Ohm series termination for Ethernet MDC/MDIO signals | 08/01/2019 | eInfochips

# Used 0603 package resistors for R355 and R356, Removed R37, C33, R117 Changed R32 package from 0201 to 0402

11/01/2019

# R3584 changed to 100K & R74 changed to 4.7K

FAN Supply changed from EXT_VCC_5V0 to VCC_EXT_5V0 and placed FAN to next page | | eInfochips

# Changed USB OTG shield name Removed connection between USBHUB & ILIMIT ICs & assigned TPs at Hub side Removed senseing signals form USB ILIMIT & pulled /FAULT up. EN connected directly to 5V

# Changes from Alpha to Beta are highlighted with Green color in GPIO table Value changed for R297 to have correct input low voltage limit Added pull-up at PD of ADV7535 IC Updated R/C values in Buck Regulator as per sheet shared by ADI

# Added SPI NOR 33E series termination resistors as per SI simulation

Updated MIC series termination resistor values to 49E as per datasheet | 25/01/2019 | eInfochips
Comboned Shiled GND of All High-speed Connectors Part Number of D13 updated.

# Updated PMIC LDO output caps from 2.2uF to 4.7uF as per comments form NXP

# Title

# Project

# Designed by eInfochips

Monday, April 15, 2019 | 29 | 30

# Arrow_iMX8XML_RD

# REVISION HISTORY 2

# Title

# Project

# Designed by eInfochips

Monday, April 15, 2019 | 29 | 30

# Arrow_iMX8XML_RD

# REVISION HISTORY 2

# Title

# Project

# Designed by eInfochips

Monday, April 15, 2019 | 29 | 30

# Arrow_iMX8XML_RD

# REVISION HISTORY 2

PCB REV | SCH REV | CHANGE DESCRIPTION | DATE | AUTHOR

# RIVISION HISTORY 4

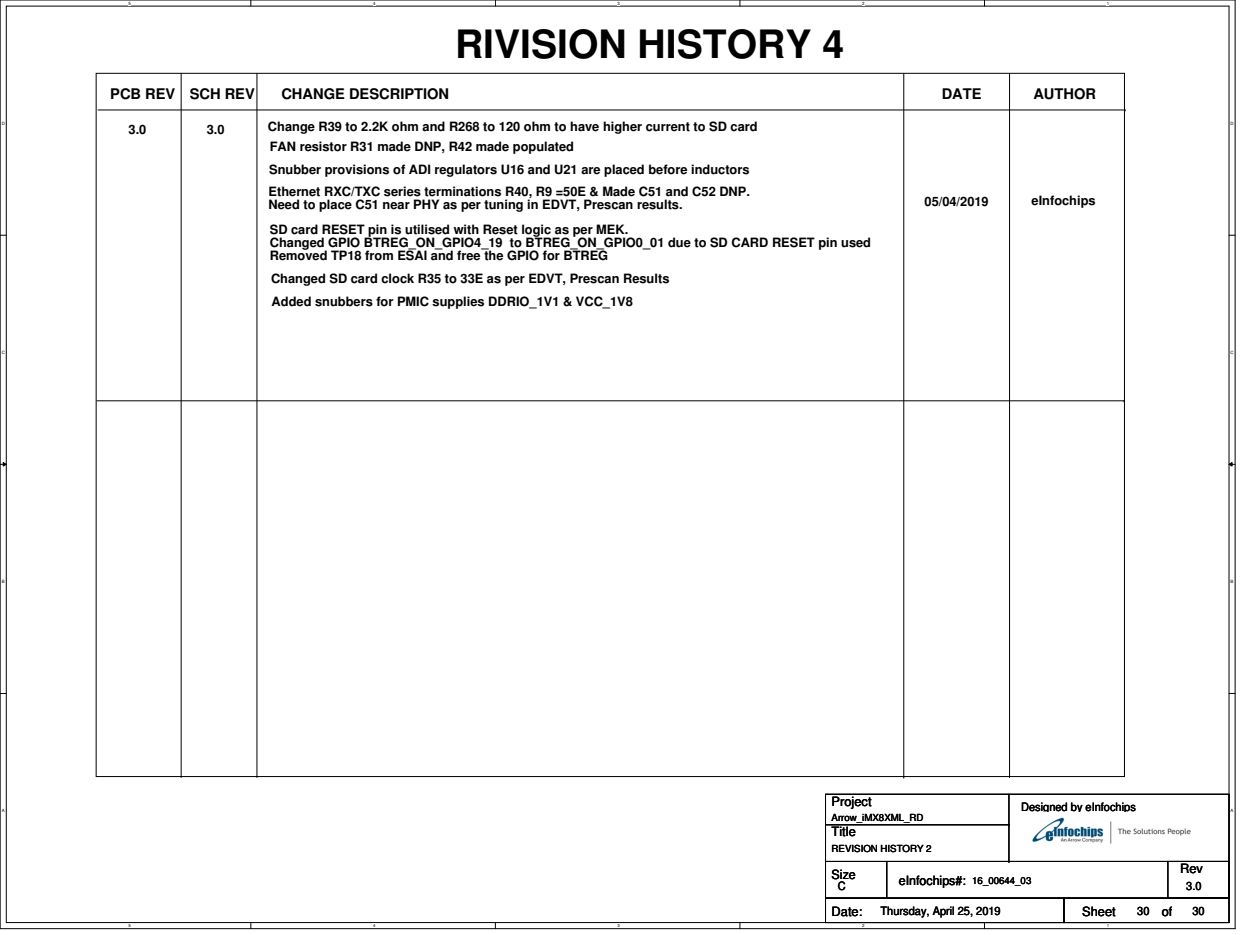
[picture p113: page 30]

3.0 Change R39 to 2.2K ohm and R268 to 120 ohm to have higher current to SD card

FAN resistor R31 made DNP, R42 made populated
Snubber provisions of ADI regulators U16 and U21 are placed before inductors
Ethernet RXC/TXC series terminations R40, R9 =50E & Made C51 and C52 DNP.
Need to place C51 near PHY as per tuning in EDVT, Prescan results.

SD card RESET pin is utilised with Reset logic as per MEK.
Changed GPIO BTREG_ON_GPIO4_19 to BTREG_ON_GPIO0_01 due to SD CARD RESET pin used
Removed TP18 from ESAI and free the GPIO for BTREG
Changed SD card clock R35 to 33E as per EDVT, Prescan Results
Added snubbers for PMIC supplies DDRIO_1V1 & VCC_1V8
